rlhahn/power_distro/Gerbers/IonTrapPowerDistroBOM_RevB-6-25-2018.xlsx

Power Distro Rev B 6-25-2018
QTY | REF | PACKAGE | VALUE | COLOR | COST | DIELECTRIC | MFG | MPN | PRICE | TOLERANCE | VENDOR | VOLTAGE | VPN
14 | C1,C5,C7,C9,C13,C15,C17,C31,C37,C39,C43,C49,C55,C57, | CAP-SIZE_D/E_EIA7343 | 10U |  | 1.5 | TANT | AVX | TAJD-SERIES |  |  | DIGIKEY | 36V
6 | C2,C10,C18,C32,C44,C50, | CAP-SIZE_D/E_EIA7343 | 10U |  | 1.5 | TANT | AVX | TAJD-SERIES |  |  | DIGIKEY | 6.3V
20 | C3,C4,C6,C8,C11,C12,C14,C16,C19,C20,C33,C34,C38,C40,C45,C46,C51,C52,C56,C58, | R-0805 | 100N |  | 0.074 | X7R |  |  |  |  |  | 6.3V
10 | HS1,HS2,HS3,HS4,HS5,HS6,HS7,HS8,HS9,HS10, | AAVID_7106 | HEATSINK_AAVID_7106 |  |  |  | AAVID | 7106DG | 1.44 |  | DIGIKEY |  | HS412-ND
8 | J1,J6,J11,J16,J33,J34,J35,J36, | CUI_RCJ-02X | CONN_RCA | BLK |  |  | CUI INC | RCJ-021 | 0.88 |  | DIGIKEY |  | CP-1406-ND
8 | J2,J7,J12,J17,J37,J38,J39,J40, | CUI_RCJ-02X | CONN_RCA | BLU |  |  | CUI INC | RCJ-025 | 0.88 |  | DIGIKEY |  | CP-1410-ND
8 | J3,J8,J13,J18,J29,J30,J31,J32, | CUI_RCJ-02X | CONN_RCA | GRN |  |  | CUI INC | RCJ-026 | 0.88 |  | DIGIKEY |  | CP-1411-ND
8 | J4,J9,J14,J19,J25,J26,J27,J28, | CUI_RCJ-02X | CONN_RCA | RED |  |  | CUI INC | RCJ-022 | 0.88 |  | DIGIKEY |  | CP-1407-ND
8 | J5,J10,J15,J20,J21,J22,J23,J24, | CUI_RCJ-02X | CONN_RCA | WHT |  |  | CUI INC | RCJ-023 | 0.88 |  | DIGIKEY |  | CP-1408-ND
1 | J41, | 2X14X0.100_HDR | HDR_2X14X100 |  |  |  | SULLINS | PRPC014DAAN-RC | 1 |  | DIGIKEY |  | S2011EC-14-ND
12 | J42,J43,J44,J45,J46,J47,J48,J49,J50,J51,J52,J53, | OST_SCREWTERM_3.5MM_2POS | CONN_SCREWTERM_3.5MM_2POS |  |  |  | ON SHORE TECH | OSTTE020161 | 0.92 |  | DIGIKEY |  | ED2635-ND
2 | R1,R2, | R-0805 | 100K |  |  |  |  |  | 0.059 | 1%
4 | R3,R4,R7,R8, | R-0805 | 300K |  |  |  |  |  | 0.059
2 | R5,R6, | R-0805 | 480K |  |  |  |  |  | 0.059
2 | R9,R10, | R-0805 | 100K |  |  |  |  |  | 0.059
10 | R11,R12,R13,R14,R15,R16,R17,R18,R19,R20, | R-0805 | 2K |  |  |  |  |  | 0.059 | 1%
4 | R21,R22,R23,R24, | R-0805 | 1.1K |  |  |  |  |  | 0.059 | 1%
4 | R25,R26,R27,R28, | R-0805 | 13K |  |  |  |  |  | 0.059 | 1%
2 | R29,R30, | R-0805 | 24K |  |  |  |  |  | 0.059 | 1%
6 | U1,U3,U5,U6,U8,U9, | DD-7_LINEARTECH | REG_LT3081 |  |  |  | LINEAR TECH | LT3081ER | 6.25 |  | DIGIKEY |  | LT3081ER#PBF-ND
4 | U2,U4,U7,U10, | DD-7_LINEARTECH | REG_LT3091 |  |  |  | LINEAR TECH | LT3091IR | 8.12 |  | DIGIKEY |  | LT3091IR#PBF-ND
