rlhahn/power_distro/Datasheets/00_LDO Compare.xlsx

Sheet: Sheet1
Vendor | Part | Vin Max | Vout | Iout | PSRR | Noise uv | Pakage
Analog Devices | ADP3339 | 6 | 1.5,1.8,2.5,2.85,3,3.3,5 | 1.5 | 12.00 | 95.00 | 3 ld SOT-223
Analog Devices | ADP3330 | 12 | 2.5,2.75,2.85,3.0,3.3,3.6,5.0 | 0.2 | 13.00 | 47.00 | 6 ld SOT-23
Analog Devices | ADP3331 | 12 | Not Applicable | 0.2 | 15.00 | 47.00 | 6 ld SOT-23
Analog Devices | ADP163 | 5.5 | Adjustable | 0.15 | 20.00 | 100.00 | 5 ld TSOT
Analog Devices | ADP162 | 5.5 | 1.2,1.5,1.8,2.1,2.5,2.75,2.8,2.85,3.0,3.3,4.2 | 0.15 | 20.00 | 100.00 | 4 ball WLCSP (0.965x0.965mm),5 ld TSOT
Analog Devices | ADP161 | 5.5 | Adjustable | 0.15 | 20.00 | 100.00 | 5 ld TSOT
Analog Devices | ADP160 | 5.5 | 1.2,1.5,1.8,2.1,2.5,2.75,2.8,2.85,3.0,3.3,4.2 | 0.15 | 20.00 | 100.00 | 4 ball WLCSP (0.965x0.965mm),5 ld TSOT
Analog Devices | ADP166 | 5.5 | 1.2,1.8,2.2,2.3,2.85,3,3.3 | 0.15 | 20.00 | 105.00 | 4 ball WLCSP (0.965x0.965mm),5 ld TSOT,6 ld LFCSP (2x2 w/1x1.6 EP)
Analog Devices | ADP165 | 5.5 | 1.2,1.8,2.2,2.3,2.85,3,3.3 | 0.15 | 20.00 | 105.00 | 4 ball WLCSP (0.965x0.965mm),5 ld TSOT,6 ld LFCSP (2x2 w/1x1.6 EP)
Analog Devices | ADP151 | 5.5 | 1.1,1.2,1.5,1.8,2.1,2.5,2.6,2.75,2.8,2.85,3.0,3.3 | 0.2 | 25.00 | 9.00 | 4 ball WLCSP (0.8x0.8mm),5 ld TSOT,6 ld LFCSP (2x2 w/1x1.6 EP)
Monolithic Power | MP2002 | 6.5 | 5 | 500 | 26.00 | - | QFN2x3-8
Analog Devices | ADP3336 | 12 | Not Applicable | 0.5 | 28.00 | 27.00 | 8 ld MSOP
Analog Devices | ADP150 | 5.5 | 1.8,2.5,2.6,2.75,2.8,2.85,3.0,3.3 | 0.15 | 30.00 | 9.00 | 4 ball WLCSP (0.8x0.8mm),5 ld TSOT
Linear Tech | LT3071 | 3 | Adj | 5 | 30.00 | 25.00 | 4x5 QFN-28
Linear Tech | LT3080 | 36 | Adj | 1.1 | 30.00 | 40.00 | 3x3 DFN-8,DDPAK-5,MS-8E,SOT-223,TO-220
Analog Devices | ADM7172 | 6.5 | 1.3,1.8,2.5,3.0,3.3,4.2,5.0 | 2 | 31.00 | 5.00 | 8 ld LFCSP (3x3mm 2.44x1.6EP),CHIPS OR DIE
Analog Devices | ADM7171 | 6.5 | 1.3,1.8,2.5,3.0,3.3,4.2,5.0 | 1 | 31.00 | 5.00 | 8 ld LFCSP (3x3mm 2.44x1.6EP)
Analog Devices | ADM7170 | 6.5 | 1.3,1.8,2.5,3.0,3.3,4.2,5.0 | 0.5 | 31.00 | 5.00 | 8 ld LFCSP (3x3mm 2.44x1.6EP)
Analog Devices | ADP3300 | 12 | 2.7,2.85,3.0,3.2,3.3,5.0 | 0.05 | 32.00 | 30.00 | 6 ld SOT-23
Analog Devices | ADP3303 | 12 | 3.0,3.2,3.3,5.0 | 0.2 | 32.00 | 30.00 | 8 ld SOIC
Analog Devices | ADP3301 | 12 | 2.7,3,3.2,3.3,5 | 0.1 | 32.00 | 30.00 | 8 ld SOIC
Analog Devices | ADP3309 | 12 | 2.5,2.7,2.85,2.9,3.0,3.3,3.6 | 0.1 | 32.00 | 100.00 | 5 ld SOT-23
Analog Devices | ADP1765 | 1.98 | 0.85,0.9,0.95,1.0,1.1,1.2,1.25,1.3,1.5 | 5 | 33.00 | 2.00 | 16 ld LFCSP (3x3x0.75mm (w/1.7mm EP)
Analog Devices | ADP1764 | 1.98 | 0.85,0.9,0.95,1.0,1.1,1.2,1.25,1.3,1.6 | 4 | 35.00 | 2.00 | 16 ld LFCSP (3x3x0.75mm (w/1.7mm EP)
Analog Devices | HMC976 | 5.5 | 4.8,5.0 | 0.4 | 35.00 | 9.00 | 16 ld QFN (3x3mm w/1.7mm ep)
Monolithic Power | MP20048 | 5.5 | 5 | 250 | 35.00 | 37.00 | TSOT23-5
Analog Devices | ADP1763 | 1.98 | 0.9,0.95,1,1.1,1.2,1.25,1.3,1.5 | 3 | 37.00 | 2.00 | 16 ld LFCSP (3x3mm, 1.6mm exposed pad)
Analog Devices | ADP3334 | 11 | Not Applicable | 0.5 | 38.00 | 27.00 | 8 ld LFCSP (3x3mm),8 ld MSOP,8 ld SOIC
Analog Devices | ADP3333 | 12 | 1.5,1.8,2.5,2.77,3,3.15,3.3,5 | 0.3 | 38.00 | 45.00 | 8 ld MSOP
Analog Devices | ADP3335 | 12 | 1.8,2.5,2.85,3.3,5 | 0.5 | 38.00 | 47.00 | 8 ld LFCSP (3x3mm),8 ld MSOP
Analog Devices | ADP3338 | 8 | 1.5,1.8,2.5,2.85,3,3.3,5 | 1 | 38.00 | 95.00 | 3 ld SOT-223
Analog Devices | ADP1708 | 5.5 | Not Applicable | 1 | 38.00 | 125.00 | 8 ld LFCSP (3x3mm 1.74x1.45mm EP),8 ld SOIC-EP (2.41mm Exposed pad)
Analog Devices | ADP1707 | 5.5 | 1,1.1,1.2,1.3,1.5,1.8,2.5,3,3.3 | 1 | 38.00 | 125.00 | 8 ld LFCSP (3x3mm),8 ld SOIC-EP (2.41mm Exposed pad)
Analog Devices | ADP1706 | 5.5 | 0.75,0.8,0.9,1,1.05,1.1,1.15,1.2,1.3,1.5,1.8,2.5,3,3.3 | 1 | 38.00 | 125.00 | 8 ld LFCSP (3x3mm 1.74x1.45mm EP),8 ld LFCSP (3x3mm),8 ld SOIC-EP (2.41mm Exposed pad)
Analog Devices | ADP1762 | 1.98 | 0.9,0.95,1,1.1,1.2,1.25,1.3,1.5 | 2 | 39.00 | 2.00 | 16 ld LFCSP (3x3mm, 1.6mm exposed pad)
Analog Devices | ADP7183 | -5.5 | -0.5,-1,-1.2,-1.5,-1.8,-2.5,-3,-3.3,Adjustable | -0.3 | 40.00 | 4.00 | 8 ld LFCSP (2x2 w/1.5x1mm EP)
Analog Devices | ADP7185 | -5.5 | -0.5,-1,-1.2,-1.5,-1.8,-2.5,-3,-3.3,Adjustable | -0.5 | 40.00 | 5.00 | 8 ld LFCSP (2x2 w/1.5x1mm EP)
Analog Devices | ADP323 | 5.5 | Not Applicable | 0.2 | 40.00 | 14.00 | 16 ld LFCSP (3x3mm, 1.5mm exposed pad)
Analog Devices | ADP322 | 5.5 | 1.2,1.5,1.8,2.5,2.8,3.3 | 0.2 | 40.00 | 14.00 | 16 ld LFCSP (3x3mm, 1.6mm exposed pad)
Analog Devices | ADP1755 | 3.6 | Adjustable | 1.2 | 40.00 | 23.00 | 16 ld LFCSP (4x4mm, 2.1mm exposed pad)
Analog Devices | ADP1754 | 3.6 | 0.75,1.0,1.1,1.2,1.3,1.5,1.8,2.5 | 1.2 | 40.00 | 23.00 | 16 ld LFCSP (4x4mm, 2.1mm exposed pad)
Analog Devices | ADP1753 | 3.6 | Adjustable | 0.8 | 40.00 | 23.00 | 16 ld LFCSP (4x4x.85mm, 2.10mm exposed pad)
Analog Devices | ADP1752 | 3.6 | 0.75,1.0,1.1,1.2,1.25,1.5,1.8,2.5 | 0.8 | 40.00 | 23.00 | 16 ld LFCSP (4x4x.85mm, 2.10mm exposed pad)
Analog Devices | ADP1741 | 3.6 | Not Applicable | 2 | 40.00 | 23.00 | 16 ld LFCSP (4x4mm, 2.1mm exposed pad)
Analog Devices | ADP1740 | 3.6 | 0.75,1.0,1.1,1.2,1.3,1.5,1.8,2.5 | 2 | 40.00 | 23.00 | 16 ld LFCSP (4x4mm, 2.1mm exposed pad)
Analog Devices | ADP320 | 5.5 | 1.5,1.8,3.3 | 0.2 | 40.00 | 24.00 | 16 ld LFCSP (3x3mm, 1.6mm exposed pad)
Analog Devices | ADP225 | 5.5 | Adjustable | 0.3 | 40.00 | 27.00 | 8 ld LFCSP (2x2, w/1.6 x1.0 ep)
Analog Devices | ADP224 | 5.5 | 1.8,2.8 | 0.3 | 40.00 | 27.00 | 8 ld LFCSP (2x2, w/1.6 x1.0 ep)
Analog Devices | ADP222 | 5.5 | 1.2,1.5,1.8,2.5,2.7,2.8,3.0,3.3 | 0.3 | 40.00 | 27.00 | 8 ld LFCSP (2x2, w/1.6 x1.0 ep)
Analog Devices | ADP223 | 5.5 | Not Applicable | 0.3 | 40.00 | 27.00 | 8 ld LFCSP (2x2, w/1.6 x1.0 ep)
Analog Devices | ADP221 | 5.5 | 1.8,2.8 |  | 40.00 | 27.00 | BUMPED BARE DIE SALES
Analog Devices | ADP220 | 5.5 | 1.1,1.2,1.8,2.3,2.35,2.6,2.7,2.75,2.8,3,3.3 |  | 40.00 | 27.00 | 6 Ball WLCSP (1.0x1.5mm)
Analog Devices | ADP5030 | 5.5 | 1.2,2.8 | 0.2 | 40.00 | 50.00 | 16 Ball WLCSP(1.56X1.56)
Analog Devices | ADP1761 | 1.98 | 0.9,0.95,1,1.1,1.2,1.25,1.3,1.5 | 1 | 41.00 | 2.00 | 16 ld LFCSP (3x3mm, 1.6mm exposed pad)
Monolithic Power | MPQ2013A | 40 | 15 | 150 | 41.00 | - | QFN2x2-6QFN3x3-8
Monolithic Power | MP2013A | 40 | 15 | 150 | 41.00 | - | QFN2x2-6 QFN3x3-8
Monolithic Power | MP2011A | 24 | 15 | 150 | 41.00 | - | QFN2x2-6
Monolithic Power | MP2015A | 24 | 15 | 150 | 41.00 | - | QFN2x2-6 QFN3x3-8 TSOT23-4
Linear Tech | LTC3026-1 | 5 | Adj | 1.5 | 42.00 | 110.00 | 3x3 DFN-10,MS-10E
Linear Tech | LTC3026 | 5.5 | Adj | 1.5 | 42.00 | 110.00 | 3x3 DFN-10,MS-10E
Analog Devices | ADM7160 | 5.5 | 1.8,2.5,3.3 | 0.2 | 43.00 | 3.00 | 5 ld TSOT,6 ld LFCSP (2x2 w/1x1.6 EP)
Analog Devices | ADP7159 | 5.5 | Adjustable | 2 | 45.00 | 1.60 | 10 ld LFCSP (3x3mm),8 ld SOIC-EP
Analog Devices | ADP7182 | -28 | -1.2,-1.5,-1.8,-2.5,-3,-5,5 | -0.2 | 45.00 | 18.00 | 5 ld TSOT,6 ld LFCSP (2x2 w/1x1.6 EP),8 ld LFCSP (3x3mm 1.74x1.45mm EP),LFCSP:LEADFRM CHIP SCALE
Monolithic Power | MP2019 | 40 | 15 | 300 | 45.00 | - | SOIC-8
Monolithic Power | MP2014 | 40 | 15 | 500 | 45.00 | - | TO252-5
Monolithic Power | MPQ2019 | 40 | 15 | 300 | 45.00 | - | SOIC-8
Analog Devices | ADP7158 | 5.5 | 1.2,1.8,2.5,2.8,3.0,3.3 | 2 | 50.00 | 1.60 | 10 ld LFCSP (3x3mm),8 ld SOIC-EP
Analog Devices | ADP7142 | 40 | 1.8,2.5,3.3,5 | 0.2 | 50.00 | 11.00 | 5 ld TSOT,6 ld LFCSP (2x2 w/1x1.6 EP),8 ld SOIC-EP
Analog Devices | ADP7118 | 20 | 1.8,2.5,3.3,5 | 0.2 | 50.00 | 11.00 | 5 ld TSOT,6 ld LFCSP (2x2 w/1x1.6 EP),8 ld SOIC-EP
Analog Devices | ADP7112 | 20 | 1.8,2.5,3.3,5 | 0.2 | 50.00 | 11.00 | 6-Ball Wafer Level Chip Scale Package [WLCSP]
Linear Tech | LTC1844 | 6.5 | Adj,1.5, 1.8, 2.5,2.8, 3.3 | 0.15 | 50.00 | 60.00 | SOT-23
Monolithic Power | MP8903 | 6.5 | 5 | 150 | 50.00 | - | QFN2x2-8TSOT23-5
Monolithic Power | MPQ8903 | 6.5 | 5 | 150 | 50.00 | - | TSOT23-5
Monolithic Power | MP2016 | 42 | 40 | 30 | 50.00 | - | TSOT23-5QFN2x3-8
Monolithic Power | MP2000 | 6 | 5 | 150 | 50.00 | - | TSOT23-5
Analog Devices | ADP7157 | 5.5 | Adjustable | 1.2 | 55.00 | 1.60 | 10 ld LFCSP (3x3mm),8 ld SOIC-EP
Analog Devices | ADM7151 | 16 | Not Applicable | 0.8 | 55.00 | 1.60 | 8 ld LFCSP (3x3mm, 1.6x2.34mm exposed pad,8 ld SOIC-EP (2.41mm Exposed pad)
Analog Devices | ADM7150 | 16 | 1.8,2.8,3.0,3.3,4.5,4.8,5.0 | 0.8 | 55.00 | 1.60 | 8 ld LFCSP (3x3mm, 1.6x2.34mm exposed pad,8 ld SOIC-EP (2.41mm Exposed pad)
Monolithic Power | MP20045 | 5.5 | 5 | 1000 | 56.00 | 13.00 | QFN3x3-8SOIC8E
Analog Devices | ADM7155 | 5.5 | Not Applicable | 0.6 | 57.00 | 1.60 | 8 ld LFCSP (3x3mm 2.44x1.6EP),8 ld SOIC-EP
Analog Devices | ADM7154 | 5.5 | 1.2,1.8,2.5,2.8,3.0,3.3 | 0.6 | 58.00 | 1.60 | 8 ld LFCSP (3x3mm 2.44x1.6EP),8 ld SOIC-EP
Analog Devices | ADP7156 | 5.5 | 1.2,1.8,2.5,2.8,3.0,3.3 | 1.2 | 60.00 | 1.60 | 10 ld LFCSP (3x3mm),8 ld SOIC-EP
Analog Devices | HMC860 | 5.6 | 3.05,4.5,5.0 | 0.24 | 60.00 | 5.50 | 16 ld QFN (3x3mm w/1.7mm ep)
Analog Devices | HMC1060 | 5.6 | 3.3,5.0 | 0.5 | 60.00 | 9.00 | 16 ld QFN (3x3mm w/1.7mm ep)
Linear Tech | LT3030 | 20 | Adj | 0.75 | 60.00 | 20.00 | 4x5 QFN-28,TSSOP-20
Linear Tech | LT1529 | 15 | Adj, 3.3, 5 | 3 | 62.00 |  | DDPAK-5,TO-220
Monolithic Power | MPQ20051-AEC1 | 5.5 | 5 | 1000 | 63.00 | 13.00 | QFN3x3-8
Monolithic Power | MPQ20051 | 5.5 | 5 | 1000 | 63.00 | 13.00 | QFN3x3-8
Monolithic Power | MPQ20056 | 5.5 | 5 | 250 | 63.00 | 13.00 | QFN2x2-8TSOT23-5
Monolithic Power | MPQ20056-AEC1 | 5.5 | 5 | 250 | 63.00 | 13.00 | QFN2x2-8TSOT23-5
Monolithic Power | MP20051 | 5.5 | 5 | 1000 | 63.00 | 13.00 | SOIC8EQFN3x3-8
Linear Tech | LT1963A | 20 | Adj, 1.5, 1.8, 2.5, 3.3 | 1.5 | 63.00 | 40.00 | DDPAK-5,SO-8,SOT-223,TO-220,TSSOP-16
Linear Tech | LT1764A | 20 | Adj, 1.8, 2.5, 3.3 | 3 | 63.00 | 40.00 | DDPAK-5,TO-220,TSSOP-16
Linear Tech | LT3020 | 10 | Adj, 1.2, 1.5, 1.8 | 0.1 | 64.00 | 245.00 | 3x3 DFN-8,MS-8
Linear Tech | LT1129 | 30 | Adj, 3.3, 5 | 0.7 | 64.00 |  | DDPAK-5,SO-8,SOT-223,TO-220
Monolithic Power | MP20056 | 5.5 | 5 | 250 | 65.00 | 13.00 | QFN2x2-8TSOT23-5
Linear Tech | LT3027 | 20 | Adj | 0.1 | 65.00 | 20.00 | 3x3 DFN-10,MS-10E
Linear Tech | LT3023 | 20 | Adj | 0.1 | 65.00 | 20.00 | 3x3 DFN-10,MS-10E
Linear Tech | LT1761 | 20 | Adj, 1.2, 1.5, 1.8, 2, 2.5, 2.8, 3, 3.3, 5 | 0.1 | 65.00 | 20.00 | SOT-23
Linear Tech | LT1762 | 20 | Adj, 2.5, 3, 3.3, 5 | 0.15 | 65.00 | 20.00 | MS-8
Linear Tech | LT1962 | 20 | Adj,1.5, 1.8, 2.5, 3, 3.3, 5 | 0.3 | 65.00 | 20.00 | MS-8
Linear Tech | LT1763 | 20 | Adj,1.5, 1.8, 2.5, 3, 3.3, 5 | 0.5 | 65.00 | 20.00 | 4x3 DFN-12,SO-8
Linear Tech | LT3028 | 20 | Adj | 0.5 | 65.00 | 20.00 | 5x3 DFN-16,TSSOP-16
Linear Tech | LT3024 | 20 | Adj | 0.5 | 65.00 | 20.00 | 4x3 DFN-12,TSSOP-16
Monolithic Power | MP2030 | 5.5 | 3.8 | 3000 | 65.00 | 80.00 | QFN3x3-10QFN5x5-32
Monolithic Power | MP2005 | 5.5 | 4 | 800 | 65.00 | - | QFN2x3-8
Monolithic Power | MP8904 | 6.5 | 5 | 500 | 65.00 | - | QFN2x3-8
Linear Tech | LT3029 | 20 | Adj | 0.5 | 67.00 | 30.00 | 4x3 DFN-16,MS-16E
Linear Tech | LT1528 | 15 | Adj, 3.3 | 3 | 67.00 |  | DDPAK-5,TO-220
Monolithic Power | MP20046 | 5.5 | 3.3 | 2000 | 70.00 | 17.00 | QFN3x3-10SOIC8E
Monolithic Power | MP2040 | 5 | 3.3 | 3000 | 70.00 | 80.00 | QFN3x3-10QFN5x5-32
Linear Tech | LT3008 | 45 | Adj, 1.2, 1.5, 1.8, 2.5, 3.3, 5 | 0.02 | 70.00 | 92.00 | 2x2 DFN-6,SOT-23
Linear Tech | LT3007 | 45 | Adj, 1.2, 1.5, 1.8, 2.5, 3.3, 5 | 0.02 | 70.00 | 92.00 | SOT-23
Linear Tech | LT3014 | 80 | Adj | 0.02 | 70.00 | 115.00 | 3x3 DFN-8,SOT-23
Linear Tech | LT3014B | 80 | Adj | 0.02 | 70.00 | 150.00 | 3x3 DFN-8,SOT-23
Linear Tech | LT3022 | 10 | Adj, 1.2, 1.5, 1.8 | 1 | 70.00 | 165.00 | 5x3 DFN-16,MS-16E
Linear Tech | LT3021 | 10 | Adj, 1.2, 1.5, 1.8 | 0.5 | 70.00 | 300.00 | 5x5 DFN-16,SO-8
Monolithic Power | MP8902 | 6.5 | 5 | 250 | 70.00 | - | QFN2x2-8
Monolithic Power | MP8801 | 6.5 | 5 | 150 | 70.00 | - | TSOT23-5
Monolithic Power | MP8802 | 6.5 | 5 | 250 | 70.00 | - | TSOT23-5
Linear Tech | LT3070 | 3 | Adj | 5 | 72.00 | 25.00 | 4x5 QFN-28
Linear Tech | LT3009 | 20 | Adj, 1.2, 1.5, 1.8, 2.5, 3.3, 5 | 0.02 | 72.00 | 150.00 | 2x2 DFN-6,SC-70
Linear Tech | LT1085-Fixed | 25 | 3.3, 3.6, 5, 12 | 3 | 72.00 |  | DDPAK-3,TO-220
Linear Tech | LT1587 | 7 | Adj, 1.5, 3.3, 3.45, 3.6 | 3 | 72.00 |  | DDPAK-3,TO-220
Linear Tech | LT1084-Fixed | 25 | 3.3, 3.6, 5, 12 | 5 | 72.00 |  | TO-220
Linear Tech | LT3080-1 | 36 | Adj | 1.1 | 75.00 | 40.00 | 3x3 DFN-8,MS-8E
Linear Tech | LT1965 | 20 | Adj, 1.5, 1.8, 2.5, 3.3 | 1.1 | 75.00 | 40.00 | 3x3 DFN-8,DDPAK-5,MS-8E,TO-220
Linear Tech | LT3010 | 80 | Adj | 0.05 | 75.00 | 100.00 | MS-8E
Linear Tech | LT3010-5 | 80 | 5 | 0.05 | 75.00 | 100.00 | MS-8E
Linear Tech | LT3012 | 80 | Adj | 0.25 | 75.00 | 100.00 | 4x3 DFN-12,TSSOP-16
Linear Tech | LT3012B | 80 | Adj | 0.25 | 75.00 | 100.00 | 4x3 DFN-12,TSSOP-16
Linear Tech | LT3013 | 80 | Adj | 0.25 | 75.00 | 100.00 | 4x3 DFN-12,TSSOP-16
Linear Tech | LT3013B | 80 | Adj | 0.25 | 75.00 | 100.00 | 4x3 DFN-12,TSSOP-16
Linear Tech | LT1117 | 15 | Adj, 2.85, 3.3, 5 | 0.8 | 75.00 |  | DDPAK-3,SOT-223
Linear Tech | LT1086 | 25 | Adj, 2.85, 3.3, 3.6, 5, 12 | 1.5 | 75.00 |  | DDPAK-3,TO-220
Linear Tech | LT1085 | 30 | Adj | 3 | 75.00 |  | DDPAK-3,TO-220
Linear Tech | LT1084 | 30 | Adj | 5 | 75.00 |  | TO-220
Linear Tech | LT3045-1 | 20 |  | 0.5 | 76.00 | 0.80 | 3x3 DFN-12,MS-12E
Linear Tech | LT3045 | 20 | Adj | 0.5 | 76.00 | 0.80 | 3x3 DFN-10,MS-12E
Monolithic Power | MP20049 | 6 | - | 150 | 78.00 | 16.00 | WLCSP0.8x0.8-4
Monolithic Power | MP2009 | 6 | - | 120 | 78.00 | 16.00 | SC70-5
Monolithic Power | MPQ8904-AEC1 | 6.5 | 5 | 500 | 78.00 | - | QFN2x3-8
Linear Tech | LT3086 | 40 | Adj | 2.1 | 80.00 | 40.00 | 5x4 DFN-16,DDPAK-7,TO-220,TSSOP-16
Linear Tech | LT1118 | 15 | 2.5, 2.85, 5 | 0.8 | 80.00 |  | SO-8,SOT-223
Linear Tech | LT3055 | 45 | Adj | 0.5 | 85.00 | 25.00 | 4x3 DFN-16,MS-16E
Linear Tech | LT3066 | 45 | Adj | 0.5 | 85.00 | 25.00 | 4x3 DFN-12,MS-12E
Linear Tech | LT3065 | 45 | Adj, 1.2, 1.5, 1.8, 2.5, 3.3, 5 | 0.5 | 85.00 | 25.00 | 3x3 DFN-10,MS-12E
Linear Tech | LT3061 | 45 | Adj | 0.1 | 85.00 | 30.00 | 2x3 DFN-8,MS-8E
Linear Tech | LT3060 | 45 | Adj, 1.2,1.5, 1.8, 2.5, 3.3, 5, 15 | 0.1 | 85.00 | 30.00 | 2x2 DFN-8,SOT-23
Linear Tech | LT3050 | 45 | Adj, 3.3, 5 | 0.1 | 85.00 | 30.00 | 3x2 DFN-12,MS-12E
Linear Tech | LT3062 | 45 | Adj | 0.2 | 85.00 | 30.00 | 2x3 DFN-8,MS-8E
Linear Tech | LT3063 | 45 | Adj | 0.2 | 85.00 | 30.00 | 2x3 DFN-8,MS-8E
Linear Tech | LT3083 | 23 | Adj | 3 | 85.00 | 40.00 | 4x4 DFN-12,DDPAK-5,TO-220,TSSOP-16
Linear Tech | LT3011 | 80 | Adj | 0.05 | 85.00 | 100.00 | 3x3 DFN-10,MS-12E
Linear Tech | LT3088 | 36 | Adj | 0.8 | 90.00 | 27.00 | 3x3 DFN-8,DDPAK-3,SOT-223
Linear Tech | LT3089 | 36 | Adj | 0.8 | 90.00 | 27.00 | 4x4 DFN-12,DDPAK-7,TSSOP-16
Linear Tech | LT3081 | 36 | Adj | 1.5 | 90.00 | 27.00 | 4x4 DFN-12,DDPAK-7,TO-220,TSSOP-16
Linear Tech | LT3082 | 40 | Adj | 0.2 | 90.00 | 33.00 | 3x3 DFN-8,SOT-223,SOT-23
Linear Tech | LT3085 | 36 | Adj | 0.5 | 90.00 | 40.00 | 2x3 DFN-6,MS-8E
Linear Tech | LT3042 | 20 | Adj | 0.2 | 117.00 | 0.80 | 3x3 DFN-10,MS-10E
Onsemi | 0 | 30 | 3.3 |  |  | 13.2 | SOT-23-3
Analog Devices | ADP7105 | 20 | 1.8,3.3,5.0 | 0.5 |  | 15.00 | 8 ld LFCSP (3x3mm 1.74x2.38 EP) ,8 ld SOIC-EP (2.41mm Exposed pad)
Analog Devices | ADP7104 | 20 | 1.5,1.8,2.5,3.0,3.3,5.0,9.0,Adjustable | 0.5 |  | 15.00 | 8 ld LFCSP (3x3mm 1.74x2.38 EP) ,8 ld SOIC-EP (2.41mm Exposed pad)
Analog Devices | ADP7102 | 20 | 1.5,1.8,2.5,3.0,3.3,5.0,9.0 | 0.3 |  | 15.00 | 8 ld LFCSP (3x3mm 1.74x2.38 EP) ,8 ld SOIC-EP (2.41mm Exposed pad)
Analog Devices | ADP125 | 5.5 | Not Applicable | 0.5 |  | 25.00 | 8 ld LFCSP (2x2mm w/1.6x1.0 EP),8 ld MSOP_ED
Analog Devices | ADP124 | 5.5 | 1.8,2.5,2.7,2.8,2.85,2.9,3.0,3.3 | 0.5 |  | 25.00 | 8 ld LFCSP (2x2mm w/1.6x1.0 EP),8 ld MSOP_ED,EXPOSSED PAD SOIC
Analog Devices | ADP123 | 5.5 | Not Applicable | 0.3 |  | 25.00 | 5 ld TSOT,6 ld LFCSP (2x2 w/1x1.6 EP)
Analog Devices | ADP122 | 5.5 | 1.8,2,2.5,2.7,2.8,2.85,2.9,3,3.3 | 0.3 |  | 25.00 | 5 ld TSOT,6 ld LFCSP (2x2 w/1x1.6 EP)
Analog Devices | ADP130 | 3.6 | 0.8,1.2,1.5,1.8,2.5 | 0.35 |  | 29.00 | 5 ld TSOT
Onsemi | 0 | 6.5 | 1.5 1.8 2.5 2.8 2.9 3 3.3 | 0.15 |  | 30 | SC-82AB-4 SOT-563
Onsemi | 0 | 6 | 0.9 1.2 1.5 1.8 2.5 2.6 2.8 3 3.1 3.3 | 0.2 |  | 30 | SOT-23-5
Onsemi | 0 | 6 | 0.9 1 1.2 1.25 1.5 1.8 2.5 3 3.3 | 0.3 |  | 30 | SOT-23-5
Analog Devices | ADP172 | 3.6 | 0.9,1,1.2,1.26,1.5,1.65,1.7,1.8,2.1,2.9,3 | 0.3 |  | 30.00 | 4 ball WLCSP (1.02x0.95mm)
Analog Devices | ADP171 | 3.6 | Not Applicable | 0.3 |  | 30.00 | 5 ld TSOT
Analog Devices | ADP170 | 3.6 | 1.2,1.25,1.5,1.8,2.5,2.8 | 0.3 |  | 30.00 | 5 ld TSOT
Onsemi | 0 | 9 | 1.2 1.8 2.5 | 1.5 |  | 37 | SOT-223-4 / TO-261-4
Analog Devices | ADP121 | 5.5 | 1.2,1.5,1.65,1.8,1.875,2.0,2.5,2.8,3.0,3.3 | 0.15 |  | 40.00 | 4 ball WLCSP (.82x.82mm) ,5 ld TSOT
Analog Devices | ADP120 | 5.5 | 1.2,1.5,1.8,2.5,2.8,3,3.3 | 0.1 |  | 40.00
Analog Devices | ADP1713 | 5.5 | 0.75,0.8,0.85,0.9,0.95,1.0,1.05,1.1,1.15,1.2,1.3,1.5,1.8,2.5,3.0,3.3 | 0.3 |  | 40.00 | 5 ld TSOT
Analog Devices | ADP1711 | 5.5 | 0.75,0.8,0.85,0.9,0.95,1.0,1.05,1.1,1.15,1.2,1.3,1.5,1.8,2.5,3.0,3.3 | 0.15 |  | 40.00 | 5 ld TSOT
Onsemi | 0 | 13 | 1.8 2.5 3.3 | 0.3 |  | 46 | SOIC-8 SOT-223-4 / TO-261-4
Onsemi | 0 | 35 | 5 | 1 |  | 50 | D<sup>2</sup>PAK-3 DPAK-3 TO-220-3
Onsemi | 0 | 30 | Adjustable | 0.1 |  | 56 | SOIC-8
Onsemi | 0 | 30 | 8 | 0.1 |  | 60 | SOIC-8
Onsemi | 0 | 35 | 8 | 1 |  | 80 | D<sup>2</sup>PAK-3 DPAK-3 TO-220-3
Onsemi | 0 | 12 | 1.5 1.8 2.5 2.7 2.8 3 3.3 4 5 | 0.08 |  | 89 | SOT-89-3 TSOP-5 / SOT-23-5
Onsemi | 0 | 12 | 1.5 3 5 | 0.08 |  | 90 | SC-82AB-4
Onsemi | 0 | 35 | 9 | 1 |  | 90 | D<sup>2</sup>PAK-3 TO-220-3
Onsemi | 0 | 6 | 1.5 1.8 2.5 2.7 2.8 3 3.1 3.3 3.7 5 | 0.1 |  | 100 | SC-88A
Onsemi | 0 | 6 | 1.3 1.5 1.8 2.5 2.8 3 3.3 3.5 5 | 0.15 |  | 100 | SC-82AB-4
Onsemi | 0 | 6 | 1.5 1.8 2.5 2.7 2.8 3 3.1 3.3 3.7 5 | 0.1 |  | 100 | SC-88A
Onsemi | 0 | 6 | 1.5 1.8 2.5 2.7 2.8 3 3.3 5 | 0.1 |  | 100 | SC-82AB-4
Onsemi | 0 | 6 | 1.5 1.8 2.5 2.7 2.8 3 3.3 5 | 0.1 |  | 100 | SC-82AB-4
Onsemi | 0 | 6 | 1.5 1.8 2.5 2.7 2.8 3 3.3 5 | 0.15 |  | 110 | TSOP-5 / SOT-23-5
Onsemi | 0 | 35 | 12 | 1 |  | 120 | D<sup>2</sup>PAK-3 TO-220-3
Analog Devices | ADP1720 | 28 | 3.3,5.0 | 0.05 |  | 124.00 | 8 ld MSOP
Analog Devices | ADP1716 | 5.5 | 0.75,0.8,0.85,0.9,0.95,1.0,1.05,1.1,1.15,1.2,1.3,1.5,1.8,2.5,3.0,3.3 | 0.5 |  | 125.00 | 8 ld MSOP
Analog Devices | ADP1715 | 5.5 | 0.75,0.8,0.85,0.9,0.95,1.0,1.05,1.1,1.15,1.2,1.3,1.5,1.8,2.5,3.0,3.3 | 0.5 |  | 125.00 | 8 ld MSOP
Onsemi | 0 | 35 | 15 | 1 |  | 150 | D<sup>2</sup>PAK-3 DPAK-3 TO-220-3
Onsemi | 0 | 12 | 3.47 Adjustable | 3 |  | 210 | D<sup>2</sup>PAK-5
Analog Devices | ADP1710 | 5.5 | 0.75,0.8,0.85,0.9,0.95,1,1.05,1.1,1.15,1.2,1.3,1.5,1.8,2.5,3,3.3 | 0.15 |  | 330.00 | 5 ld TSOT
Analog Devices | ADP1714 | 5.5 | 0.75,0.8,0.85,0.9,0.95,1.0,1.05,1.1,1.15,1.2,1.3,1.5,1.8,2.5,3.0,3.3 | 0.3 |  | 380.00 | 5 ld TSOT
Analog Devices | ADP1712 | 5.5 | 0.75,0.8,0.85,0.9,0.95,1,1.05,1.1,1.15,1.2,1.3,1.5,1.8,2.5,3,3.3 | 0.3 |  | 380.00 | 5 ld TSOT
Onsemi | 0 | 18 | Adjustable | 3 |  | 400 | D<sup>2</sup>PAK-5
Onsemi | 0 |  |  |  |  |  | UDFN-8
Onsemi | 0 | 6.5 |  |  |  |  | SOT-23-5
Onsemi | 0 | 6.5 | 2.5 |  |  |  | SOT-23-5
Onsemi | 0 | 6.5 | 3.3 |  |  |  | SOT-23-5
Onsemi | 0 | 6.5 |  |  |  |  | SOT-23-5
Onsemi | 0 | 6.5 | 3.3 |  |  |  | SOT-23-5
Onsemi | 0 | 5.5 |  |  |  |  | DFN-6 SOT-23-5 TSOT-23-6
Onsemi | 0 |  |  |  |  |  | WLCSP-4
Onsemi | 0 | 35 | 5 |  |  |  | TO-220-4 FullPak
Onsemi | 0 | 35 | 12 |  |  |  | TO-220-4 FullPak
Onsemi | 0 | 35 | 3.3 |  |  |  | TO-220-4 FullPak
Onsemi | 0 | 35 |  |  |  |  | TO-220-4 FullPak
Onsemi | 0 | -40 | -1.25 | 1.5 |  |  | TO-220-3
Onsemi | 0 | 35 | 5 |  |  |  | TO-220-4 FullPak
Onsemi | 0 | 35 | 12 |  |  |  | TO-220-4 FullPak
Onsemi | 0 | 35 | 3.3 |  |  |  | TO-220-4 FullPak
Onsemi | 0 |  |  |  |  |  | TO-92-3 LF
Onsemi | 0 | 35 | 5 | 1 |  |  | TO-220-3
Onsemi | 0 | 35 | 5 | 1 |  |  | DPAK-3 TO-220-3
Onsemi | 0 | 35 | 6 | 1 |  |  | TO-220-3
Onsemi | 0 | 35 | 8 | 1 |  |  | DPAK-3 TO-220-3
Onsemi | 0 | 35 | 9 | 1 |  |  | TO-220-3
Onsemi | 0 | 35 | 9 | 1 |  |  | DPAK-3 TO-220-3
Onsemi | 0 | 35 | 10 | 1 |  |  | TO-220-3
Onsemi | 0 | 35 | 10 | 1 |  |  | TO-220-3
Onsemi | 0 | 35 | 12 | 1 |  |  | TO-220-3
Onsemi | 0 | 35 | 12 | 1 |  |  | DPAK-3 TO-220-3
Onsemi | 0 | 35 | 15 | 1 |  |  | TO-220-3
Onsemi | 0 | 35 | 15 | 1 |  |  | TO-220-3
Onsemi | 0 | 35 | 18 | 1 |  |  | TO-220-3
Onsemi | 0 | 40 | 24 | 1 |  |  | TO-220-3
Onsemi | 0 | 40 | 24 | 1 |  |  | TO-220-3
Onsemi | 0 | 30 | 5 | 0.1 |  |  | SOIC-8 SOT-89-3
Onsemi | 0 | 35 | 5 | 0.5 |  |  | DPAK-3 TO-220-3
Onsemi | 0 | 35 | 5 |  |  |  | TO-220-4 FullPak
Onsemi | 0 | 35 | 8 |  |  |  | TO-220-4 FullPak
Onsemi | 0 | 35 | 9 |  |  |  | TO-220-4 FullPak
Onsemi | 0 | 35 | 12 |  |  |  | TO-220-4 FullPak
Onsemi | 0 | 35 | 15 |  |  |  | TO-220-4 FullPak
Onsemi | 0 | 35 | 3.3 |  |  |  | TO-220-4 FullPak
Onsemi | 0 | 15 | 3.3 |  |  |  | DPAK-3
Onsemi | 0 | 20 | 3.3 |  |  |  | DPAK-3
Onsemi | 0 | -35 | -5 | 1 |  |  | TO-220-3
Onsemi | 0 | -35 | -6 | 1 |  |  | TO-220-3
Onsemi | 0 | -35 | -8 | 1 |  |  | TO-220-3
Onsemi | 0 | -35 | -9 | 1 |  |  | TO-220-3
Onsemi | 0 | -35 | -12 | 1 |  |  | TO-220-3
Onsemi | 0 | -35 | -12 | 1 |  |  | TO-220-3
Onsemi | 0 | -35 | -15 | 1 |  |  | TO-220-3
Onsemi | 0 | -35 | -15 | 1 |  |  | TO-220-3
Onsemi | 0 | -35 | -18 | 1 |  |  | TO-220-3
Onsemi | 0 | -35 | -24 | 1 |  |  | TO-220-3
Onsemi | 0 | -30 | -5 | 0.1 |  |  | SOT-89-3 TO-92-3 LF
Onsemi | 0 | -35 | -5 | 0.5 |  |  | DPAK-3 TO-220-3
Onsemi | 0 | -35 | -12 | 0.5 |  |  | DPAK-3
Onsemi | 0 | 60 | 1.25 | 1.5 |  |  | TO-220-3
Onsemi | 0 | 35 | Adjustable | 3 |  |  | TO-220-3
Onsemi | 0 | 30 | 5 | 0.1 |  |  | TO-92-3 TO-92-3 LF
Onsemi | 0 | 35 | 12 | 0.1 |  |  | TO-92-3 TO-92-3 LF
Onsemi | 0 | 35 | 5 | 0.5 |  |  | TO-220-3
Onsemi | 0 | -35 | -5 | 1 |  |  | TO-220-3
Onsemi | 0 | -35 | -9 | 1 |  |  | TO-220-3
Onsemi | 0 | -35 | -10 | 1 |  |  | TO-220-3
Onsemi | 0 | -35 | -12 | 1 |  |  | TO-220-3
Onsemi | 0 | -35 | -15 | 1 |  |  | TO-220-3
Onsemi | 0 | -35 | -18 | 1 |  |  | TO-220-3
Onsemi | 0 | -30 | -5 | 0.1 |  |  | TO-92-3
Onsemi | 0 | -35 | -5 | 0.5 |  |  | TO-220-3
Onsemi | 0 |  |  |  |  |  | SOIC-8
Onsemi | 0 | 15 | 2.85 | 0.8 |  |  | SOIC-8
Onsemi | 0 | 35 | 5 | 1 |  |  | DPAK-3
Onsemi | 0 | 35 | 6 | 1 |  |  | D<sup>2</sup>PAK-3 TO-220-3
Onsemi | 0 | 35 | 6 | 1 |  |  | TO-220-3
Onsemi | 0 | 35 | 8 | 1 |  |  | D<sup>2</sup>PAK-3 DPAK-3 TO-220-3
Onsemi | 0 | 35 | 8 | 1 |  |  | D<sup>2</sup>PAK-3 TO-220-3
Onsemi | 0 | 35 | 9 | 1 |  |  | D<sup>2</sup>PAK-3 TO-220-3
Onsemi | 0 | 35 | 9 | 1 |  |  | TO-220-3
Onsemi | 0 | 35 | 12 | 1 |  |  | D<sup>2</sup>PAK-3 DPAK-3 TO-220-3
Onsemi | 0 | 35 | 12 | 1 |  |  | D<sup>2</sup>PAK-3 TO-220-3
Onsemi | 0 | 35 | 12 | 1 |  |  | DPAK-3
Onsemi | 0 | 35 | 15 | 1 |  |  | D<sup>2</sup>PAK-3 TO-220-3
Onsemi | 0 | 35 | 18 | 1 |  |  | D<sup>2</sup>PAK-3 TO-220-3
Onsemi | 0 | 35 | 18 | 1 |  |  | TO-220-3
Onsemi | 0 | 40 | 24 | 1 |  |  | D<sup>2</sup>PAK-3 TO-220-3
Onsemi | 0 | 40 | 24 | 1 |  |  | TO-220-3
Onsemi | 0 | 10 | 3 | 0.12 |  |  | SOT-89-3
Onsemi | 0 | 10 | 3.3 | 0.12 |  |  | SOT-89-3
Onsemi | 0 | 10 | 4 | 0.12 |  |  | SOT-89-3
Onsemi | 0 | 10 | 5 | 0.12 |  |  | SOT-89-3
Onsemi | 0 | 30 | 5 | 0.1 |  |  | TO-92-3 LF
Onsemi | 0 | 30 | 6 | 0.1 |  |  | TO-92-3
Onsemi | 0 | 35 | 5 | 0.5 |  |  | DPAK-3 TO-220-3
Onsemi | 0 | 35 | 12 | 0.5 |  |  | DPAK-3 TO-220-3
Onsemi | 0 | 35 | 15 | 0.5 |  |  | DPAK-3 TO-220-3
Onsemi | 0 | 35 | 18 | 0.5 |  |  | DPAK-3 TO-220-3
Onsemi | 0 | -35 | -5.2 | 1 |  |  | TO-220-3
Onsemi | 0 | -35 | -5 | 1 |  |  | D<sup>2</sup>PAK-3 TO-220-3
Onsemi | 0 | -35 | -8 | 1 |  |  | TO-220-3
Onsemi | 0 | 12 | 1.5 1.8 2.5 2.7 2.8 2.9 3 3.1 3.2 3.3 5 | 0.15 |  |  | TSOP-5 / SOT-23-5
Onsemi | 0 | 12 | 1.5 1.8 2.5 2.7 2.8 3 3.3 5 | 0.08 |  |  | SC-82AB-4
Onsemi | 0 | 6 | 1.5 1.8 2.1 2.5 2.7 2.8 3 3.3 3.5 5 | 0.08 |  |  | SC-82AB-4
Onsemi | 0 | 6 | 1.5 1.8 2.5 2.7 2.8 3 3.3 5 | 0.08 |  |  | SC-82AB-4
Onsemi | 0 | 12 | 0.8 0.9 1 1.2 | 0.15 |  |  | DFN-6 TSOP-5 / SOT-23-5
Onsemi | 0 | 6.5 | 1.5 1.8 2.5 2.7 2.8 3 3.1 3.3 | 0.15 |  |  | SC-82AB-4 SOT-563
Onsemi | 0 | 6 | 1.5 1.8 2.5 2.7 2.8 3 3.3 5 | 0.1 |  |  | SC-82AB-4
Onsemi | 0 | 6 | 1.5 1.8 2.5 2.7 2.8 3 3.3 5 | 0.1 |  |  | SC-82AB-4
Onsemi | 0 | 6 | 1.3 1.4 1.5 1.8 2.5 2.8 2.9 3 3.1 3.3 3.4 4.5 5 | 0.15 |  |  | TSOP-5 / SOT-23-5
Onsemi | 0 | 40 | Adjustable | 1.5 |  |  | D<sup>2</sup>PAK-3 TO-220-3
Onsemi | 0 | 20 | 3.3 5 12 Adjustable | 0.8 |  |  | DPAK-3 SOIC-8
Onsemi | 0 | 45 | 3.3 5 | 0.15 |  |  | SOIC-20W SOIC-8
Onsemi | 0 | 45 | 5 | 0.15 |  |  | SOIC-14 SOIC-8 SOIC-8 EP TSSOP-14 EP
Onsemi | 0 | 45 | 5 | 0.15 |  |  | SOIC-14 SOIC-8
Onsemi | 0 | 28 | 5 | 0.1 |  |  | SOIC-20W SOIC-8 SOIC-8 EP
Onsemi | 0 | 40 | 5 | 0.1 |  |  | SOIC-8 SOIC-8 EP
Onsemi | 0 |  |  |  |  |  | SOT-23-3
Onsemi | 0 | 12 | 1.4 1.5 1.8 2.5 2.7 2.8 3 3.1 3.2 3.3 3.6 5 | 0.15 |  |  | TSOP-5 / SOT-23-5
Onsemi | 0 | 45 | 5 Adjustable | 0.15 |  |  | SOIC-16W EP SOIC-8
Onsemi | 0 | 45 | 5 | 0.4 |  |  | SOIC-16W EP
Onsemi | 0 | 45 | 3.3 5 | 0.4 |  |  | D<sup>2</sup>PAK-7
Onsemi | 0 | 50 | 2.5, 5.0 | 0.1 |  |  | SOIC-16W EP
Analog Devices | ADP3367 | 16.5 | 5 | 0.3 |  | #VALUE! | 8 ld SOIC
Analog Devices | ADP667 | 16.5 | 5 | 0.25 |  | #VALUE! | 8 ld PDIP,8 ld SOIC
Monolithic Power | MP20075 | 3.6 | - | 3000 | - | - | MSOP8E
Monolithic Power | MP20073 | 6 | - | 2000 | - | - | MSOP8E
Monolithic Power | MP2007 | 6 | 5.5 | 3000 | - | - | MSOP8E
TI | TPS759 (http://www.ti.com/product/TPS759) | 5.5 | 1.5, 1.8, 2.5, 3.3 | 7.5 | 10 | 35 | 155 mm2: 15.24 x 10.16(DDPAK/TO-263), See datasheet (TO-220)
TI | LM138 (http://www.ti.com/product/LM138) | 40 | 32 | 5 | 10 | 37 | 969 mm2: 24.89 x 38.94(TO-3)
TI | LM338 (http://www.ti.com/product/LM338) | 40 | 32 | 5 | 10 | 37 | See datasheet (TO-220)
TI | TPS74 (http://www.ti.com/product/TPS74) | 7 | 1.5, 1.8, 2.5, 3, 3.3 | 0.2 | 10 | 190 | 29 mm2: 6 x 4.9(SOIC)
TI | LP8340 (http://www.ti.com/product/LP8340) | 10 | 9.3 | 1 | 10 | 250 | See datasheet (WSON)
TI | TPS758 (http://www.ti.com/product/TPS758) | 5.5 | 1.5, 1.8, 2.5, 3.3 | 3 | 12 | 35 | 155 mm2: 15.24 x 10.16(DDPAK/TO-263), See datasheet (TO-220)
TI | TPS756 (http://www.ti.com/product/TPS756) | 5.5 | 1.5, 1.8, 2.5, 3.3 | 5 | 12 | 35 | 155 mm2: 15.24 x 10.16(DDPAK/TO-263), See datasheet (TO-220)
TI | TPS757 (http://www.ti.com/product/TPS757) | 5.5 | 1.5, 1.8, 2.5, 3.3 | 3 | 12 | 35 | 155 mm2: 15.24 x 10.16(DDPAK/TO-263), See datasheet (TO-220)
TI | TPS755 (http://www.ti.com/product/TPS755) | 5.5 | 1.5, 1.8, 2.5, 3.3 | 5 | 12 | 35 | 155 mm2: 15.24 x 10.16(DDPAK/TO-263), See datasheet (TO-220)
TI | TPS783 (http://www.ti.com/product/TPS783) | 5.5 | 1.8, 1.9, 2.6, 3, 4.2 | 0.15 | 13 | 86 | 8 mm2: 2.8 x 2.9(SOT-23-THIN)
TI | TPS780 (http://www.ti.com/product/TPS780) | 5.5 | 1.8, 2, 2.3, 2.5, 2.7, 3, 3.3 | 0.15 | 13 | 86 | 8 mm2: 2.8 x 2.9(SOT-23-THIN), See datasheet (WSON)
TI | TPS782 (http://www.ti.com/product/TPS782) | 5.5 | 1.8, 2.2, 2.3, 2.5, 2.7, 2.8, 3, 3.3, 3.6 | 0.15 | 13 | 86 | 8 mm2: 2.8 x 2.9(SOT-23-THIN), See datasheet (WSON)
TI | TPS781 (http://www.ti.com/product/TPS781) | 5.5 | 2, 2.2, 2.5, 3.3 | 0.15 | 13 | 86 | 8 mm2: 2.8 x 2.9(SOT-23-THIN), See datasheet (WSON)
TI | TPS782-Q1 (http://www.ti.com/product/TPS782-Q1) | 5.5 | 2.5, 2.7, 2.8, 3 | 0.15 | 13 | 86 | See datasheet (WSON)
TI | LP4951C (http://www.ti.com/product/LP4951C) | 30 | 29 | 0.1 | 13 | 100 | 29 mm2: 6 x 4.9(SOIC)
TI | LP2954 (http://www.ti.com/product/LP2954) | 30 | 29 | 0.25 | 14 | 80 | 155 mm2: 15.24 x 10.16(DDPAK/TO-263), 29 mm2: 6 x 4.9(SOIC), See datasheet (TO-220)
TI | LP2954A (http://www.ti.com/product/LP2954A) | 30 | 29 | 0.25 | 14 | 80 | 155 mm2: 15.24 x 10.16(DDPAK/TO-263), 29 mm2: 6 x 4.9(SOIC), See datasheet (TO-220)
TI | LP2957 (http://www.ti.com/product/LP2957) | 30 | 5 | 0.25 | 14 | 320 | 155 mm2: 15.24 x 10.16(DDPAK/TO-263)
TI | LP2957A (http://www.ti.com/product/LP2957A) | 30 | 5 | 0.25 | 14 | 320 | 155 mm2: 15.24 x 10.16(DDPAK/TO-263), See datasheet (TO-220)
TI | TPS73101-EP (http://www.ti.com/product/TPS73101-EP) | 5.5 | 1.2, 5 | 0.15 | 15 | 30 | 8 mm2: 2.8 x 2.9(SOT-23)
TI | TPS731125-EP (http://www.ti.com/product/TPS731125-EP) | 5.5 | 1.25 | 0.15 | 15 | 30 | 8 mm2: 2.8 x 2.9(SOT-23)
TI | TPS73115-EP (http://www.ti.com/product/TPS73115-EP) | 5.5 | 1.5 | 0.15 | 15 | 30 | 8 mm2: 2.8 x 2.9(SOT-23)
TI | TPS73118-EP (http://www.ti.com/product/TPS73118-EP) | 5.5 | 1.8 | 0.15 | 15 | 30 | 8 mm2: 2.8 x 2.9(SOT-23)
TI | TPS73125-EP (http://www.ti.com/product/TPS73125-EP) | 5.5 | 2.5 | 0.15 | 15 | 30 | 8 mm2: 2.8 x 2.9(SOT-23)
TI | TPS73130-EP (http://www.ti.com/product/TPS73130-EP) | 5.5 | 3 | 0.15 | 15 | 30 | 8 mm2: 2.8 x 2.9(SOT-23)
TI | TPS73132-EP (http://www.ti.com/product/TPS73132-EP) | 5.5 | 3.2 | 0.15 | 15 | 30 | 8 mm2: 2.8 x 2.9(SOT-23)
TI | TPS73133-EP (http://www.ti.com/product/TPS73133-EP) | 5.5 | 3.3 | 0.15 | 15 | 30 | 8 mm2: 2.8 x 2.9(SOT-23)
TI | TPS73150-EP (http://www.ti.com/product/TPS73150-EP) | 5.5 | 5 | 0.15 | 15 | 30 | 8 mm2: 2.8 x 2.9(SOT-23)
TI | TPS752-Q1 (http://www.ti.com/product/TPS752-Q1) | 5.5 | 1.5, 1.8, 2.5, 3.3 | 2 | 15 | 60 | 42 mm2: 6.4 x 6.5(HTSSOP)
TI | TPS754 (http://www.ti.com/product/TPS754) | 5.5 | 1.5, 1.8, 2.5, 3.3 | 2 | 15 | 60 | 42 mm2: 6.4 x 6.5(HTSSOP)
TI | TPS752 (http://www.ti.com/product/TPS752) | 5.5 | 1.5, 1.8, 2.5, 3.3 | 2 | 15 | 60 | 42 mm2: 6.4 x 6.5(HTSSOP)
TI | TPS73601-EP (http://www.ti.com/product/TPS73601-EP) | 5.5 | 1.2, 3.3 | 0.4 | 16 | 30 | See datasheet (SON), 46 mm2: 7.06 x 6.5(SOT-223), 8 mm2: 2.8 x 2.9(SOT-23)
TI | TPS73201-EP (http://www.ti.com/product/TPS73201-EP) | 5.5 | 1.2, 5 | 0.25 | 16 | 30 | 8 mm2: 2.8 x 2.9(SOT-23)
TI | TPS73215-EP (http://www.ti.com/product/TPS73215-EP) | 5.5 | 1.5 | 0.25 | 16 | 30 | 8 mm2: 2.8 x 2.9(SOT-23)
TI | TPS73615-EP (http://www.ti.com/product/TPS73615-EP) | 5.5 | 1.5 | 0.4 | 16 | 30 | 8 mm2: 2.8 x 2.9(SOT-23)
TI | TPS73216-EP (http://www.ti.com/product/TPS73216-EP) | 5.5 | 1.6 | 0.25 | 16 | 30 | 8 mm2: 2.8 x 2.9(SOT-23)
TI | TPS736-Q1 (http://www.ti.com/product/TPS736-Q1) | 5.5 | 1.8 | 0.4 | 16 | 30 | 46 mm2: 7.06 x 6.5(SOT-223), 8 mm2: 2.8 x 2.9(SOT-23)
TI | TPS73218-EP (http://www.ti.com/product/TPS73218-EP) | 5.5 | 1.8 | 0.25 | 16 | 30 | 8 mm2: 2.8 x 2.9(SOT-23)
TI | TPS73618-EP (http://www.ti.com/product/TPS73618-EP) | 5.5 | 1.8 | 0.4 | 16 | 30 | 8 mm2: 2.8 x 2.9(SOT-23)
TI | TPS732-Q1 (http://www.ti.com/product/TPS732-Q1) | 5.5 | 1.8, 5 | 0.25 | 16 | 30 | See datasheet (SON), 46 mm2: 7.06 x 6.5(SOT-223), 8 mm2: 2.8 x 2.9(SOT-23)
TI | TPS73225-EP (http://www.ti.com/product/TPS73225-EP) | 5.5 | 2.5 | 0.25 | 16 | 30 | 8 mm2: 2.8 x 2.9(SOT-23)
TI | TPS73625-EP (http://www.ti.com/product/TPS73625-EP) | 5.5 | 2.5 | 0.4 | 16 | 30 | 8 mm2: 2.8 x 2.9(SOT-23)
TI | TPS73230-EP (http://www.ti.com/product/TPS73230-EP) | 5.5 | 3 | 0.25 | 16 | 30 | 8 mm2: 2.8 x 2.9(SOT-23)
TI | TPS73630-EP (http://www.ti.com/product/TPS73630-EP) | 5.5 | 3 | 0.4 | 16 | 30 | 8 mm2: 2.8 x 2.9(SOT-23)
TI | TPS73632-EP (http://www.ti.com/product/TPS73632-EP) | 5.5 | 3.2 | 0.4 | 16 | 30 | 8 mm2: 2.8 x 2.9(SOT-23)
TI | TPS73233-EP (http://www.ti.com/product/TPS73233-EP) | 5.5 | 3.3 | 0.25 | 16 | 30 | 8 mm2: 2.8 x 2.9(SOT-23)
TI | TPS73633-EP (http://www.ti.com/product/TPS73633-EP) | 5.5 | 3.3 | 0.4 | 16 | 30 | 8 mm2: 2.8 x 2.9(SOT-23)
TI | TPS73250-EP (http://www.ti.com/product/TPS73250-EP) | 5.5 | 5 | 0.25 | 16 | 30 | 8 mm2: 2.8 x 2.9(SOT-23)
TI | TPS75215-EP (http://www.ti.com/product/TPS75215-EP) | 5.5 | 1.5 | 2 | 16 | 60 | 42 mm2: 6.4 x 6.5(HTSSOP)
TI | TPS75201-EP (http://www.ti.com/product/TPS75201-EP) | 5.5 | 1.5, 1.8, 2.5, 3.3 | 2 | 16 | 60 | 42 mm2: 6.4 x 6.5(HTSSOP)
TI | TPS75218-EP (http://www.ti.com/product/TPS75218-EP) | 5.5 | 1.8 | 2 | 16 | 60 | 42 mm2: 6.4 x 6.5(HTSSOP)
TI | TPS75225-EP (http://www.ti.com/product/TPS75225-EP) | 5.5 | 2.5 | 2 | 16 | 60 | 42 mm2: 6.4 x 6.5(HTSSOP)
TI | TPS75233-EP (http://www.ti.com/product/TPS75233-EP) | 5.5 | 3.3 | 2 | 16 | 60 | 42 mm2: 6.4 x 6.5(HTSSOP)
TI | TPS75201M-EP (http://www.ti.com/product/TPS75201M-EP) | 5.5 | 5.5 | 2 | 16 | 60 | 42 mm2: 6.4 x 6.5(HTSSOP)
TI | LP2960 (http://www.ti.com/product/LP2960) | 30 | 3.3, 5 | 0.5 | 16 | 130 | 59 mm2: 6 x 9.9(SOIC)
TI | TLV713P-Q1 (http://www.ti.com/product/TLV713P-Q1) | 5.5 | 1, 1.2, 1.8, 2.5, 3.3 | 0.15 | 17 | 55 | 8 mm2: 2.8 x 2.9(SOT-23)
TI | TPS75301-EP (http://www.ti.com/product/TPS75301-EP) | 5.5 | 1.5, 1.8, 2.5, 3.3 | 1.5 | 17 | 60 | 42 mm2: 6.4 x 6.5(HTSSOP)
TI | TPS751 (http://www.ti.com/product/TPS751) | 5.5 | 1.5, 1.8, 2.5, 3.3 | 1.5 | 17 | 60 | 42 mm2: 6.4 x 6.5(HTSSOP)
TI | TPS75318-EP (http://www.ti.com/product/TPS75318-EP) | 5.5 | 1.8 | 1.5 | 17 | 60 | 42 mm2: 6.4 x 6.5(HTSSOP)
TI | TPS753 (http://www.ti.com/product/TPS753) | 5.5 | 1.8, 2.5, 3.3 | 1.5 | 17 | 60 | 42 mm2: 6.4 x 6.5(HTSSOP)
TI | TPS75125-EP (http://www.ti.com/product/TPS75125-EP) | 5.5 | 2.5 | 1.5 | 17 | 60 | 42 mm2: 6.4 x 6.5(HTSSOP)
TI | TPS75325-EP (http://www.ti.com/product/TPS75325-EP) | 5.5 | 2.5 | 1.5 | 17 | 60 | 42 mm2: 6.4 x 6.5(HTSSOP)
TI | TPS75333-EP (http://www.ti.com/product/TPS75333-EP) | 5.5 | 3.3 | 1.5 | 17 | 60 | 42 mm2: 6.4 x 6.5(HTSSOP)
TI | TLV713P (http://www.ti.com/product/TLV713P) | 5.5 | 1, 1.1, 1.2, 1.5, 1.8, 1.85, 2.5, 2.8, 2.85, 3, 3.3 | 0.15 | 17 | 73 | 8 mm2: 2.8 x 2.9(SOT-23), 1 mm2: 1 x 1(X2SON)
TI | TLV741P (http://www.ti.com/product/TLV741P) | 5.5 | 1, 1.1, 1.2, 1.5, 1.8, 2.5, 2.8, 2.85, 3, 3.3 | 0.15 | 17 | 73 | 8 mm2: 2.8 x 2.9(SOT-23)
TI | TLV713 (http://www.ti.com/product/TLV713) | 5.5 | 2 | 0.15 | 17 | 73 | 1 mm2: 1 x 1(X2SON)
TI | UCC383 (http://www.ti.com/product/UCC383) | 9 | 3.3, 5 | 3 | 18 |  | 155 mm2: 15.24 x 10.16(DDPAK/TO-263), 155 mm2: 15.24 x 10.16(DDPAK/TO-263), See datasheet (TO-220)
TI | UCC283 (http://www.ti.com/product/UCC283) | 9 | 3.3, 5 | 3 | 18 |  | 155 mm2: 15.24 x 10.16(DDPAK/TO-263), 155 mm2: 15.24 x 10.16(DDPAK/TO-263), See datasheet (TO-220)
TI | LP3988 (http://www.ti.com/product/LP3988) | 6 | 1.85, 2.5, 2.6, 2.85, 3, 3.3 | 0.15 | 19 | 220 | See datasheet (DSBGA), 8 mm2: 2.8 x 2.9(SOT-23)
TI | LP3988-Q1 (http://www.ti.com/product/LP3988-Q1) | 6 | 2.85 | 0.15 | 19 | 220 | 8 mm2: 2.8 x 2.9(SOT-23)
TI | LM337 (http://www.ti.com/product/LM337) | -3 | -1.2 | 1.5 | 19 | 1110 | 155 mm2: 15.24 x 10.16(DDPAK/TO-263), See datasheet (TO-220), 40 mm2: 6.6 x 6.1(TO-252)
TI | LM237 (http://www.ti.com/product/LM237) | -3 | -1.2 | 1.5 | 19 | 1110 | See datasheet (TO-220)
TI | REG103 (http://www.ti.com/product/REG103) | 15 | 2.5, 3, 3.3, 5 | 0.5 | 20 | 33 | 155 mm2: 15.24 x 10.16(DDPAK/TO-263), 29 mm2: 6 x 4.9(SOIC), 46 mm2: 7.06 x 6.5(SOT-223)
TI | LP3982 (http://www.ti.com/product/LP3982) | 6 | 1.8, 2.5, 2.82, 3, 3.3 | 0.3 | 20 | 37 | 15 mm2: 4.9 x 3(VSSOP), See datasheet (WSON)
TI | TPS726 (http://www.ti.com/product/TPS726) | 6 | 1.26, 1.5, 1.6, 1.8, 2.5 | 1 | 20 | 150 | 155 mm2: 15.24 x 10.16(DDPAK/TO-263), 46 mm2: 7.06 x 6.5(SOT-223)
TI | TPS725 (http://www.ti.com/product/TPS725) | 6 | 1.5, 1.6, 1.8, 2.5 | 1 | 20 | 150 | 155 mm2: 15.24 x 10.16(DDPAK/TO-263), 46 mm2: 7.06 x 6.5(SOT-223)
TI | TL720M05-Q1 (http://www.ti.com/product/TL720M05-Q1) | 42 | 5 | 0.7 | 20 |  | 155 mm2: 15.24 x 10.16(DDPAK/TO-263), 42 mm2: 6.4 x 6.5(HTSSOP), 40 mm2: 6.6 x 6.1(TO-252)
TI | LM317MQ (http://www.ti.com/product/LM317MQ) | 40 | 37 | 0.5 | 22 | 38 | 46 mm2: 7 x 6.5(SOT-223)
TI | LM317M (http://www.ti.com/product/LM317M) | 40 | 37 | 0.5 | 22 | 38 | 46 mm2: 7 x 6.5(SOT-223), 40 mm2: 6.6 x 6.1(TO-252)
TI | LM2991 (http://www.ti.com/product/LM2991) | 0.3 | -3 | 1 | 22 | 200 | 155 mm2: 15.24 x 10.16(DDPAK/TO-263), See datasheet (TO-220)
TI | UCC381 (http://www.ti.com/product/UCC381) | 9 | 3.3, 5 | 1 | 22 |  | 29 mm2: 6 x 4.9(SOIC)
TI | UCC281 (http://www.ti.com/product/UCC281) | 9 | 5 | 1 | 22 |  | 29 mm2: 6 x 4.9(SOIC)
TI | LM120 (http://www.ti.com/product/LM120) | -7 | -5, -12, -15 | 1.5 | 23 | 150 | 92 mm2: 9.14 x 10.03(TO)
TI | LM2990 (http://www.ti.com/product/LM2990) | -6 | -5, -5.2, -12, -15 | 1 | 23 | 250 | 155 mm2: 15.24 x 10.16(DDPAK/TO-263), See datasheet (TO-220)
TI | LP3992 (http://www.ti.com/product/LP3992) | 5.2 | 1.5 | 0.03 | 23 | 300 | 8 mm2: 2.8 x 2.9(SOT-23)
TI | TPS73433-Q1 (http://www.ti.com/product/TPS73433-Q1) | 6.5 | 3.3 | 0.25 | 24 | 28 | 8 mm2: 2.8 x 2.9(SOT-23-THIN)
TI | TPS779 (http://www.ti.com/product/TPS779) | 10 | 1.8, 2.5 | 0.25 | 24 | 55 | 15 mm2: 4.9 x 3(VSSOP)
TI | TPS7A85A (http://www.ti.com/product/TPS7A85A) | 6.5 | 5.1 | 4 | 25 | 4.4 | 12 mm2: 3.5 x 3.5(VQFN)
TI | TPS7A84A (http://www.ti.com/product/TPS7A84A) | 6.5 | 5.15 | 3 | 25 | 4.4 | 12 mm2: 3.5 x 3.5(VQFN)
TI | TPS7A85 (http://www.ti.com/product/TPS7A85) | 6.5 | 5 | 4 | 25 | 4.4 | 12 mm2: 3.5 x 3.5(VQFN)
TI | TPS7A84 (http://www.ti.com/product/TPS7A84) | 6.5 | 5 | 3 | 25 | 4.4 | 12 mm2: 3.5 x 3.5(VQFN)
TI | LP3999 (http://www.ti.com/product/LP3999) | 6 | 1.5, 1.8, 2.4, 2.5, 2.8, 3.3 | 0.15 | 25 | 10 | See datasheet (DSBGA)
TI | TPS7H1101A-SP (http://www.ti.com/product/TPS7H1101A-SP) | 7 | 6.65 | 3 | 25 | 20 | See datasheet (CFP)
TI | TPS7H1101-SP (http://www.ti.com/product/TPS7H1101-SP) | 7 | 6.8 | 3 | 25 | 20.33 | See datasheet (CFP)
TI | LP3981 (http://www.ti.com/product/LP3981) | 6 | 2.5, 2.7, 2.8, 3, 3.3 | 0.3 | 25 | 35 | 15 mm2: 4.9 x 3(VSSOP), See datasheet (WSON)
TI | TPS7A7200-EP (http://www.ti.com/product/TPS7A7200-EP) | 6.5 | 0.05, 0.1, 0.2, 0.4, 0.8, 1.6 | 2 | 25 | 40 | 25 mm2: 5 x 5(VQFN)
TI | TPS7A7100 (http://www.ti.com/product/TPS7A7100) | 6.5 | 5 | 1 | 25 | 40 | 9 mm2: 3 x 3(VQFN), 25 mm2: 5 x 5(VQFN)
TI | TPS7A7200 (http://www.ti.com/product/TPS7A7200) | 6.5 | 5 | 2 | 25 | 40 | 9 mm2: 3 x 3(VQFN), 25 mm2: 5 x 5(VQFN)
TI | TPS7A7300 (http://www.ti.com/product/TPS7A7300) | 6.5 | 5 | 3 | 25 | 40 | 25 mm2: 5 x 5(VQFN)
TI | TPS773 (http://www.ti.com/product/TPS773) | 10 | 1.5, 1.6, 1.8, 2.8, 3.3, 5 | 0.25 | 25 | 55 | 15 mm2: 4.9 x 3(VSSOP)
TI | TPS77401-EP (http://www.ti.com/product/TPS77401-EP) | 10 | 1.5, 1.8, 2.7, 2.8, 3.3, 5 | 0.25 | 25 | 55 | 15 mm2: 4.9 x 3(VSSOP)
TI | TPS774 (http://www.ti.com/product/TPS774) | 10 | 1.5, 1.8, 2.8, 3.3, 5 | 0.25 | 25 | 55 | 15 mm2: 4.9 x 3(VSSOP)
TI | TPS788 (http://www.ti.com/product/TPS788) | 10 | 2.5, 3.3 | 0.15 | 25 | 56 | 8 mm2: 2.8 x 2.9(SOT-23)
Onsemi | 0 | 6 | 1.5 2.5 2.8 2.9 3.3 3.5 | 0.15 | 25 | 100 | SC-88A XDFN-4
TI | LP38502-ADJ (http://www.ti.com/product/LP38502-ADJ) | 5.5 | 5 | 1.5 | 25 | 100 | 155 mm2: 15.24 x 10.16(DDPAK/TO-263), 142 mm2: 14.01 x 10.16(TO-263), See datasheet (WSON)
TI | LP38500-ADJ (http://www.ti.com/product/LP38500-ADJ) | 5.5 | 5.1 | 1.5 | 25 | 100 | 155 mm2: 15.24 x 10.16(DDPAK/TO-263), 142 mm2: 14.01 x 10.16(TO-263), See datasheet (WSON)
TI | LP38501-ADJ (http://www.ti.com/product/LP38501-ADJ) | 5.5 | 5 | 3 | 25 | 100 | 155 mm2: 15.24 x 10.16(DDPAK/TO-263), 142 mm2: 14.01 x 10.16(TO-263)
TI | LP38503-ADJ (http://www.ti.com/product/LP38503-ADJ) | 5.5 | 5 | 3 | 25 | 100 | 155 mm2: 15.24 x 10.16(DDPAK/TO-263), 142 mm2: 14.01 x 10.16(TO-263)
TI | LM320-N (http://www.ti.com/product/LM320-N) | -18 | -5, -12, -15 | 1.5 | 25 | 150 | See datasheet (TO-220)
TI | LP3991 (http://www.ti.com/product/LP3991) | 3.6 | 1.2, 1.3, 1.5, 2.8, 3 | 0.3 | 25 | 280 | See datasheet (DSBGA)
TI | TPS735-Q1 (http://www.ti.com/product/TPS735-Q1) | 6.5 | 1.2, 1.5, 1.8, 2.5, 2.7, 3, 3.3 | 0.5 | 26 | 13 | See datasheet (SON)
TI | TPS771 (http://www.ti.com/product/TPS771) | 10 | 1.5, 1.8, 2.7, 2.8, 3.3, 5 | 0.15 | 26 | 55 | 15 mm2: 4.9 x 3(VSSOP)
TI | TPS772 (http://www.ti.com/product/TPS772) | 10 | 1.5, 1.8, 2.7, 3.3, 5 | 0.15 | 26 | 55 | 15 mm2: 4.9 x 3(VSSOP)
TI | TPS77101-Q1 (http://www.ti.com/product/TPS77101-Q1) | 10 | 5.5 | 0.15 | 26 | 55 | 15 mm2: 4.9 x 3(VSSOP)
TI | TPS709 (http://www.ti.com/product/TPS709) | 30 | 1.2, 1.35, 1.5, 1.6, 1.8, 1.9, 2.5, 2.7, 2.8, 3, 3.3, 3.6, 3.8, 3.9, 5, 6 | 0.15 | 26 | 190 | 8 mm2: 2.8 x 2.9(SOT-23), See datasheet (WSON)
TI | TPS7A16-Q1 (http://www.ti.com/product/TPS7A16-Q1) | 60 | 3.3, 5 | 0.1 | 26 | 215 | 15 mm2: 4.9 x 3(MSOP-PowerPAD)
TI | TPS7A16 (http://www.ti.com/product/TPS7A16) | 60 | 3.3, 5 | 0.1 | 26 | 215 | 15 mm2: 4.9 x 3(MSOP-PowerPAD), See datasheet (SON)
TI | TPS74701-Q1 (http://www.ti.com/product/TPS74701-Q1) | 5.5 | 3.6 | 0.5 | 27 | 20 | 9 mm2: 3 x 3(VSON)
TI | TPS74701 (http://www.ti.com/product/TPS74701) | 5.5 | 3.6 | 0.5 | 27 | 20 | 9 mm2: 3 x 3(VSON)
Onsemi | 0 | 35 | 3 3.3 5 8 | 0.15 | 27 | 112 | SOT-89-5
Onsemi | 0 | 12 | 3 3.3 5 | 0.15 | 27 | 150 | SC-88A SOT-23-5 UDFN-4
TI | TPS770 (http://www.ti.com/product/TPS770) | 10 | 1.2, 1.5, 1.8, 2.5, 2.7, 2.8, 3, 3.3, 5 | 0.05 | 27 | 190 | 8 mm2: 2.8 x 2.9(SOT-23)
TI | TPS769 (http://www.ti.com/product/TPS769) | 10 | 1.2, 1.5, 1.8, 2.5, 2.7, 2.8, 3, 3.3, 5 | 0.1 | 27 | 190 | 8 mm2: 2.8 x 2.9(SOT-23)
TI | TPS76901-EP (http://www.ti.com/product/TPS76901-EP) | 10 | 5.5 | 0.1 | 27 | 190 | 8 mm2: 2.8 x 2.9(SOT-23)
TI | TLE4275-Q1 (http://www.ti.com/product/TLE4275-Q1) | 42 | 5 | 0.7 | 27 |  | 155 mm2: 15.24 x 10.16(DDPAK/TO-263), 42 mm2: 6.4 x 6.5(HTSSOP), 67 mm2: 10.11 x 6.6(TO-252)
TI | TPS76901-HT (http://www.ti.com/product/TPS76901-HT) | 10 | 4.5 | 0.1 | 27 |  | See datasheet (CFP), 8 mm2: 2.8 x 2.9(SOT-23)
TI | TPS735 (http://www.ti.com/product/TPS735) | 6.5 | 1.2, 1.5, 2.5, 2.7, 2.85, 3.3, 3.4 | 0.5 | 28 | 16.5 | See datasheet (SON), See datasheet (WSON)
TI | LP2988 (http://www.ti.com/product/LP2988) | 16 | 2.7, 2.8, 3, 3.3, 3.8, 5 | 0.2 | 28 | 20 | 29 mm2: 6 x 4.9(SOIC), 15 mm2: 4.9 x 3(VSSOP), See datasheet (WSON)
TI | TPS74801-Q1 (http://www.ti.com/product/TPS74801-Q1) | 5.5 | 3.6 | 1.5 | 28 | 20 | 25 mm2: 5 x 5(VQFN), 9 mm2: 3 x 3(VSON)
TI | TPS74901 (http://www.ti.com/product/TPS74901) | 5.5 | 3.6 | 3 | 28 | 20 | 154 mm2: 15.24 x 10.1(DDPAK/TO-263), 25 mm2: 5 x 5(VQFN), 9 mm2: 3 x 3(VSON)
TI | TPS74801 (http://www.ti.com/product/TPS74801) | 5.5 | 3.6 | 1.5 | 28 | 20 | 25 mm2: 5 x 5(VQFN), 9 mm2: 3 x 3(VSON)
TI | LP38512-ADJ (http://www.ti.com/product/LP38512-ADJ) | 5.5 | 5 | 1.5 | 28 | 25 | 29 mm2: 6 x 4.9(SO PowerPAD), 142 mm2: 14.01 x 10.16(TO-263)
TI | LP38513-ADJ (http://www.ti.com/product/LP38513-ADJ) | 5.5 | 5 | 3 | 28 | 25 | 142 mm2: 14.01 x 10.16(TO-263)
TI | TPS734 (http://www.ti.com/product/TPS734) | 6.5 | 1.8, 3, 3.3 | 0.25 | 28 | 28 | 8 mm2: 2.8 x 2.9(SOT-23-THIN), See datasheet (WSON)
TI | REG113 (http://www.ti.com/product/REG113) | 10 | 2.5, 2.85, 3, 3.3, 5 | 0.4 | 28 | 28 | 8 mm2: 2.8 x 2.9(SOT-23), 15 mm2: 4.9 x 3(VSSOP)
TI | LP3987 (http://www.ti.com/product/LP3987) | 6 | 2.6, 2.8, 2.85 | 0.15 | 28 | 70 | See datasheet (DSBGA)
TI | LP38841 (http://www.ti.com/product/LP38841) | 5.5 | 0.8, 1.2, 1.5 | 0.8 | 28 | 90 | 155 mm2: 15.24 x 10.16(DDPAK/TO-263), See datasheet (TO-220)
TI | TLV1117-33 (http://www.ti.com/product/TLV1117-33) | 15 | 3.3 | 0.8 | 28 | 102 | 46 mm2: 7 x 6.5(SOT-223)
TI | TLV743P (http://www.ti.com/product/TLV743P) | 5.5 | 1, 1.1, 1.2, 1.5, 1.8, 2.5, 2.8, 2.85, 3, 3.3 | 0.3 | 28 | 120 | 8 mm2: 2.8 x 2.9(SOT-23)
TI | TLV733P (http://www.ti.com/product/TLV733P) | 5.5 | 1, 1.1, 1.2, 1.5, 1.8, 2.5, 2.8, 2.85, 3, 3.3 | 0.3 | 28 | 120 | 8 mm2: 2.8 x 2.9(SOT-23), 1 mm2: 1 x 1(X2SON)
TI | TLV733P-Q1 (http://www.ti.com/product/TLV733P-Q1) | 5.5 | 1, 1.1, 1.2, 1.5, 1.8, 2.5, 2.8, 3.3 | 0.3 | 28 | 120 | See datasheet (WSON)
TI | TPS769-Q1 (http://www.ti.com/product/TPS769-Q1) | 10 | 1.2, 1.5, 1.8, 2.5, 2.7, 3, 3.3, 5 | 0.1 | 28 | 190 | 8 mm2: 2.8 x 2.9(SOT-23)
TI | TLV1117 (http://www.ti.com/product/TLV1117) | 15 | 1.5, 1.8, 2.5, 3.3, 5 | 0.8 | 28 | 411 | 155 mm2: 15.24 x 10.16(DDPAK/TO-263), See datasheet (SON), 46 mm2: 7 x 6.5(SOT-223), See datasheet (TO-220), 40 mm2: 6.6 x 6.1(TO-252)
TI | TPS7A7002 (http://www.ti.com/product/TPS7A7002) | 6.5 | 5 | 3 | 28 |  | 29 mm2: 6 x 4.9(SO PowerPAD)
TI | TPS7A7001 (http://www.ti.com/product/TPS7A7001) | 6.5 | 5 | 2 | 28 |  | 29 mm2: 6 x 4.9(SO PowerPAD)
TI | REG1117A (http://www.ti.com/product/REG1117A) | 15 | 1.8, 2.5, 5 | 1 | 29 | 38 | 155 mm2: 15.24 x 10.16(DDPAK/TO-263), 46 mm2: 7 x 6.5(SOT-223)
TI | REG1117 (http://www.ti.com/product/REG1117) | 15 | 2.5, 2.8, 2.85, 3, 3.3, 5 | 0.8 | 29 | 38 | 155 mm2: 15.24 x 10.16(DDPAK/TO-263), 46 mm2: 7 x 6.5(SOT-223)
TI | LP38513 (http://www.ti.com/product/LP38513) | 5.5 | 1.8 | 3 | 29 | 45 | 155 mm2: 15.24 x 10.16(DDPAK/TO-263), See datasheet (TO-220)
TI | TPS77615-EP (http://www.ti.com/product/TPS77615-EP) | 10 | 1.5 | 0.5 | 29 | 53 | 42 mm2: 6.4 x 6.5(HTSSOP)
TI | TPS77515-EP (http://www.ti.com/product/TPS77515-EP) | 10 | 1.5 | 0.5 | 29 | 53 | 42 mm2: 6.4 x 6.5(HTSSOP)
TI | TPS77601-EP (http://www.ti.com/product/TPS77601-EP) | 10 | 1.5, 1.6, 1.8, 2.5, 3.3 | 0.5 | 29 | 53 | 42 mm2: 6.4 x 6.5(HTSSOP)
TI | TPS77501-EP (http://www.ti.com/product/TPS77501-EP) | 10 | 1.5, 1.6, 1.8, 2.5, 3.3 | 0.5 | 29 | 53 | 42 mm2: 6.4 x 6.5(HTSSOP)
TI | TPS775 (http://www.ti.com/product/TPS775) | 10 | 1.5, 1.6, 1.8, 2.5, 3.3 | 0.5 | 29 | 53 | 42 mm2: 6.4 x 6.5(HTSSOP), 29 mm2: 6 x 4.9(SOIC)
TI | TPS776 (http://www.ti.com/product/TPS776) | 10 | 1.5, 1.8, 2.5, 2.8, 3.3 | 0.5 | 29 | 53 | 42 mm2: 6.4 x 6.5(HTSSOP), 29 mm2: 6 x 4.9(SOIC)
TI | TPS776-Q1 (http://www.ti.com/product/TPS776-Q1) | 10 | 1.5, 1.8, 2.5, 3.3 | 0.5 | 29 | 53 | 42 mm2: 6.4 x 6.5(HTSSOP)
TI | TPS775-Q1 (http://www.ti.com/product/TPS775-Q1) | 10 | 1.5, 1.8, 2.5, 3.3 | 0.5 | 29 | 53 | 42 mm2: 6.4 x 6.5(HTSSOP)
TI | TPS77618-EP (http://www.ti.com/product/TPS77618-EP) | 10 | 1.8 | 0.5 | 29 | 53 | 42 mm2: 6.4 x 6.5(HTSSOP)
TI | TPS77518-EP (http://www.ti.com/product/TPS77518-EP) | 10 | 1.8 | 0.5 | 29 | 53 | 42 mm2: 6.4 x 6.5(HTSSOP)
TI | TPS77625-EP (http://www.ti.com/product/TPS77625-EP) | 10 | 2.5 | 0.5 | 29 | 53 | 42 mm2: 6.4 x 6.5(HTSSOP)
TI | TPS77525-EP (http://www.ti.com/product/TPS77525-EP) | 10 | 2.5 | 0.5 | 29 | 53 | 42 mm2: 6.4 x 6.5(HTSSOP)
TI | TPS77633-EP (http://www.ti.com/product/TPS77633-EP) | 10 | 3.3 | 0.5 | 29 | 53 | 42 mm2: 6.4 x 6.5(HTSSOP)
TI | TPS77533-EP (http://www.ti.com/product/TPS77533-EP) | 10 | 3.3 | 0.5 | 29 | 53 | 42 mm2: 6.4 x 6.5(HTSSOP)
TI | TPS778 (http://www.ti.com/product/TPS778) | 10 | 1.5, 1.8, 2.5, 3.3 | 0.75 | 29 | 54 | 42 mm2: 6.4 x 6.5(HTSSOP), 29 mm2: 6 x 4.9(SOIC)
TI | TPS777 (http://www.ti.com/product/TPS777) | 10 | 1.5, 1.8, 2.5, 3.3 | 0.75 | 29 | 54 | 42 mm2: 6.4 x 6.5(HTSSOP), 29 mm2: 6 x 4.9(SOIC)
TI | TPS76715-EP (http://www.ti.com/product/TPS76715-EP) | 10 | 1.5 | 1 | 29 | 55 | 42 mm2: 6.4 x 6.5(HTSSOP)
TI | TPS76815-EP (http://www.ti.com/product/TPS76815-EP) | 10 | 1.5 | 1 | 29 | 55 | 42 mm2: 6.4 x 6.5(HTSSOP)
TI | TPS767 (http://www.ti.com/product/TPS767) | 10 | 1.5, 1.8, 2.5, 2.7, 2.8, 3, 3.3, 5 | 1 | 29 | 55 | 42 mm2: 6.4 x 6.5(HTSSOP), 29 mm2: 6 x 4.9(SOIC)
TI | TPS768 (http://www.ti.com/product/TPS768) | 10 | 1.5, 1.8, 2.5, 2.7, 2.8, 3, 3.3, 5 | 1 | 29 | 55 | 42 mm2: 6.4 x 6.5(HTSSOP), 29 mm2: 6 x 4.9(SOIC)
TI | TPS76701-EP (http://www.ti.com/product/TPS76701-EP) | 10 | 1.5, 1.8, 2.5, 2.7, 2.8, 3.0, 3.3, 5.0 | 1 | 29 | 55 | 42 mm2: 6.4 x 6.5(HTSSOP)
TI | TPS76801-EP (http://www.ti.com/product/TPS76801-EP) | 10 | 1.5, 1.8, 2.5, 2.7, 2.8, 3.0, 3.3, 5.0 | 1 | 29 | 55 | 42 mm2: 6.4 x 6.5(HTSSOP)
TI | TPS76818-EP (http://www.ti.com/product/TPS76818-EP) | 10 | 1.8 | 1 | 29 | 55 | 42 mm2: 6.4 x 6.5(HTSSOP)
TI | TPS76718-EP (http://www.ti.com/product/TPS76718-EP) | 10 | 1.8 | 1 | 29 | 55 | 42 mm2: 6.4 x 6.5(HTSSOP)
TI | TPS76825-EP (http://www.ti.com/product/TPS76825-EP) | 10 | 2.5 | 1 | 29 | 55 | 42 mm2: 6.4 x 6.5(HTSSOP)
TI | TPS76725-EP (http://www.ti.com/product/TPS76725-EP) | 10 | 2.5 | 1 | 29 | 55 | 42 mm2: 6.4 x 6.5(HTSSOP)
TI | TPS76833-EP (http://www.ti.com/product/TPS76833-EP) | 10 | 3.3 | 1 | 29 | 55 | 42 mm2: 6.4 x 6.5(HTSSOP)
TI | TPS76733-EP (http://www.ti.com/product/TPS76733-EP) | 10 | 3.3 | 1 | 29 | 55 | 42 mm2: 6.4 x 6.5(HTSSOP)
TI | TPS767-Q1 (http://www.ti.com/product/TPS767-Q1) | 10 | 3.3, 5 | 1 | 29 | 55 | 42 mm2: 6.4 x 6.5(HTSSOP)
TI | TPS76850-EP (http://www.ti.com/product/TPS76850-EP) | 10 | 5 | 1 | 29 | 55 | 42 mm2: 6.4 x 6.5(HTSSOP)
TI | LP38842 (http://www.ti.com/product/LP38842) | 5.5 | 0.8, 1.2, 1.5 | 1.5 | 29 | 90 | 155 mm2: 15.24 x 10.16(DDPAK/TO-263), See datasheet (TO-220)
TI | LP38843 (http://www.ti.com/product/LP38843) | 5.5 | 0.8, 1.2, 1.5 | 3 | 29 | 90 | 155 mm2: 15.24 x 10.16(DDPAK/TO-263), See datasheet (TO-220)
TI | LP38841-ADJ (http://www.ti.com/product/LP38841-ADJ) | 5.5 | 1.5 | 0.8 | 29 | 90 | 29 mm2: 6 x 4.9(SO PowerPAD)
TI | LP38842-ADJ (http://www.ti.com/product/LP38842-ADJ) | 5.5 | 1.5 | 1.5 | 29 | 90 | 29 mm2: 6 x 4.9(SO PowerPAD)
TI | TPS71 (http://www.ti.com/product/TPS71) | 10 | 3.3, 4.8, 5 | 0.5 | 3 | 89 | See datasheet (PDIP), 29 mm2: 6 x 4.9(SOIC), 42 mm2: 6.4 x 6.5(TSSOP)
TI | LP38511-ADJ (http://www.ti.com/product/LP38511-ADJ) | 5.5 | 5 | 0.8 | 30 | 25 | 29 mm2: 6 x 4.9(SO PowerPAD), 142 mm2: 14.01 x 10.16(TO-263)
TI | LP2985LV-N (http://www.ti.com/product/LP2985LV-N) | 16 | 1.5, 1.8, 2 | 0.15 | 30 | 30 | 8 mm2: 2.8 x 2.9(SOT-23)
TI | LP2985-N (http://www.ti.com/product/LP2985-N) | 16 | 1.8, 2.5, 2.6, 2.7, 2.8, 2.9, 3, 3.1, 3.2, 3.3, 3.5, 3.6, 3.8, 4, 4.5, 5, 6.1 | 0.15 | 30 | 30 | 8 mm2: 2.8 x 2.9(SOT-23)
TI | LM1086 (http://www.ti.com/product/LM1086) | 29 | 1.8, 2.5, 3.3, 5 | 1.5 | 30 | 38 | 155 mm2: 15.24 x 10.16(DDPAK/TO-263), See datasheet (TO-220), See datasheet (WSON)
TI | LM1084 (http://www.ti.com/product/LM1084) | 29 | 3.3, 5 | 5.5 | 30 | 38 | 155 mm2: 15.24 x 10.16(DDPAK/TO-263), See datasheet (TO-220)
TI | LM1085 (http://www.ti.com/product/LM1085) | 29 | 3.3, 5, 12 | 3 | 30 | 38 | 155 mm2: 15.24 x 10.16(DDPAK/TO-263), See datasheet (TO-220)
TI | TPS768-Q1 (http://www.ti.com/product/TPS768-Q1) | 10 | 1.8, 2.5, 3.3, 5 | 1 | 30 | 55 | 42 mm2: 6.4 x 6.5(HTSSOP)
Onsemi | 0 | 6 | 1.2 1.5 1.8 2.5 2.8 3 3.3 | 0.15 | 30 | 70 | SOT-23-5 UDFN-4
Onsemi | 0 | 50 | 2 3 3.3 8 12 | 0.05 | 30 | 80 | SOT-89-5
TI | LP3883 (http://www.ti.com/product/LP3883) | 5.5 | 1.2, 1.5 | 3 | 30 | 90 | 155 mm2: 15.24 x 10.16(DDPAK/TO-263)
TI | LP3891 (http://www.ti.com/product/LP3891) | 5.5 | 1.2, 1.5, 1.8 | 0.8 | 30 | 150 | 155 mm2: 15.24 x 10.16(DDPAK/TO-263), 29 mm2: 6 x 4.9(SO PowerPAD)
TI | LP3892 (http://www.ti.com/product/LP3892) | 5.5 | 1.2, 1.5, 1.8 | 1.5 | 30 | 150 | 155 mm2: 15.24 x 10.16(DDPAK/TO-263), 29 mm2: 6 x 4.9(SO PowerPAD)
TI | TPS706 (http://www.ti.com/product/TPS706) | 6.5 | 1.2, 1.5, 1.8, 2.5, 2.8, 3, 3.3 | 0.15 | 30 | 190 | 8 mm2: 2.8 x 2.9(SOT-23), See datasheet (WSON)
TI | TL5209 (http://www.ti.com/product/TL5209) | 16 | 6.5 | 0.5 | 30 | 300 | 29 mm2: 6 x 4.9(SOIC)
TI | LM137 (http://www.ti.com/product/LM137) | -4.2 | -1.2 | 1.5 | 30 | 1110 | 92 mm2: 9.14 x 10.03(TO)
Onsemi | 0 | 5.5 | 1.2 1.5 1.8 2.5 2.8 3 3.1 3.3 3.6 | 0.15 | 30 40 41 47 57 | 85 90 95 120 125 130 | SOT563-6 XDFN-4
TI | TPS789 (http://www.ti.com/product/TPS789) | 10 | 1.5, 1.8, 2.5, 2.8, 3 | 0.1 | 31 | 56 | 8 mm2: 2.8 x 2.9(SOT-23)
TI | LP38512 (http://www.ti.com/product/LP38512) | 5.5 | 1.8 | 1.5 | 31 | 75 | 155 mm2: 15.24 x 10.16(DDPAK/TO-263), 142 mm2: 14.01 x 10.16(TO-263)
TI | TPS7A3401 (http://www.ti.com/product/TPS7A3401) | -3 | -1.2 | 0.2 | 31 | 80 | 15 mm2: 4.9 x 3(MSOP-PowerPAD)
TI | TPS709-Q1 (http://www.ti.com/product/TPS709-Q1) | 30 | 1.2, 1.5, 1.8, 2.5, 2.8, 3, 3.3, 3.6, 5 | 0.15 | 31 | 190 | 8 mm2: 2.8 x 2.9(SOT-23), See datasheet (WSON)
TI | LP2989 (http://www.ti.com/product/LP2989) | 16 | 2.5, 2.8, 3, 3.3, 3.8, 5 | 0.5 | 32 | 18 | 29 mm2: 6 x 4.9(SOIC), 15 mm2: 4.9 x 3(VSSOP), See datasheet (WSON)
TI | LP3995 (http://www.ti.com/product/LP3995) | 6 | 1.9, 2.8, 3 | 0.15 | 32 | 25 | See datasheet (DSBGA), See datasheet (WSON)
TI | TPS736 (http://www.ti.com/product/TPS736) | 5.5 | 1.25, 1.5, 1.6, 1.8, 1.9, 2.5, 3, 3.2, 3.3, 4.3 | 0.4 | 32 | 30 | See datasheet (SON), 46 mm2: 7.06 x 6.5(SOT-223), 8 mm2: 2.8 x 2.9(SOT-23)
TI | TPS731 (http://www.ti.com/product/TPS731) | 5.5 | 1.25, 1.5, 1.8, 2.5, 3, 3.1, 3.2, 3.3, 5 | 0.15 | 32 | 30 | 8 mm2: 2.8 x 2.9(SOT-23)
TI | TPS732 (http://www.ti.com/product/TPS732) | 5.5 | 1.3, 1.5, 1.6, 1.8, 1.9, 2.5, 3, 3.3, 5 | 0.25 | 32 | 30 | See datasheet (SON), 46 mm2: 7.06 x 6.5(SOT-223), 8 mm2: 2.8 x 2.9(SOT-23)
TI | TPS7A37 (http://www.ti.com/product/TPS7A37) | 5.5 | 2.1, 2.5 | 1 | 32 | 32 | See datasheet (WSON)
TI | TPS786 (http://www.ti.com/product/TPS786) | 5.5 | 1.8, 2.5, 2.8, 3, 3.3 | 1.5 | 32 | 48 | 155 mm2: 15.24 x 10.16(DDPAK/TO-263), See datasheet (SON), 46 mm2: 7.06 x 6.5(SOT-223)
TI | TPS764 (http://www.ti.com/product/TPS764) | 10 | 2.5, 2.7, 2.8, 3, 3.3 | 0.15 | 32 | 50 | 8 mm2: 2.8 x 2.9(SOT-23)
TI | TPS737-Q1 (http://www.ti.com/product/TPS737-Q1) | 5.5 | 1.9, 3.3 | 1 | 32 | 51 | See datasheet (SON)
TI | LP2952-N (http://www.ti.com/product/LP2952-N) | 30 | 3.3, 5 | 0.25 | 32 | 80 | 59 mm2: 6 x 9.9(SOIC)
TI | LP2953 (http://www.ti.com/product/LP2953) | 30 | 3.3, 5 | 0.25 | 32 | 80 | 59 mm2: 6 x 9.9(SOIC)
TI | LP5951 (http://www.ti.com/product/LP5951) | 5.5 | 1.3, 1.5, 1.8, 2, 2.5, 2.8, 3, 3.3, 3.7 | 0.15 | 32 | 125 | 4 mm2: 2.1 x 2(SC70), 8 mm2: 2.8 x 2.9(SOT-23)
TI | LP3966 (http://www.ti.com/product/LP3966) | 7 | 1.8, 2.5, 3.3 | 3 | 32 | 150 | 155 mm2: 15.24 x 10.16(DDPAK/TO-263), See datasheet (TO-220)
TI | LP3965 (http://www.ti.com/product/LP3965) | 7 | 1.8, 2.5, 3.3 | 1.5 | 32 | 150 | 155 mm2: 15.24 x 10.16(DDPAK/TO-263), 45 mm2: 6.96 x 6.5(SOT-223), See datasheet (TO-220)
TI | LP3964 (http://www.ti.com/product/LP3964) | 7 | 1.8, 2.5, 3.3 | 0.8 | 32 | 150 | 155 mm2: 15.24 x 10.16(DDPAK/TO-263), 45 mm2: 6.96 x 6.5(SOT-223), See datasheet (TO-220)
TI | LP3963 (http://www.ti.com/product/LP3963) | 7 | 2.5, 3.3 | 3 | 32 | 150 | 155 mm2: 15.24 x 10.16(DDPAK/TO-263)
TI | LM3940 (http://www.ti.com/product/LM3940) | 5.5 | 3.3 | 1 | 32 | 150 | 155 mm2: 15.24 x 10.16(DDPAK/TO-263), 46 mm2: 7 x 6.5(SOT-223), See datasheet (TO-220)
TI | LP2980-ADJ (http://www.ti.com/product/LP2980-ADJ) | 16 | 15 | 0.05 | 32 | 160 | 8 mm2: 2.8 x 2.9(SOT-23)
TI | TPS7A54-Q1 (http://www.ti.com/product/TPS7A54-Q1) | 6.5 | 5.1 | 4 | 33 | 4.4 | 12 mm2: 3.5 x 3.5(VQFN)
TI | TPS737 (http://www.ti.com/product/TPS737) | 5.5 | 1.8, 2.5, 3, 3.3, 3.4 | 1 | 33 | 48 | See datasheet (SON), 46 mm2: 7.06 x 6.5(SOT-223), See datasheet (WSON)
TI | LP5990 (http://www.ti.com/product/LP5990) | 5.5 | 1.2, 1.3, 1.8, 2.8, 3, 3.3, 3.6 | 0.2 | 33 | 60 | See datasheet (DSBGA)
TI | LP3879 (http://www.ti.com/product/LP3879) | 6 | 1, 1.2 | 0.8 | 35 | 18 | 29 mm2: 6 x 4.9(SO PowerPAD), See datasheet (WSON)
TI | LP3878-ADJ (http://www.ti.com/product/LP3878-ADJ) | 16 | 5.5 | 0.8 | 35 | 18 | 29 mm2: 6 x 4.9(SO PowerPAD), See datasheet (WSON)
TI | LM337-N (http://www.ti.com/product/LM337-N) | -4.2 | -1.2 | 1.5 | 35 | 38 | 46 mm2: 7 x 6.5(SOT-223), See datasheet (TO-220)
TI | TL783 (http://www.ti.com/product/TL783) | 125 | 125 | 0.7 | 35 | 38 | 155 mm2: 15.24 x 10.16(DDPAK/TO-263), See datasheet (TO-220)
TI | TPS790 (http://www.ti.com/product/TPS790) | 10 | 1.5, 1.8, 2.5, 2.8, 3 | 0.05 | 35 | 56 | 8 mm2: 2.8 x 2.9(SOT-23)
TI | LP38852 (http://www.ti.com/product/LP38852) | 5.5 | 1.8 | 1.5 | 35 | 90 | 154 mm2: 15.24 x 10.1(DDPAK/TO-263), 29 mm2: 6 x 4.9(SO PowerPAD), See datasheet (TO-220)
TI | LP3997 (http://www.ti.com/product/LP3997) | 6 | 3.3 | 0.25 | 35 | 100 | 15 mm2: 4.9 x 3(VSSOP)
TI | LP3990-Q1 (http://www.ti.com/product/LP3990-Q1) | 6 | 0.8, 1.2, 1.35, 1.5, 1.8, 2.5, 2.8, 3.3 | 0.15 | 35 | 150 | See datasheet (DSBGA)
TI | LP3990 (http://www.ti.com/product/LP3990) | 6 | 0.8, 1.2, 1.35, 1.5, 1.8, 2.5, 2.8, 3.3 | 0.15 | 35 | 150 | See datasheet (DSBGA), 8 mm2: 2.8 x 2.9(SOT-23), See datasheet (WSON)
TI | LP38853 (http://www.ti.com/product/LP38853) | 5.5 | 1.8 | 3 | 35 | 150 | 154 mm2: 15.24 x 10.1(DDPAK/TO-263), 29 mm2: 6 x 4.9(SO PowerPAD), See datasheet (TO-220)
TI | LM2930 (http://www.ti.com/product/LM2930) | 26 | 5, 8 | 0.15 | 35 | 170 | See datasheet (TO-220)
TI | LM79L (http://www.ti.com/product/LM79L) | -7 | -5, -12, -15 | 0.1 | 35 | 400 | See datasheet (DSBGA), 29 mm2: 6 x 4.9(SOIC), 18 mm2: 4.3 x 4.3(TO-92)
TI | LM2936Q-Q1 (http://www.ti.com/product/LM2936Q-Q1) | 60 | 3, 3.3, 5 | 0.05 | 35 | 500 | 29 mm2: 6 x 4.9(SOIC), 46 mm2: 7 x 6.5(SOT-223), 65 mm2: 9.91 x 6.58(TO-252), 15 mm2: 4.9 x 3(VSSOP)
TI | LM2936 (http://www.ti.com/product/LM2936) | 60 | 3, 3.3, 5 | 0.05 | 35 | 500 | 29 mm2: 6 x 4.9(SOIC), 46 mm2: 7 x 6.5(SOT-223), 65 mm2: 9.91 x 6.58(TO-252), 18 mm2: 4.3 x 4.3(TO-92), 15 mm2: 4.9 x 3(VSSOP)
TI | TPS714 (http://www.ti.com/product/TPS714) | 10 | 3.3 | 0.08 | 35 | 575 | 4 mm2: 2.1 x 2(SC70), See datasheet (WSON)
TI | TPS798-Q1 (http://www.ti.com/product/TPS798-Q1) | 50 | 5 | 0.05 | 36 | 100 | 15 mm2: 4.9 x 3(MSOP-PowerPAD)
TI | TPS79133-EP (http://www.ti.com/product/TPS79133-EP) | 5.5 | 3.3 | 0.1 | 37 | 15 | 8 mm2: 2.8 x 2.9(SOT-23)
TI | LP38855 (http://www.ti.com/product/LP38855) | 5.5 | 0.8, 1.2 | 1.5 | 37 | 150 | 155 mm2: 15.24 x 10.16(DDPAK/TO-263), See datasheet (TO-220)
TI | LP38856 (http://www.ti.com/product/LP38856) | 5.5 | 0.8, 1.2 | 3 | 37 | 150 | 155 mm2: 15.24 x 10.16(DDPAK/TO-263), See datasheet (TO-220)
TI | LP38859 (http://www.ti.com/product/LP38859) | 5.5 | 0.8, 1.2 | 3 | 37 | 150 | 155 mm2: 15.24 x 10.16(DDPAK/TO-263), See datasheet (TO-220)
TI | LP38858 (http://www.ti.com/product/LP38858) | 5.5 | 1.2 | 1.5 | 37 | 150 | 155 mm2: 15.24 x 10.16(DDPAK/TO-263), See datasheet (TO-220)
TI | LMS8117A (http://www.ti.com/product/LMS8117A) | 15 | 1.8, 3.3 | 1 | 37 | 412.5 | 46 mm2: 7 x 6.5(SOT-223), 65 mm2: 9.91 x 6.58(TO-252)
TI | LM9076Q-Q1 (http://www.ti.com/product/LM9076Q-Q1) | 40 | 3.3, 5 | 0.15 | 37 |  | 29 mm2: 6 x 4.9(SOIC)
TI | LM9076 (http://www.ti.com/product/LM9076) | 40 | 3.3, 5 | 0.15 | 37 |  | 155 mm2: 15.24 x 10.16(DDPAK/TO-263), 29 mm2: 6 x 4.9(SOIC)
TI | TPS799 (http://www.ti.com/product/TPS799) | 6.5 | 1.2, 1.25, 1.3, 1.5, 1.8, 1.85, 1.9, 1.95, 2, 2.1, 2.5, 2.6, 2.7, 2.75, 2.8, 2.85, 3, 3.15, 3.2, 3.3, 4.2, 4.5 | 0.2 | 38 | 29 | See datasheet (DSBGA), 8 mm2: 2.8 x 2.9(SOT-23-THIN), See datasheet (WSON)
TI | TPS79901-EP (http://www.ti.com/product/TPS79901-EP) | 6.5 | 6.5 | 0.2 | 38 | 29 | See datasheet (WSON)
TI | TPS799-Q1 (http://www.ti.com/product/TPS799-Q1) | 6.5 | 1.2, 1.5, 1.8, 2.5, 2.7, 3.3 | 0.2 | 38 | 30 | 8 mm2: 2.8 x 2.9(SOT-23-THIN), See datasheet (WSON)
TI | LP2982 (http://www.ti.com/product/LP2982) | 16 | 3, 3.3, 5 | 0.05 | 38 | 30 | 8 mm2: 2.8 x 2.9(SOT-23)
TI | LM317L (http://www.ti.com/product/LM317L) | 35 | 32 | 0.1 | 38 | 30 | 29 mm2: 6 x 4.9(SOIC), 18 mm2: 4.095 x 4.5(SOT-89), 18 mm2: 4.3 x 4.3(TO-92), 19 mm2: 6.4 x 3(TSSOP)
TI | TPS794 (http://www.ti.com/product/TPS794) | 5.5 | 1.8, 2.5, 2.8, 3, 3.3 | 0.25 | 38 | 32 | 15 mm2: 4.9 x 3(MSOP-PowerPAD), 46 mm2: 7.06 x 6.5(SOT-223)
TI | TPS7A45 (http://www.ti.com/product/TPS7A45) | 20 | 1.5, 1.8, 2.5, 3.3 | 1.5 | 38 | 35 | 155 mm2: 15.24 x 10.16(DDPAK/TO-263), 46 mm2: 7.06 x 6.5(SOT-223)
TI | TPS7A4501M (http://www.ti.com/product/TPS7A4501M) | 20 | 20 | 0.75 | 38 | 35 | See datasheet (CFP)
TI | TPS7A4501-SP (http://www.ti.com/product/TPS7A4501-SP) | 20 | 20 | 1.5 | 38 | 35 | See datasheet (CFP)
TI | LM317 (http://www.ti.com/product/LM317) | 40 | 37 | 1.5 | 38 | 38 | 155 mm2: 15.24 x 10.16(DDPAK/TO-263), 46 mm2: 7 x 6.5(SOT-223), See datasheet (TO-220)
TI | LM330-N (http://www.ti.com/product/LM330-N) | 26 | 5 | 0.15 | 38 | 50 | See datasheet (TO-220)
TI | TPS799L (http://www.ti.com/product/TPS799L) | 6.5 | 5.4, 5.7 | 0.2 | 38 | 54 | See datasheet (DSBGA)
TI | TPS7A4001 (http://www.ti.com/product/TPS7A4001) | 100 | 90 | 0.05 | 38 | 58 | 15 mm2: 4.9 x 3(MSOP-PowerPAD)
TI | TPS7A4001-EP (http://www.ti.com/product/TPS7A4001-EP) | 100 | 90 | 0.05 | 38 | 58 | 15 mm2: 4.9 x 3(MSOP-PowerPAD)
TI | TPS7A4101 (http://www.ti.com/product/TPS7A4101) | 50 | 48 | 0.05 | 38 | 58 | 15 mm2: 4.9 x 3(MSOP-PowerPAD)
TI | TPS7A4201 (http://www.ti.com/product/TPS7A4201) | 28 | 26 | 0.05 | 38 | 58 | 15 mm2: 4.9 x 3(MSOP-PowerPAD)
TI | LP2983 (http://www.ti.com/product/LP2983) | 16 | 1, 1.2 | 0.15 | 38 | 60 | 8 mm2: 2.8 x 2.9(SOT-23)
TI | TPS766 (http://www.ti.com/product/TPS766) | 10 | 1.5, 1.8, 2.5, 2.8, 3, 3.3, 5 | 0.25 | 38 | 200 | 29 mm2: 6 x 4.9(SOIC)
TI | UC385 (http://www.ti.com/product/UC385) | 7.5 | 1.5, 2.1, 2.5 | 5 | 38 |  | 155 mm2: 15.24 x 10.16(DDPAK/TO-263), See datasheet (TO-220)
TI | UC285 (http://www.ti.com/product/UC285) | 7.5 | 1.5, 2.1, 2.5 | 5 | 38 |  | 155 mm2: 15.24 x 10.16(DDPAK/TO-263), See datasheet (TO-220)
TI | UC382 (http://www.ti.com/product/UC382) | 7.5 | 1.5, 2.1, 2.5 | 3 | 38 |  | 155 mm2: 15.24 x 10.16(DDPAK/TO-263), See datasheet (TO-220)
TI | UC282 (http://www.ti.com/product/UC282) | 7.5 | 1.5, 2.1, 2.5 | 3 | 38 |  | 155 mm2: 15.24 x 10.16(DDPAK/TO-263), See datasheet (TO-220)
Onsemi | 0 | 5.5 | 1.2 1.35 1.5 1.7 1.8 1.9 2.1 2.5 2.8 2.85 3 3.1 3.2 3.3 3.6 | 0.15 | 38 40 41 47 57 | 85 90 95 105 120 125 130 | SOT563-6 XDFN-4
TI | TPS7A53-Q1 (http://www.ti.com/product/TPS7A53-Q1) | 6.5 | 5.15 | 3 | 39 | 4.4 | 12 mm2: 3.5 x 3.5(VQFN)
Onsemi | 0 | 35 | 15 | 0.1 | 39 | 90 | SOIC-8 TO-92 TO-92-3 TO-92-3 LF
TI | TPS7A3501 (http://www.ti.com/product/TPS7A3501) | 5 | 4.5 | 1 | 40 | 3.8 | See datasheet (WSON)
TI | TPS7A83A (http://www.ti.com/product/TPS7A83A) | 6.5 | 5.2 | 2 | 40 | 4.4 | 12 mm2: 3.5 x 3.5(VQFN)
TI | TPS7A8300 (http://www.ti.com/product/TPS7A8300) | 6.5 | 5 | 2 | 40 | 6 | 12 mm2: 3.5 x 3.5(VQFN), 25 mm2: 5 x 5(VQFN)
TI | LP5900 (http://www.ti.com/product/LP5900) | 5.5 | 1.5, 1.575, 1.8, 1.9, 2, 2.1, 2.2, 2.3, 2.5, 2.6, 2.65, 2.7, 2.75, 2.8, 2.85, 3.0, 3.3, 4.5 | 0.15 | 40 | 6.5 | See datasheet (DSBGA), See datasheet (WSON)
TI | LP5910 (http://www.ti.com/product/LP5910) | 3.3 | 0.9, 1, 1.1, 1.2, 1.8 | 0.3 | 40 | 12 | See datasheet (DSBGA), See datasheet (WSON)
TI | LP5912 (http://www.ti.com/product/LP5912) | 6.5 | 0.9, 1.1, 1.2, 1.5, 1.8, 2.8, 3, 3.3 | 0.5 | 40 | 12 | See datasheet (WSON)
TI | LP5912-Q1 (http://www.ti.com/product/LP5912-Q1) | 6.5 | 0.9, 1.1, 1.2, 1.5, 1.8, 2.8, 3, 3.3 | 0.5 | 40 | 12 | See datasheet (WSON)
TI | LM350A (http://www.ti.com/product/LM350A) | 35 | 32 | 3 | 40 | 13 | See datasheet (TO-220)
TI | LM350-N (http://www.ti.com/product/LM350-N) | 35 | 32 | 3 | 40 | 13 | See datasheet (TO-220)
TI | LP2992 (http://www.ti.com/product/LP2992) | 16 | 1.5, 1.8, 2.5, 3.3, 5 | 0.25 | 40 | 30 | 8 mm2: 2.8 x 2.9(SOT-23), See datasheet (WSON)
TI | LP2985 (http://www.ti.com/product/LP2985) | 16 | 1.8, 2.5, 2.8, 2.9, 3, 3.3, 5, 10 | 0.15 | 40 | 30 | 8 mm2: 2.8 x 2.9(SOT-23)
TI | LP2985A (http://www.ti.com/product/LP2985A) | 16 | 1.8, 2.5, 2.8, 2.9, 3, 3.3, 5, 10 | 0.15 | 40 | 30 | 8 mm2: 2.8 x 2.9(SOT-23)
TI | TPS795 (http://www.ti.com/product/TPS795) | 5.5 | 1.6, 1.8, 2.5, 3, 3.3 | 0.5 | 40 | 33 | See datasheet (SON), 46 mm2: 7.06 x 6.5(SOT-223)
TI | TPS79501-Q1 (http://www.ti.com/product/TPS79501-Q1) | 5.5 | 5.4 | 0.5 | 40 | 33 | See datasheet (SON)
TI | LM317-N (http://www.ti.com/product/LM317-N) | 40 | 37 | 1.5 | 40 | 35 | 155 mm2: 15.24 x 10.16(DDPAK/TO-263), 46 mm2: 7 x 6.5(SOT-223), See datasheet (TO-220), 65 mm2: 9.91 x 6.58(TO-252)
TI | LM317A (http://www.ti.com/product/LM317A) | 40 | 37 | 1.5 | 40 | 38 | 46 mm2: 7 x 6.5(SOT-223), 92 mm2: 9.14 x 10.03(TO), See datasheet (TO-220), 65 mm2: 9.91 x 6.58(TO-252)
TI | LM140L (http://www.ti.com/product/LM140L) | 35 | 5, 12, 15 | 0.1 | 40 | 40 | 92 mm2: 9.14 x 10.03(TO)
TI | LM78M (http://www.ti.com/product/LM78M) | 35 | 5, 15 | 0.5 | 40 | 40 | See datasheet (TO-220), 65 mm2: 9.91 x 6.58(TO-252)
TI | LM78L (http://www.ti.com/product/LM78L) | 30 | 5, 6.2, 9, 12, 15 | 0.1 | 40 | 40 | See datasheet (DSBGA), 29 mm2: 6 x 4.9(SOIC), 18 mm2: 4.3 x 4.3(TO-92)
TI | TLV707 (http://www.ti.com/product/TLV707) | 5.5 | 0.85, 1, 1.15, 1.35, 1.7, 1.8, 1.85, 2.5, 2.6, 2.85, 2.9, 3, 3.1, 3.2, 3.3, 3.35, 3.4, 3.6 | 0.2 | 40 | 45 | 1 mm2: 1 x 1(X2SON)
TI | TLV707P (http://www.ti.com/product/TLV707P) | 5 | 1, 1.1, 1.2, 1.5, 1.8, 1.85, 1.9, 2.5, 2.6, 2.8, 2.85, 2.9, 3, 3.3, 3.4, 3.6 | 0.2 | 40 | 45 | 1 mm2: 1 x 1(X2SON)
TI | TLV742P (http://www.ti.com/product/TLV742P) | 5.5 | 1.1, 1.2, 1.5, 1.8, 2.7, 2.8, 2.9, 3.3 | 0.2 | 40 | 45 | 1 mm2: 1 x 1(X2SON)
TI | TPS76201-Q1 (http://www.ti.com/product/TPS76201-Q1) | 10 | 5.5 | 0.1 | 40 | 60 | 8 mm2: 2.8 x 2.9(SOT-23)
TI | TPS76201 (http://www.ti.com/product/TPS76201) | 10 | 5.5 | 0.1 | 40 | 60 | 8 mm2: 2.8 x 2.9(SOT-23)
TI | LM117 (http://www.ti.com/product/LM117) | 40 | 37 | 1.5 | 40 | 75 | 92 mm2: 9.14 x 10.03(TO), 969 mm2: 24.89 x 38.94(TO-3)
Onsemi | 0 | 24 | 2.5 3.3 4.8 5 10 12 Adjustable | 0.15 | 40 | 80 | SOT-23-5 XDFN-6
TI | LP3893 (http://www.ti.com/product/LP3893) | 5.5 | 1.2 | 3 | 40 | 150 | 155 mm2: 15.24 x 10.16(DDPAK/TO-263)
TI | TPS728 (http://www.ti.com/product/TPS728) | 6.5 | 1.2, 1.5, 1.75, 1.8, 1.85, 2.85, 2.95, 3, 3.15, 3.3 | 0.2 | 40 | 210 | See datasheet (DSBGA), See datasheet (WSON)
TI | LM317HV (http://www.ti.com/product/LM317HV) | 60 | 57 | 1.5 | 40 | 1710 | See datasheet (TO-220)
TI | LM117HV (http://www.ti.com/product/LM117HV) | 60 | 57 | 1.5 | 40 | 1710 | 92 mm2: 9.14 x 10.03(TO)
Onsemi | 0 | 12 | 1.8 2.5 3.3 5 Adjustable | 0.5 | 40 | 33 35 46 58 | DFN-10
Onsemi | 0 | 12 | 1.8 2.5 3.3 5 Adjustable | 0.5 | 40 | 33 35 46 58 | DFN-10
TI | LP3983 (http://www.ti.com/product/LP3983) | 6 | 2.5 | 0.005 | 40 |  | See datasheet (DSBGA)
TI | TPS7A66-Q1 (http://www.ti.com/product/TPS7A66-Q1) | 40 | 3.3, 5 | 0.15 | 40 |  | 15 mm2: 4.9 x 3(MSOP-PowerPAD)
TI | TPS7A69-Q1 (http://www.ti.com/product/TPS7A69-Q1) | 40 | 3.3, 5 | 0.15 | 40 |  | 29 mm2: 6 x 4.9(SOIC)
TI | TPS7A61-Q1 (http://www.ti.com/product/TPS7A61-Q1) | 40 | 3.3, 5 | 0.3 | 40 |  | 67 mm2: 10.11 x 6.6(TO-252)
TI | TPS7A60-Q1 (http://www.ti.com/product/TPS7A60-Q1) | 40 | 3.3, 5 | 0.3 | 40 |  | 155 mm2: 15.24 x 10.16(DDPAK/TO-263), 67 mm2: 10.11 x 6.6(TO-252)
TI | TPS7A63-Q1 (http://www.ti.com/product/TPS7A63-Q1) | 40 | 3.3, 5 | 0.3 | 40 |  | 32 mm2: 6.4 x 5(HTSSOP), 12 mm2: 3 x 4(VSON)
TI | TPS7A65-Q1 (http://www.ti.com/product/TPS7A65-Q1) | 40 | 3.3, 5.5 | 0.3 | 40 |  | 40 mm2: 6.6 x 6.1(TO-252)
TI | TPS7A6401-Q1 (http://www.ti.com/product/TPS7A6401-Q1) | 40 | 7 | 0.3 | 40 |  | 32 mm2: 6.4 x 5(HTSSOP)
TI | TPS7A6201-Q1 (http://www.ti.com/product/TPS7A6201-Q1) | 40 | 7 | 0.3 | 40 |  | 155 mm2: 15.24 x 10.16(DDPAK/TO-263)
TI | LM117HVQML-SP (http://www.ti.com/product/LM117HVQML-SP) | 60 | 1.25 | 1.5 | 40 |  | See datasheet (CFP), 92 mm2: 9.14 x 10.03(TO)
TI | TPS763 (http://www.ti.com/product/TPS763) | 10 | 1.6, 1.8, 2.5, 2.7, 2.8, 3, 3.3, 3.8, 5 | 0.15 | 41 | 140 | 8 mm2: 2.8 x 2.9(SOT-23)
TI | LP2981-N (http://www.ti.com/product/LP2981-N) | 16 | 2.5, 3, 3.3, 3.6, 5 | 0.1 | 41 | 160 | 8 mm2: 2.8 x 2.9(SOT-23)
TI | LP3985 (http://www.ti.com/product/LP3985) | 6 | 2.5, 2.6, 2.7, 2.8, 2.85, 2.9, 3, 3.1, 3.2, 3.3, 4.7, 4.75, 4.8, 5 | 0.15 | 42 | 30 | See datasheet (DSBGA), 8 mm2: 2.8 x 2.9(SOT-23)
TI | TPS796 (http://www.ti.com/product/TPS796) | 5.5 | 1.3, 1.8, 2.5, 2.8, 3, 3.3, 5 | 1 | 42 | 42 | 155 mm2: 15.24 x 10.16(DDPAK/TO-263), See datasheet (SON), 46 mm2: 7.06 x 6.5(SOT-223)
TI | TPS79633-Q1 (http://www.ti.com/product/TPS79633-Q1) | 5.5 | 3.3 | 1 | 42 | 42 | 46 mm2: 7.06 x 6.5(SOT-223)
TI | LP38511 (http://www.ti.com/product/LP38511) | 5.5 | 1.8 | 0.8 | 42 | 75 | 155 mm2: 15.24 x 10.16(DDPAK/TO-263), 142 mm2: 14.01 x 10.16(TO-263)
Onsemi | 0 | 35 | 12 | 0.1 | 42 | 80 | SOIC-8 TO-92
TI | LP38691-ADJ-Q1 (http://www.ti.com/product/LP38691-ADJ-Q1) | 10 | 9 | 0.5 | 42 | 80 | See datasheet (WSON)
TI | LP2987 (http://www.ti.com/product/LP2987) | 16 | 3, 3.3, 5 | 0.2 | 42 | 100 | 29 mm2: 6 x 4.9(SOIC), 15 mm2: 4.9 x 3(VSSOP), See datasheet (WSON)
TI | TPS763-Q1 (http://www.ti.com/product/TPS763-Q1) | 10 | 1.6, 1.8, 2.5, 3, 3.3, 5 | 0.15 | 42 | 140 | 8 mm2: 2.8 x 2.9(SOT-23)
TI | LP2986 (http://www.ti.com/product/LP2986) | 16 | 3, 3.3, 5 | 0.2 | 42 | 160 | 29 mm2: 6 x 4.9(SOIC), 15 mm2: 4.9 x 3(VSSOP), See datasheet (WSON)
TI | LP2951-50 (http://www.ti.com/product/LP2951-50) | 30 | 5 | 0.1 | 42 | 160 | See datasheet (PDIP)
TI | TLV701 (http://www.ti.com/product/TLV701) | 24 | 3, 3.3 | 0.15 | 42 | 550 | 8 mm2: 2.8 x 2.9(SOT-23)
TI | TLV704 (http://www.ti.com/product/TLV704) | 24 | 3, 3.3, 3.6, 5 | 0.15 | 42 | 550 | 8 mm2: 2.8 x 2.9(SOT-23)
TI | TPS715 (http://www.ti.com/product/TPS715) | 24 | 1.8, 1.9, 2.3, 2.5, 3, 3.3, 3.4, 5 | 0.05 | 42 | 575 | 4 mm2: 2.1 x 2(SC70)
TI | TPS715-Q1 (http://www.ti.com/product/TPS715-Q1) | 24 | 2.5, 3, 3.3, 5 | 0.05 | 42 | 575 | 4 mm2: 2.1 x 2(SC70)
TI | TPS715A (http://www.ti.com/product/TPS715A) | 24 | 3, 3.3 | 0.08 | 42 | 575 | See datasheet (SON), See datasheet (WSON)
TI | TPS740 (http://www.ti.com/product/TPS740) | 6 | 1.2 | 1.5 | 42 |  | 15 mm2: 4.9 x 3(VSSOP)
TI | TPS793-Q1 (http://www.ti.com/product/TPS793-Q1) | 5.5 | 1.8, 2.5, 2.8, 3, 3.3 | 0.2 | 43 | 32 | 8 mm2: 2.8 x 2.9(SOT-23), 8 mm2: 2.8 x 2.9(SOT-23)
TI | TPS730 (http://www.ti.com/product/TPS730) | 5.5 | 1.8, 2.5, 2.8, 2.85, 3, 3.3, 4.7 | 0.2 | 43 | 33 | See datasheet (DSBGA), 8 mm2: 2.8 x 2.9(SOT-23), 8 mm2: 2.8 x 2.9(SOT-23)
TI | LM340L (http://www.ti.com/product/LM340L) | 35 | 5, 12, 15 | 0.1 | 43 | 40 | 18 mm2: 4.3 x 4.3(TO-92)
TI | TLV717P (http://www.ti.com/product/TLV717P) | 5.5 | 1.2, 1.3, 1.5, 1.8, 1.85, 2.1, 2.5, 2.7, 2.8, 2.85, 2.9, 3, 3.3, 3.6 | 0.15 | 43 | 55 | 1 mm2: 1 x 1(X2SON)
TI | TPS7B4254-Q1 (http://www.ti.com/product/TPS7B4254-Q1) | 40 | 40 | 0.15 | 43 |  | 29 mm2: 6 x 4.9(SO PowerPAD)
TI | TPS79318-EP (http://www.ti.com/product/TPS79318-EP) | 5.5 | 1.8 | 0.2 | 44 | 32 | 8 mm2: 2.8 x 2.9(SOT-23)
TI | TPS79301-EP (http://www.ti.com/product/TPS79301-EP) | 5.5 | 1.8, 2.5, 2.8, 2.85, 3, 3.3, 4.75 | 0.2 | 44 | 32 | 8 mm2: 2.8 x 2.9(SOT-23)
TI | TPS793 (http://www.ti.com/product/TPS793) | 5.5 | 1.8, 2.5, 2.8, 2.85, 3, 3.3, 4.75 | 0.2 | 44 | 32 | See datasheet (DSBGA), 8 mm2: 2.8 x 2.9(SOT-23), 8 mm2: 2.8 x 2.9(SOT-23)
TI | TPS79333-EP (http://www.ti.com/product/TPS79333-EP) | 5.5 | 3.3 | 0.2 | 44 | 32 | 8 mm2: 2.8 x 2.9(SOT-23)
TI | TPS793475-EP (http://www.ti.com/product/TPS793475-EP) | 5.5 | 4.75 | 0.2 | 44 | 32 | 8 mm2: 2.8 x 2.9(SOT-23)
TI | TPS7A52-Q1 (http://www.ti.com/product/TPS7A52-Q1) | 6.5 | 5.2 | 2 | 45 | 4.4 | 12 mm2: 3.5 x 3.5(VQFN)
TI | TPS79101-EP (http://www.ti.com/product/TPS79101-EP) | 5.5 | 1.8, 3.3, 4.7 | 0.1 | 45 | 15 | 8 mm2: 2.8 x 2.9(SOT-23)
TI | TPS791-Q1 (http://www.ti.com/product/TPS791-Q1) | 5.5 | 1.8, 3.3, 4.7 | 0.1 | 45 | 15 | 8 mm2: 2.8 x 2.9(SOT-23), 8 mm2: 2.8 x 2.9(SOT-23)
TI | TPS791 (http://www.ti.com/product/TPS791) | 5.5 | 1.8, 3.3, 4.7 | 0.1 | 45 | 15 | 8 mm2: 2.8 x 2.9(SOT-23), 8 mm2: 2.8 x 2.9(SOT-23)
TI | TPS79147-EP (http://www.ti.com/product/TPS79147-EP) | 5.5 | 4.7 | 0.1 | 45 | 15 | 8 mm2: 2.8 x 2.9(SOT-23)
TI | TPS74301 (http://www.ti.com/product/TPS74301) | 5.5 | 3.6 | 1.5 | 45 | 20 | 154 mm2: 15.24 x 10.1(DDPAK/TO-263), 25 mm2: 5 x 5(VQFN)
TI | TPS727 (http://www.ti.com/product/TPS727) | 5.5 | 1, 1.05, 1.1, 1.2, 1.5, 1.8, 1.85, 1.9, 2.5, 2.7, 2.8, 2.85, 3, 3.3, 4.8, 5 | 0.25 | 45 | 33.5 | See datasheet (DSBGA), See datasheet (WSON)
TI | TL1963A (http://www.ti.com/product/TL1963A) | 20 | 1.5, 1.8, 2.5, 3.3 | 1.5 | 45 | 40 | 155 mm2: 15.24 x 10.16(DDPAK/TO-263), 46 mm2: 7 x 6.5(SOT-223), 46 mm2: 7.06 x 6.5(SOT-223)
TI | LM341 (http://www.ti.com/product/LM341) | 35 | 5, 15 | 0.5 | 45 | 40 | See datasheet (TO-220)
TI | TL1963A-Q1 (http://www.ti.com/product/TL1963A-Q1) | 20 | 20 | 1.5 | 45 | 40 | 155 mm2: 15.24 x 10.16(DDPAK/TO-263)
TI | TPS73801 (http://www.ti.com/product/TPS73801) | 20 | 20 | 1 | 45 | 45 | 46 mm2: 7.06 x 6.5(SOT-223)
TI | TLV757P (http://www.ti.com/product/TLV757P) | 5.5 | 0.9, 1, 1.2, 1.5, 1.8, 1.9, 2.5, 2.8, 2.9, 3, 3.3, 4 | 1 | 45 | 60 | See datasheet (WSON)
TI | LP38693-ADJ (http://www.ti.com/product/LP38693-ADJ) | 10 | 9 | 0.5 | 45 | 80 | 45 mm2: 6.96 x 6.5(SOT-223), See datasheet (WSON)
TI | LP38690-ADJ (http://www.ti.com/product/LP38690-ADJ) | 10 | 9 | 1 | 45 | 80 | See datasheet (WSON)
TI | LP38691-ADJ (http://www.ti.com/product/LP38691-ADJ) | 10 | 9 | 0.5 | 45 | 80 | See datasheet (WSON)
TI | LP38693-ADJ-Q1 (http://www.ti.com/product/LP38693-ADJ-Q1) | 10 | 9 | 0.5 | 45 | 80 | See datasheet (WSON)
TI | LP38692-ADJ (http://www.ti.com/product/LP38692-ADJ) | 10 | 9 | 1 | 45 | 80 | 45 mm2: 6.96 x 6.5(SOT-223), See datasheet (WSON)
TI | LP3881 (http://www.ti.com/product/LP3881) | 5.5 | 1.2, 1.5, 1.8 | 0.8 | 45 | 90 | 155 mm2: 15.24 x 10.16(DDPAK/TO-263)
TI | LP3882 (http://www.ti.com/product/LP3882) | 5.5 | 1.2, 1.5, 1.8 | 1.5 | 45 | 90 | 155 mm2: 15.24 x 10.16(DDPAK/TO-263), 29 mm2: 6 x 4.9(SO PowerPAD)
TI | TLV760 (http://www.ti.com/product/TLV760) | 30 | 3.3, 5, 12, 15 | 0.1 | 45 | 100 | 4 mm2: 1.3 x 2.92(SOT-23)
TI | LM3480 (http://www.ti.com/product/LM3480) | 30 | 3.3, 5, 12, 15 | 0.1 | 45 | 100 | 4 mm2: 1.3 x 2.92(SOT-23)
TI | LP2980-N (http://www.ti.com/product/LP2980-N) | 16 | 2.5, 3, 3.3, 3.8, 4.7, 5 | 0.05 | 45 | 160 | 8 mm2: 2.8 x 2.9(SOT-23)
Onsemi | 0 | 40 | 24 | 0.1 | 45 | 200 | TO-92
TI | TPS765 (http://www.ti.com/product/TPS765) | 10 | 1.5, 1.8, 2.5, 2.8, 3, 3.3, 5 | 0.15 | 45 | 200 | 29 mm2: 6 x 4.9(SOIC)
TI | TPS7A19 (http://www.ti.com/product/TPS7A19) | 40 | 18 | 0.45 | 45 |  | See datasheet (SON)
TI | REG101 (http://www.ti.com/product/REG101) | 10 | 2.5, 2.8, 2.85, 3, 3.3, 5 | 0.1 | 46 | 23 | 29 mm2: 6 x 4.9(SOIC), 8 mm2: 2.8 x 2.9(SOT-23)
TI | REG102 (http://www.ti.com/product/REG102) | 10 | 2.5, 2.8, 2.85, 3, 3.3, 5 | 0.25 | 46 | 28 | 29 mm2: 6 x 4.9(SOIC), 46 mm2: 7.06 x 6.5(SOT-223), 8 mm2: 2.8 x 2.9(SOT-23)
TI | TPS792 (http://www.ti.com/product/TPS792) | 5.5 | 2.5, 2.8, 3 | 0.1 | 47 | 27 | 8 mm2: 2.8 x 2.9(SOT-23), 8 mm2: 2.8 x 2.9(SOT-23)
TI | LM1117 (http://www.ti.com/product/LM1117) | 15 | 1.8, 2.5, 3.3, 5 | 0.8 | 47 | 38 | 155 mm2: 15.24 x 10.16(DDPAK/TO-263), 46 mm2: 7 x 6.5(SOT-223), See datasheet (TO-220), 65 mm2: 9.91 x 6.58(TO-252), See datasheet (WSON)
TI | TPS7A92 (http://www.ti.com/product/TPS7A92) | 6.5 | 5.2 | 2 | 48 | 4.7 | See datasheet (SON)
TI | TPS7A90 (http://www.ti.com/product/TPS7A90) | 6.5 | 5.7 | 0.5 | 48 | 4.7 | See datasheet (SON)
TI | TPS7A91 (http://www.ti.com/product/TPS7A91) | 6.5 | 5.2 | 1 | 48 | 4.7 | See datasheet (SON)
TI | LM7800 (http://www.ti.com/product/LM7800) | 30 | 5, 12, 15 | 1.5 | 48 | 40 | 155 mm2: 15.24 x 10.16(DDPAK/TO-263), 46 mm2: 7 x 6.5(SOT-223), See datasheet (TO-220)
Onsemi | 0 | 30 | 3 3.3 5 | 0.1 | 48 | 56 | DPAK-3 TO-92
Onsemi | 0 | 30 | 3 3.3 Adjustable | 0.1 | 48 | 56 | Micro8™ PDIP-8 SOIC-8
TI | TPS723 (http://www.ti.com/product/TPS723) | -2.7 | -2.5 | 0.2 | 48 | 60 | 8 mm2: 2.8 x 2.9(SOT-23), 8 mm2: 2.8 x 2.9(SOT-23-THIN)
TI | TPS723-Q1 (http://www.ti.com/product/TPS723-Q1) | -2.7 | -2.5 | 0.2 | 48 | 60 | 8 mm2: 2.8 x 2.9(SOT-23)
Onsemi | 0 | 35 | 18 | 0.1 | 48 | 150 | TO-92
TI | LM2940-N (http://www.ti.com/product/LM2940-N) | 26 | 5, 8, 9, 10, 12, 15 | 1 | 48 | 150 | 155 mm2: 15.24 x 10.16(DDPAK/TO-263), 46 mm2: 7 x 6.5(SOT-223), See datasheet (TO-220), See datasheet (WSON)
Onsemi | 0 | 30 | 5 | 0.1 | 49 | 40 | SOIC-8 SOT-89-3 TO-92
Onsemi | 0 | -30 -5 | -5 | 0.1 | 49 | 40 | SOIC-8 TO-92
Onsemi | 0 | -30 | -5 | 0.1 | 49 | 40 | SOT-89-3 TO-92-3
Onsemi | 0 | -35 | -12 | 0.1 | 49 | 40 | SOIC-8 TO-92
Onsemi | 0 | -35 | -15 | 0.1 | 49 | 40 | SOIC-8 TO-92
Onsemi | 0 | -35 | -18 | 0.1 | 49 | 40 | TO-92
Onsemi | 0 | -40 | -24 | 0.1 | 49 | 40 | TO-92
Onsemi | 0 | 30 | 5 | 0.1 | 49 | 40 | SOIC-8 TO-92
Onsemi | 0 | 35 | 12 | 0.1 | 49 | 40 | SOIC-8 TO-92
TI | LP5904 (http://www.ti.com/product/LP5904) | 5.58 | 1.2, 2.8, 2.85, 3.1, 3.3, 3.4, 4.4 | 0.2 | 50 | 6.5 | See datasheet (DSBGA)
TI | TPS74401-EP (http://www.ti.com/product/TPS74401-EP) | 5.5 | 3.6 | 3 | 50 | 13 | 25 mm2: 5 x 5(VQFN)
TI | TPS74401 (http://www.ti.com/product/TPS74401) | 5.5 | 3.6 | 3 | 50 | 13 | 154 mm2: 15.24 x 10.1(DDPAK/TO-263), 12 mm2: 3.5 x 3.5(VQFN), 25 mm2: 5 x 5(VQFN)
TI | TLV712 (http://www.ti.com/product/TLV712) | 5.5 | 0.9, 1, 1.1 | 0.3 | 50 | 30 | 8 mm2: 2.8 x 2.9(SOT-23), See datasheet (WSON)
TI | LM140K (http://www.ti.com/product/LM140K) | 35 | 5, 12, 15 | 1 | 50 | 40 | 969 mm2: 24.89 x 38.94(TO-3)
TI | LM340 (http://www.ti.com/product/LM340) | 35 | 5, 12, 15 | 1.5 | 50 | 40 | 155 mm2: 15.24 x 10.16(DDPAK/TO-263), 46 mm2: 7 x 6.5(SOT-223), See datasheet (TO-220)
TI | LP38869 (http://www.ti.com/product/LP38869) | 5.5 | 2.5 | 1 | 50 | 50 | 22 mm2: 4.4 x 5(HTSSOP)
TI | TLV1171 (http://www.ti.com/product/TLV1171) | 5.5 | 1.2, 1.5, 1.8, 2.5 | 1 | 50 | 60 | 46 mm2: 7 x 6.5(SOT-223)
TI | TLV1117LV (http://www.ti.com/product/TLV1117LV) | 5.5 | 1.2, 1.5, 1.8, 2.5, 2.8, 3, 3.3 | 1 | 50 | 60 | 46 mm2: 7 x 6.5(SOT-223)
TI | LP38691 (http://www.ti.com/product/LP38691) | 10 | 1.8, 2.5, 3.3, 5 | 0.5 | 50 | 80 | 65 mm2: 9.91 x 6.58(TO-252), See datasheet (WSON)
TI | LP38693 (http://www.ti.com/product/LP38693) | 10 | 1.8, 2.5, 3.3, 5 | 0.5 | 50 | 80 | 45 mm2: 6.96 x 6.5(SOT-223), See datasheet (WSON)
TI | LP38693-Q1 (http://www.ti.com/product/LP38693-Q1) | 10 | 1.8, 2.5, 3.3, 5 | 0.5 | 50 | 80 | See datasheet (WSON)
TI | LP38691-Q1 (http://www.ti.com/product/LP38691-Q1) | 10 | 1.8, 2.5, 3.3, 5 | 0.5 | 50 | 80 | See datasheet (WSON)
TI | LP38692 (http://www.ti.com/product/LP38692) | 10 | 1.8, 2.5, 3.3, 5 | 1 | 50 | 80 | 45 mm2: 6.96 x 6.5(SOT-223), See datasheet (WSON)
TI | LP38690 (http://www.ti.com/product/LP38690) | 10 | 1.8, 2.5, 3.3, 5 | 1 | 50 | 80 | 65 mm2: 9.91 x 6.58(TO-252), See datasheet (WSON)
TI | LP38851 (http://www.ti.com/product/LP38851) | 5.5 | 1.8 | 0.8 | 50 | 90 | 154 mm2: 15.24 x 10.1(DDPAK/TO-263), 29 mm2: 6 x 4.9(SO PowerPAD), See datasheet (TO-220)
Onsemi | 0 | 6 | 1.3 1.5 1.8 2.2 2.5 2.7 2.8 3 3.1 3.3 5 | 0.08 | 50 | 180 | SC-88A
TI | LM2940QML-SP (http://www.ti.com/product/LM2940QML-SP) | 26 | 5 | 1 | 50 | 350 | See datasheet (CFP)
TI | TPS79718-EP (http://www.ti.com/product/TPS79718-EP) | 5.5 | 1.8 | 0.01 | 50 | 600 | 4 mm2: 2.1 x 2(SC70)
TI | TPS79730-EP (http://www.ti.com/product/TPS79730-EP) | 5.5 | 3 | 0.01 | 50 | 600 | 4 mm2: 2.1 x 2(SC70)
Onsemi | 0 | 16 | 3.3 8 8 to 12(Adj) 8 to 9(Adj) | 0.2 0.3 1.3 | 50 |  | HZIP-15J
Onsemi | 0 | 16 | 5 8 8 to 12(Adj) 8 to 9(Adj) | 0.2 0.3 1.3 | 50 |  | HZIP-15J
Onsemi | 0 | 16 |  |  | 50 |  | HZIP-15J
Onsemi | 0 | 16 | 5.7 7 8 to 12(Adj) 8 to 9(Adj) | 0.3 1.3 | 50 |  | HZIP-15J
Onsemi | 0 | 16 | 3.3/5 5/3.3 8.5 12 | 0.3 0.5 | 50 |  | HZIP-15
Onsemi | 0 | 16 | 3.3 5/3.3 5/8 8.5 | 0.3 0.4 0.5 1.1 | 50 |  | HZIP-15
Onsemi | 0 | 16 | 3.3 5 to 12(Adj) 6 | 0.3 0.35 1.5 | 50 |  | HZIP-15
Onsemi | 0 | 16 | 3.3 5 to 12(Adj) 5/8 | 0.25 0.45 1.3 | 50 |  | HZIP-15
Onsemi | 0 | 16 | 3.3 5 to 12(Adj) 5 to 9(Adj) 5/8 | 0.25 0.3 0.35 0.45 1.3 | 50 |  | HZIP-15J
Onsemi | 0 | 16 | 3.3 5 to 12(Adj) 5 to 9(Adj) 5/8 | 0.25 0.3 0.45 | 50 |  | HZIP-15
Onsemi | 0 | 16 | 3.3 3.3/5 5/6/7/8 5/8.5/9/12 8/9/10.5/12 | 0.3 0.4 1.5 | 50 |  | HZIP-15
Onsemi | 0 | 16 | 3.3 3.3/5 5/6/7/8 5/8.5/9/11.5 5/8/10.5/12 | 0.25 0.3 0.35 0.45 1.3 | 50 |  | HZIP-15
Onsemi | 0 | 16 | 5 9 9.85 | 0.3 0.5 | 50 |  | HZIP-15
Onsemi | 0 | 16 | 3.3 8 8.4 Adjustable | 0.3 0.5 1.3 Controller | 50 |  | HZIP-15J
Onsemi | 0 | 16 | 3.3 5.7 8 8.4 Adjustable | 0.3 0.5 1.3 controller | 50 |  | HZIP-15J
Onsemi | 0 | 16 | 3.3/5 5 7.6/8.1 8.45 9 | 0.3 0.5 0.8 | 50 |  | HZIP-15J
Onsemi | 0 | 16 | 3.3/5 5 8 8.45 8.5 | 0.3 0.5 0.8 2 | 50 |  | HZIP-15J
Onsemi | 0 | 16 | 3 to 8(Adj) 3.3 3.3/5 5 8 8.5 | 0.2 0.3 0.8 1 | 50 |  | HZIP-15J
Onsemi | 0 | 13 | 9.75 | 0.005 | 50 |  | TSOP-6
ST Micro | LD3985 (http://www.st.com/content/st_com/en/products/power-management/linear-voltage-regulators/low-dropout-ldo-linear-regulators/high-psrr-ldo-regulators/ld3985.html) | 6 | 1.22,1.8,2.5,2.7,2.8,2.9,3,3.3,4.7 | 0.15 | 50 |  | SOT23-5L
TI | TPS7B68-Q1 (http://www.ti.com/product/TPS7B68-Q1) | 40 | 3.3, 5 | 0.5 | 50 |  | 62 mm2: 6.4 x 9.7(HTSSOP)
TI | TPS7A6650H-Q1 (http://www.ti.com/product/TPS7A6650H-Q1) | 40 | 5 | 0.05 | 50 |  | 15 mm2: 4.9 x 3(MSOP-PowerPAD)
TI | LM2940QML (http://www.ti.com/product/LM2940QML) | 26 | 5 | 1 | 50 |  | See datasheet (CFP)
TI | TLV70012-Q1 (http://www.ti.com/product/TLV70012-Q1) | 5.5 | 1.2 | 0.3 | 51 | 48 | 8 mm2: 2.8 x 2.9(SOT-23-THIN)
TI | TLV700 (http://www.ti.com/product/TLV700) | 5.5 | 1.2, 1.3, 1.5, 1.8, 1.9, 2.2, 2.5, 2.8, 2.9, 3, 3.1, 3.2, 3.3, 3.6 | 0.2 | 51 | 48 | 4 mm2: 2.1 x 2(SC70), 8 mm2: 2.8 x 2.9(SOT-23-THIN), See datasheet (WSON)
TI | TLV702 (http://www.ti.com/product/TLV702) | 5.5 | 1.2, 1.5, 1.8, 2.5, 2.8, 2.9, 3, 3.1, 3.3, 3.5, 3.6, 3.7, 4.3, 4.5, 4.75 | 0.3 | 51 | 48 | 8 mm2: 2.8 x 2.9(SOT-23), See datasheet (WSON)
TI | TLV700-Q1 (http://www.ti.com/product/TLV700-Q1) | 5.5 | 1.2, 2.5, 2.8, 3.0, 3.2, 3.3 | 0.2 | 51 | 48 | 4 mm2: 2.1 x 2(SC70), 8 mm2: 2.8 x 2.9(SOT-23-THIN)
TI | TLV702P (http://www.ti.com/product/TLV702P) | 5.5 | 1.5, 2, 2.8, 3.3, 4.2 | 0.3 | 51 | 48 | 8 mm2: 2.8 x 2.9(SOT-23), See datasheet (WSON)
TI | TLV70018-Q1 (http://www.ti.com/product/TLV70018-Q1) | 5.5 | 1.8 | 0.3 | 51 | 48 | 8 mm2: 2.8 x 2.9(SOT-23-THIN)
TI | TLV705P (http://www.ti.com/product/TLV705P) | 5.5 | 1.8, 2.5, 3.3 | 0.2 | 51 | 48 | See datasheet (DSBGA)
TI | TLV702-Q1 (http://www.ti.com/product/TLV702-Q1) | 5.5 | 2.5, 2.8 | 0.3 | 51 | 48 | 8 mm2: 2.8 x 2.9(SOT-23-THIN), See datasheet (WSON)
TI | TLV700XX-Q1 (http://www.ti.com/product/TLV700XX-Q1) | 5.5 | 2.8, 3.2 | 0.2 | 51 | 48 | 8 mm2: 2.8 x 2.9(SOT-23-THIN)
TI | LP2950-N (http://www.ti.com/product/LP2950-N) | 30 | 3, 3.3, 5 | 0.1 | 51 | 100 | 65 mm2: 9.91 x 6.58(TO-252), 18 mm2: 4.3 x 4.3(TO-92)
TI | LP2951-N (http://www.ti.com/product/LP2951-N) | 30 | 3, 3.3, 5 | 0.1 | 51 | 160 | See datasheet (PDIP), 29 mm2: 6 x 4.9(SOIC), 15 mm2: 4.9 x 3(VSSOP), See datasheet (WSON)
TI | LP2951JAN (http://www.ti.com/product/LP2951JAN) | 30 | 3, 3.3, 5 | 0.1 | 51 | 250 | See datasheet (CDIP)
TI | TPS74201 (http://www.ti.com/product/TPS74201) | 5.5 | 3.5 | 1.5 | 52 | 13 | 154 mm2: 15.24 x 10.1(DDPAK/TO-263), 12 mm2: 3.5 x 3.5(VQFN), 25 mm2: 5 x 5(VQFN)
TI | TLV705 (http://www.ti.com/product/TLV705) | 5.5 | 1.2, 1.5, 1.8, 1.85, 2.5, 2.8, 2.85, 3, 3.3, 3.4, 3.6 | 0.2 | 52 | 26 | See datasheet (DSBGA), 1 mm2: .77 x .77(DSLGA)
TI | TLV703 (http://www.ti.com/product/TLV703) | 5.5 | 1, 1.1, 1.2, 1.5, 1.8, 2.5, 2.7, 2.8, 2.9, 3.3 | 0.3 | 52 | 48 | 8 mm2: 2.8 x 2.9(SOT-23)
Onsemi | 0 | 13 | Adjustable | 0.3 | 52 |  | TDFN-8
Onsemi | 0 | 13 | Adjustable | 0.5 | 52 |  | TDFN-8
TI | LM2931-N (http://www.ti.com/product/LM2931-N) | 26 | 5 | 0.1 | 53 | 120 | 155 mm2: 15.24 x 10.16(DDPAK/TO-263), 155 mm2: 15.24 x 10.16(DDPAK/TO-263), 29 mm2: 6 x 4.9(SOIC), See datasheet (TO-220), 18 mm2: 4.3 x 4.3(TO-92)
Onsemi | 0 | 24 | 3 3.3 5 | 0.15 | 53 55 | 80 115 | TSOP-5 / SOT-23-5
Onsemi | 0 | 150 | 3.3 5 15 1.25 - 15 | 0.1 | 53 65 75 | 130 260 300 530 | DFN-6
TI | TPS7A49 (http://www.ti.com/product/TPS7A49) | 36 | 33 | 0.15 | 54 | 15 | 15 mm2: 4.9 x 3(MSOP-PowerPAD), See datasheet (SON)
TI | LM2940C (http://www.ti.com/product/LM2940C) | 26 | 5, 9, 12, 15 | 1 | 54 | 150 | 155 mm2: 15.24 x 10.16(DDPAK/TO-263), See datasheet (TO-220)
TI | LP2951-Q1 (http://www.ti.com/product/LP2951-Q1) | 30 | 3.3, 5 | 0.1 | 54 | 430 | 29 mm2: 6 x 4.9(SOIC), See datasheet (SON)
Onsemi | 0 | 45 | 5 | 0.35 | 54 |  | D<sup>2</sup>PAK-5 DPAK-5
Onsemi | 0 | 45 | 3.3 5 | 0.35 | 54 |  | DPAK-3
Onsemi | 0 | 24 | 1.5 1.8 2.5 2.8 3 3.3 5 | 0.08 | 54 56 58 60 | 120 140 160 180 190 200 220 | WDFN-6
Onsemi | 0 | 20 | 1.5 1.8 2 2.5 2.85 3.3 5 12 Adjustable | 1 | 54 61 64 68 70 72 73 | 45 54 60 75 85.5 99 150 360 | DPAK-3 SOT-223-4 / TO-261-4
Onsemi | 0 | 20 | 1.5 1.8 2 2.5 3.3 5 12 Adjustable | 1 | 54 61 64 68 70 72 73 | 45 54 60 75 99 150 360 | DPAK-3 SOT-223-4 / TO-261-4
TI | TPS7A30 (http://www.ti.com/product/TPS7A30) | -3 | -1.2 | 0.2 | 55 | 15 | 15 mm2: 4.9 x 3(MSOP-PowerPAD), See datasheet (SON)
TI | TPS7A3001-EP (http://www.ti.com/product/TPS7A3001-EP) | -3 | -1.2 | 0.2 | 55 | 15 | 15 mm2: 4.9 x 3(MSOP-PowerPAD)
Onsemi | 0 | 5.5 | 1.8 2.8 3 3.3 | 0.15 | 55 | 17 | XDFN-4
Onsemi | 0 | 12 | 1.5 1.8 2.5 2.8 2.85 3 3.3 5 Adjustable | 0.5 | 55 | 31 | DFN-10 Micro8™
Onsemi | 0 | 12 | Adjustable | 0.5 | 55 | 38 | SOIC-8
TI | LM323-N (http://www.ti.com/product/LM323-N) | 20 | 5 | 3 | 55 | 40 | 969 mm2: 24.89 x 38.94(TO-3)
TI | TPS720 (http://www.ti.com/product/TPS720) | 4.5 | 0.9, 1, 1.05, 1.1, 1.15, 1.2, 1.3, 1.5, 1.7, 1.8 | 0.35 | 55 | 48 | See datasheet (DSBGA), See datasheet (WSON)
TI | TPS720-Q1 (http://www.ti.com/product/TPS720-Q1) | 4.5 | 0.9, 1, 1.1, 1.2, 1.5, 1.8, 2.5, 2.8, 2.85, 2.9, 3 | 0.35 | 55 | 48 | See datasheet (WSON)
Onsemi | 0 | 6 | 1.3 1.5 1.8 2.5 2.8 3 3.3 3.5 5 Adjustable | 0.15 | 55 | 50 | DFN-6 TSOP-5 / SOT-23-5
Onsemi | 0 | 6.5 | 1.3 1.5 1.8 2.5 2.8 3 3.3 3.5 5 Adjustable | 0.3 | 55 | 50 | TSOP-5 / SOT-23-5
Onsemi | 0 | 6 | 1.3 1.5 1.8 2.5 2.8 3 3.3 3.5 5 Adjustable | 0.15 | 55 | 50 | DFN-6 TSOP-5 / SOT-23-5
Onsemi | 0 | 6.5 | 3.3 | 0.3 | 55 | 50 | TSOP-5 / SOT-23-5
Onsemi | 0 | 6 | 0.8 1.5 2.8 3.3 Adjustable | 3 | 55 | 60 | DPAK-5
Onsemi | 0 | 12 | 1.5 1.8 2.5 2.7 2.8 2.9 3 3.1 3.3 3.4 3.5 3.6 3.7 5 | 0.08 | 55 | 180 | SC-88A TSOP-5 / SOT-23-5
Onsemi | 0 | 20 | 3.3 3.5 5 12 Adjustable | 0.8 | 55 |  | DPAK-3 SOIC-8 SOT-223-4 / TO-261-4 TO-220-3
Onsemi | 0 | 45 | 5 8 Adjustable | 0.15 | 55 |  | SOIC-16W EP SOIC-8
Onsemi | 0 | 45 | 5 | 0.25 | 55 |  | D<sup>2</sup>PAK-7 SOIC-8 EP
Onsemi | 0 | 12 | 1.5 1.8 1.9 2.5 2.8 2.85 3 3.3 3.5 5 Adjustable | 0.5 | 55 | 26 31 33 35 36 37 40 46 47 58 | DFN-10
TI | TPS7B63-Q1 (http://www.ti.com/product/TPS7B63-Q1) | 40 | 3.3, 5 | 0.3 | 55 |  | 22 mm2: 4.4 x 5(HTSSOP)
Onsemi | 0 | -40 | -24 | 1 | 56 | 170 | D<sup>2</sup>PAK-3 TO-220-3
Onsemi | 0 | 24 | 1.2 1.5 1.8 2.1 2.5 3 3.3 5 | 0.05 | 56 60 | 65 75 95 105 115 135 140 190 | SC-88A XDFN-6
Onsemi | 0 | 24 | 1.2 1.5 1.8 2.5 3 3.3 5 5.3 | 0.05 | 56 60 | 65 75 95 115 135 140 190 199 | SC-88A XDFN-6
TI | TPS7A8001 (http://www.ti.com/product/TPS7A8001) | 6.5 | 6 | 1 | 57 | 50 | See datasheet (SON)
Onsemi | 0 | 30 | 8 | 0.1 | 57 | 60 | SOIC-8 SOT-89-3 TO-92 TO-92-3
Onsemi | 0 | 30 | 9 | 0.1 | 57 | 60 | SOIC-8 TO-92
TI | LM2937-2.5 (http://www.ti.com/product/LM2937-2.5) | 26 | 2.5 | 0.5 | 57 | 75 | 155 mm2: 15.24 x 10.16(DDPAK/TO-263), 46 mm2: 7 x 6.5(SOT-223), See datasheet (TO-220)
TI | LM2937-3.3 (http://www.ti.com/product/LM2937-3.3) | 26 | 3.3 | 0.5 | 57 | 99 | 155 mm2: 15.24 x 10.16(DDPAK/TO-263), 46 mm2: 7 x 6.5(SOT-223), See datasheet (TO-220)
TI | LP2950 (http://www.ti.com/product/LP2950) | 30 | 3, 3.3, 5 | 0.1 | 57 | 100 | 18 mm2: 4.3 x 4.3(TO-92)
TI | LM2937 (http://www.ti.com/product/LM2937) | 26 | 5, 8, 10, 12, 15 | 0.5 | 57 | 150 | 155 mm2: 15.24 x 10.16(DDPAK/TO-263), 46 mm2: 7 x 6.5(SOT-223), See datasheet (TO-220)
TI | LP2951 (http://www.ti.com/product/LP2951) | 30 | 3, 3.3, 5 | 0.1 | 57 | 160 | 29 mm2: 6 x 4.9(SOIC), See datasheet (SON)
Onsemi | 0 | 5.5 | 2.95 3 | 1 | 58 | 300 | XDFN-8
Onsemi | 0 | 5.5 | 2.1 2.2 2.95 3 | 1 | 58 60 | 280 300 | XDFN-8
TI | TPS71H01 (http://www.ti.com/product/TPS71H01) | 10 | 9.75 | 0.5 | 59 | 74 | 42 mm2: 6.4 x 6.5(HTSSOP)
Onsemi | 0 | -35 | -18 | 1 | 59 | 110 | TO-220-3
TI | TPS7A47-Q1 (http://www.ti.com/product/TPS7A47-Q1) | 36 | 34 | 1 | 60 | 4 | 25 mm2: 5 x 5(VQFN)
TI | TPS7A47 (http://www.ti.com/product/TPS7A47) | 36 | 34 | 1 | 60 | 4 | 25 mm2: 5 x 5(VQFN)
TI | LP5907 (http://www.ti.com/product/LP5907) | 5.5 | 1.2, 1.5, 1.8, 1.9, 2.2, 2.5, 2.7, 2.75, 2.8, 2.85, 2.9, 3, 3.1, 3.2, 3.3, 3.7, 4, 4.5 | 0.25 | 60 | 6.5 | See datasheet (DSBGA), 8 mm2: 2.8 x 2.9(SOT-23), 1 mm2: 1 x 1(X2SON)
TI | LP5907-Q1 (http://www.ti.com/product/LP5907-Q1) | 5.5 | 1.2, 1.8, 2.5, 2.8, 3, 3.3, 3.8, 4.5 | 0.25 | 60 | 6.5 | 8 mm2: 2.8 x 2.9(SOT-23)
TI | TPS7A8101-Q1 (http://www.ti.com/product/TPS7A8101-Q1) | 6.5 | 6 | 1 | 60 | 23 | See datasheet (SON)
TI | TPS7A8101 (http://www.ti.com/product/TPS7A8101) | 6.5 | 6 | 1 | 60 | 23 | See datasheet (SON)
Onsemi | 0 | -35 | -15 | 1 | 60 | 90 | D<sup>2</sup>PAK-3 TO-220-3
Onsemi | 0 | 18 | 3.3, Adj. | 0.25 | 60 | 90 | DPAK-5
Onsemi | 0 | 18 | 3.3, 1.25 | 0.25 | 60 | 90 | DPAK-5
TI | TPS71501-EP (http://www.ti.com/product/TPS71501-EP) | 24 | 15 | 0.05 | 60 | 575 | 4 mm2: 2.1 x 2(SC70)
Onsemi | 0 | 26 | Tracking | 0.2 | 60 |  | D<sup>2</sup>PAK-5 DPAK-5 SOIC-8
Onsemi | 0 | 18 | 1.5 2.5 3.3 5 Adjustable | 1 | 60 |  | SOT-223-4 / TO-261-4
Onsemi | 0 | 45 | 3.3 | 0.4 | 60 |  | SOT-223-4 / TO-261-4
Onsemi | 0 | 45 | 3.3 5 | 0.4 | 60 |  | D<sup>2</sup>PAK-3 DPAK-3 SOT-223-4 / TO-261-4
Onsemi | 0 | 45 | 3.3 5 | 0.45 | 60 |  | D<sup>2</sup>PAK-5 DPAK-5
Onsemi | 0 | 45 | 5 | 0.45 | 60 |  | D<sup>2</sup>PAK-5 DPAK-5
Onsemi | 0 | 26 | Tracking | 0.07 | 60 |  | DPAK-5 SOIC-8 SOIC-8 EP
Onsemi | 0 | 40 | 5, 3.3, Adjustable | 0.1 | 60 |  | DFN-20
Onsemi | 0 | 40 | 3.3 5 | 0.15 | 60 |  | DPAK-5 SOIC-8
Onsemi | 0 | 40 | 5 | 0.15 | 60 |  | SOIC-14 SOIC-8
Onsemi | 0 | 40 | 3.3 5 | 0.15 | 60 |  | SOIC-8 SOIC-8 EP
Onsemi | 0 | 40 | 5 | 0.15 | 60 |  | SOIC-14
Onsemi | 0 | 40 | 5 | 0.15 | 60 |  | SOIC-14
Onsemi | 0 | 40 | 5 | 0.15 | 60 |  | SOIC-14
Onsemi | 0 | 45 | 3.3 5 | 0.35 | 60 |  | D<sup>2</sup>PAK-5 DPAK-5
Onsemi | 0 |  | 5, 8.5 | 1.5 | 60 |  | SOIC-16W EP
Onsemi | 0 | 24 | 1.2 1.5 1.8 2.5 3 3.3 5 | 0.08 | 60 | 100 120 140 160 170 180 | WDFN-6
Onsemi | 0 | 24 | 1.2 1.5 1.8 1.8<sup></sup> 2.5 3 3.3 1.2-5.0 ADJ | 0.3 | 60 | 36 45 48 75 90 99 | TSOT-23-5 WDFN-6
ST Micro | LD39200 (http://www.st.com/content/st_com/en/products/power-management/linear-voltage-regulators/low-dropout-ldo-linear-regulators/ld39200.html) | 6 | 3.3 | 2 | 60 |  | DFN6 3x3,DFN8 4x4
TI | TPS7B69-Q1 (http://www.ti.com/product/TPS7B69-Q1) | 40 | 2.5, 3.3, 5 | 0.15 | 60 |  | 46 mm2: 7 x 6.5(SOT-223), 8 mm2: 2.8 x 2.9(SOT-23)
TI | TPS7B69 (http://www.ti.com/product/TPS7B69) | 40 | 3.3, 5 | 0.15 | 60 |  | 8 mm2: 2.8 x 2.9(SOT-23)
TI | TPS7B67-Q1 (http://www.ti.com/product/TPS7B67-Q1) | 40 | 3.3, 5 | 0.45 | 60 |  | 42 mm2: 6.4 x 6.5(HTSSOP)
TI | TPS7B7701-Q1 (http://www.ti.com/product/TPS7B7701-Q1) | 40 | 20 | 0.3 | 60 |  | 22 mm2: 4.4 x 5(HTSSOP)
TI | TPS7B4253-Q1 (http://www.ti.com/product/TPS7B4253-Q1) | 40 | 40 | 0.3 | 60 |  | 42 mm2: 6.4 x 6.5(HTSSOP), 29 mm2: 6 x 4.9(SO PowerPAD)
TI | TPS7B4250-Q1 (http://www.ti.com/product/TPS7B4250-Q1) | 40 | 18 | 0.05 | 60 |  | 8 mm2: 2.8 x 2.9(SOT-23)
Onsemi | 0 | -35 | -12 1.3 | 1 | 61 | 75 | D<sup>2</sup>PAK-3 TO-220-3
Onsemi | 0 | 6 | 1.5 1.8 2.5 2.8 3 3.3 5 Adjustable | 0.5 | 62 | 50 | DFN-6
Onsemi | 0 | 6 | 1.25 1.5 1.8 2.5 5 | 1 | 62 | 50 | DFN-6
Onsemi | 0 | 6 | 1.25 1.5 1.8 2.5 3.3 5 | 1 | 62 | 50 | DFN-6
Onsemi | 0 | 6 | 1.25 1.5 1.8 2.5 3.3 5 | 1 | 62 | 50 | DFN-6
Onsemi | 0 | 6 | 1.5 1.8 2.5 2.8 3 3.3 5 Adjustable | 0.5 | 62 | 50 | DFN-6
Onsemi | 0 | -35 | -8 | 1 | 62 | 52 | D<sup>2</sup>PAK-3 TO-220-3
Onsemi | 0 | 6 | 1.8 1.85 2.5 2.6 2.7 2.8 3 3.3 5 | 0.15 | 62 |  | DFN-6 TSOP-5 / SOT-23-5
ST Micro | LD39015 (http://www.st.com/content/st_com/en/products/power-management/linear-voltage-regulators/low-dropout-ldo-linear-regulators/low-iq-ldo-regulators/ld39015.html) | 5.5 | 0.8,1,1.2,1.25,1.5,1.8,2.5,3.3 | 0.15 | 62 |  | SOT23-5L
ST Micro | LD39030SJ (http://www.st.com/content/st_com/en/products/power-management/linear-voltage-regulators/low-dropout-ldo-linear-regulators/low-iq-ldo-regulators/ld39030sj.html) | 5.5 | 1,1.2,1.5,1.8,2.5,2.8,3.3 | 0.3 | 62 |  | Flip-Chip 4
ST Micro | LD39050 (http://www.st.com/content/st_com/en/products/power-management/linear-voltage-regulators/low-dropout-ldo-linear-regulators/low-iq-ldo-regulators/ld39050.html) | 5.5 | 1,2.5,3.3 | 0.5 | 62 |  | DFN6 2x2,DFN6 3x3
ST Micro | LD39100 (http://www.st.com/content/st_com/en/products/power-management/linear-voltage-regulators/low-dropout-ldo-linear-regulators/low-iq-ldo-regulators/ld39100.html) | 5.5 | 1.2,1.8,2.5,3,3.3 | 1 | 62 |  | DFN6 3x3,VFDFPN 6L 3X3X0.95 P0.95 EP SIDE
Onsemi | 0 | 6 | Adjustable | 1 | 63 | 15 | DFN-8
TI | LM317L-N (http://www.ti.com/product/LM317L-N) | 40 | 38 | 0.1 | 63 | 38 | See datasheet (DSBGA), 29 mm2: 6 x 4.9(SOIC), 18 mm2: 4.3 x 4.3(TO-92)
Onsemi | 0 | 5.5 | Adjustable | 1 | 63 | 15*Vout | DFN-8
TI | TPS7A33 (http://www.ti.com/product/TPS7A33) | -3 | -1.2 | 1 | 64 | 16 | See datasheet (TO-220), 25 mm2: 5 x 5(VQFN)
TI | LM109 (http://www.ti.com/product/LM109) | 35 | 5 | 1 | 64 | 40 | 92 mm2: 9.14 x 10.03(TO), 969 mm2: 24.89 x 38.94(TO-3)
TI | LM309 (http://www.ti.com/product/LM309) | 35 | 5 | 3 | 64 | 40 | 92 mm2: 9.14 x 10.03(TO), 969 mm2: 24.89 x 38.94(TO-3)
Onsemi | 0 | 5.5 | 2.5 | 0.3 | 64 | 45 | TSOT-23-5
Onsemi | 0 | 5.5 | 3.3 Adjustable | 0.5 | 64 | 45 | TSOT-23-5
Onsemi | 0 | 18 | 1.8 2.5 2.8 3 3.3 5 Adjustable | 1.5 | 64 |  | D<sup>2</sup>PAK-5 DFN-8
TI | LP38798 (http://www.ti.com/product/LP38798) | 20 | 19.8 | 0.8 | 65 | 5 | See datasheet (WSON)
Onsemi | 0 | 9 | 1.2 1.5 1.8 2.5 2.8 3 3.3 Adjustable | 1 | 65 | 26 | DFN-6 DPAK-5
Onsemi | 0 | 9 | 1.2 1.5 1.8 2.5 2.8 3 3.3 Adjustable | 2 | 65 | 26 | D<sup>2</sup>PAK-5 DFN-8
Onsemi | 0 | 9 | 1.5 1.8 Adjustable | 3 | 65 | 28 | D<sup>2</sup>PAK-5
Onsemi | 0 | 17 | 5 | 0.5 | 65 | 40 | IPAK / TP3H
Onsemi | 0 | -35 | -6 | 1 | 65 | 45 | D<sup>2</sup>PAK-3 TO-220-3
Onsemi | 0 | 6 | 1.2 1.8 1.85 2.8 2.85 3.1 3.3 | 0.3 | 65 | 65 | SC-88A UDFN-4
Onsemi | 0 | 5.5 | 3 | 1 | 65 | 300 | XDFN-8
Onsemi | 0 | 5.5 | 3 | 1 | 65 | 300 | XDFN-8
Onsemi | 0 | 40 | 5 | 0.1 | 65 |  | SOIC-16W
Onsemi | 0 | 18 | Adjustable | 1.5 | 65 |  | D<sup>2</sup>PAK-5 DFN-8
Onsemi | 0 | -35 | -5 | 0.5 | 66 | 40 | DPAK-3 TO-220-3
Onsemi | 0 | -35 | -8 | 0.5 | 66 | 40 | DPAK-3 TO-220-3
Onsemi | 0 | -35 | -12 | 0.5 | 66 | 40 | DPAK-3 TO-220-3
Onsemi | 0 | -35 | -15 | 0.5 | 66 | 40 | DPAK-3 TO-220-3
Onsemi | 0 | 45 | 5 | 0.15 | 66 |  | TSSOP-14 EP
Onsemi | 0 | 45 | 3.3 5 | 0.15 | 66 |  | SOIC-14 SOIC-8
TI | TPS717-Q1 (http://www.ti.com/product/TPS717-Q1) | 6.5 | 0.9, 1.2, 1.5, 1.8, 2.5, 2.8, 3, 3.3, 4.5, 5 | 0.15 | 67 | 20.7 | 4 mm2: 2.1 x 2(SC70), See datasheet (WSON)
TI | TPS717 (http://www.ti.com/product/TPS717) | 6.5 | 0.9, 1, 1.1, 1.2, 1.3, 1.5, 1.8, 1.85, 1.9, 2.1, 2.5, 2.6, 2.7, 2.8, 2.85, 2.9, 3, 3.3, 4.5, 5 | 0.15 | 67 | 30 | 4 mm2: 2.1 x 2(SC70), See datasheet (WSON)
TI | LM2941C (http://www.ti.com/product/LM2941C) | 26 | 20 | 1 | 67 | 38 | 155 mm2: 15.24 x 10.16(DDPAK/TO-263), See datasheet (TO-220)
Onsemi | 0 | 5.5 | 0.8, 1.2, 2.5, 3.3, 5.5 | 1 | 67 | 45 | DPAK-5 WDFN-6
TI | LM2941 (http://www.ti.com/product/LM2941) | 26 | 20 | 1 | 67 | 600 | 155 mm2: 15.24 x 10.16(DDPAK/TO-263), See datasheet (TO-220), See datasheet (WSON)
Onsemi | 0 | 45 | 5 | 0.1 | 67 |  | SOIC-8
Onsemi | 0 | 45 | 3.3 | 0.1 | 67 |  | SOIC-8
Onsemi | 0 | 45 | 3.3 5 | 0.1 | 67 |  | SOT-223-4 / TO-261-4
Onsemi | 0 | 45 | 5 | 0.15 | 67 |  | SOIC-8
Onsemi | 0 | 45 | 3.3 5 | 0.15 | 67 |  | DPAK-3 SOT-223-4 / TO-261-4
Onsemi | 0 | 45 | 5 12 | 0.35 | 67 |  | D<sup>2</sup>PAK-3
ST Micro | LD39020 (http://www.st.com/content/st_com/en/products/power-management/linear-voltage-regulators/low-dropout-ldo-linear-regulators/high-psrr-ldo-regulators/ld39020.html) | 5.5 | 0.8,1,1.1,1.2,1.3,1.5,1.8,1.85,2,2.1,2.5,2.7,2.8,2.9,3,3.1,3.2,3.3,3.6,4,4.7,5 | 0.2 | 67 |  | DFN4 1x1,SOT23-5L
ST Micro | LD39115J (http://www.st.com/content/st_com/en/products/power-management/linear-voltage-regulators/low-dropout-ldo-linear-regulators/low-iq-ldo-regulators/ld39115j.html) | 5.5 | 1.2,1.4,1.5,1.8,2.5,2.8,3,3.3 | 0.15 | 67 |  | Flip-Chip 4
TI | LM2941QML-SP (http://www.ti.com/product/LM2941QML-SP) | 26 | 20 | 1 | 67 |  | See datasheet (CFP)
TI | LM2941QML (http://www.ti.com/product/LM2941QML) | 26 | 20 | 1 | 67 |  | See datasheet (CFP)
Onsemi | 0 | 35 | 5 | 1 | 68 | 10 | D<sup>2</sup>PAK-3 DPAK-3 TO-220-3
Onsemi | 0 | 5.5 | 1.8 2.5 2.8 3 3.3 | 0.2 | 68 | 11 | TSOP-5 / SOT-23-5 XDFN-6
Onsemi | 0 | 6 | 1.8 2.8 3 3.3 | 0.2 | 68 | 11.5 | TSOP-5 / SOT-23-5 XDFN-6
Onsemi | 0 | 5.5 | 1.8 2.8 3 3.3 | 0.2 | 68 | 11.5 | TSOP-5 / SOT-23-5 XDFN-6
Onsemi | 0 | 5.5 | 1.8 1.9 2.8 3 3.3 3.5 | 0.3 | 68 | 13 | TSOP-5 / SOT-23-5 XDFN-6
Onsemi | 0 | 5.5 | 1.8 2.8 3 3.3 | 0.3 | 68 | 13 | TSOP-5 / SOT-23-5 XDFN-6
Onsemi | 0 | 45 | 3.3 5 | 0.15 | 68 |  | SOT-223-4 / TO-261-4
Onsemi | 0 | 6 | Adjustable | 0.3 | 69 | 60 | Micro8™
Onsemi | 0 | 45 | 5 | 0.15 | 69 |  | SOIC-8
TI | LP3962 (http://www.ti.com/product/LP3962) | 7 | 1.8, 2.5, 3.3, 5 | 1.5 | 7 | 150 | 155 mm2: 15.24 x 10.16(DDPAK/TO-263), 45 mm2: 6.96 x 6.5(SOT-223), See datasheet (TO-220)
Onsemi | 0 | 5.5 | 1.8 2.8 3 3.1 3.3 | 0.2 | 70 | 11 | TSOP-5 / SOT-23-5 XDFN-6
Onsemi | 0 | 30 | 3.3 | 0.02 | 70 | 18 | SOT-23-3
Onsemi | 0 | 5.5 | 1.8 3 3.3 | 0.2 | 70 | 22 | XDFN-4
Onsemi | 0 | 5.5 | 2.85 3.3 | 0.3 | 70 | 22 | XDFN-4
Onsemi | 0 | 12 | 2.5 2.8 3 3.3 4 5 | 0.15 | 70 | 25 | DFN-6
Onsemi | 0 | 12 | 2.5 2.8 3 3.3 4 5 | 0.15 | 70 | 25 | DFN-6
Onsemi | 0 | 9 | 1.8 | 0.15 | 70 | 30 | SOT-23-5
Onsemi | 0 | 9 | 2.5 | 0.15 | 70 | 30 | SOT-23-5
Onsemi | 0 | 9 | 2.8 | 0.15 | 70 | 30 | SOT-23-5
Onsemi | 0 | 9 | 3 | 0.15 | 70 | 30 | SOT-23-5
Onsemi | 0 | 9 | 3.3 | 0.15 | 70 | 30 | SOT-23-5
Onsemi | 0 | 9 | 5 | 0.15 | 70 | 30 | SOT-23-5
Onsemi | 0 | 6 | 0.8 1 1.2 2.5 3.3 Adjustable | 1 | 70 | 30 | SON-6 / HSON-6 SOT-89-5
Onsemi | 0 | 12 | 2.5 2.8 2.9 3 5 | 0.08 | 70 | 35 | TSOP-5 / SOT-23-5
Onsemi | 0 | 7 12 | 2.5, 2.5 2.8, 2.8 3.0, 3.0 | 0.08 | 70 | 35 | Micro8™
Onsemi | 0 | 13 | 1.5 1.8 2.5 2.8 3 3.3 | 0.05 | 70 | 39 | SC-88A WDFN-6
Onsemi | 0 | -35 | -5 | 1 | 70 | 40 | D<sup>2</sup>PAK-3 TO-220-3
Onsemi | 0 | 5.5 | 1 1.05 1.1 1.15 1.2 1.25 1.3 1.35 1.4 1.45 1.5 1.6 1.7 1.8 | 0.35 | 70 | 40 | WDFN-6
Onsemi | 0 | 5.5 | 1 1.05 1.1 1.15 1.2 1.25 1.3 1.35 1.4 1.45 1.5 1.6 1.7 1.8 | 0.35 | 70 | 40 | WDFN-6
Onsemi | 0 | 7 | 1 3.3 | 1 | 70 | 45 | UDFN-6
Onsemi | 0 | 5.3 | 1 1.5 2.5 | 0.2 | 70 | 80 | SC-88A XDFN-6
Onsemi | 0 | 18 | 1.8, 3.5 | 0.08 | 70 | 80 | SOIC-8
Onsemi | 0 | 10 | 1.2 1.8 2.8 3 3.3 5 | 0.3 | 70 | 85 | SOT-23-5
Onsemi | 0 | 35 | 15 | 0.5 | 70 | 90 | DPAK-3 TO-220-3
Onsemi | 0 | 5.3 | 1.2 1.8 2.5 2.8 3 3.3 | 0.3 | 70 | 90 | SOT-23-5 XDFN-6
Onsemi | 0 | 12 | 1.2 1.5 1.8 2.5 3 3.3 5 | 0.15 | 70 | 90 | SC-88A SOT-23-5
Onsemi | 0 | 18 | 3 3.3 4.5 5 | 0.3 | 70 | 90 | SOT-23-5 XDFN-6
Onsemi | 0 | 5.5 | 3.3 | 1 | 70 | 100 | UDFN-6
Onsemi | 0 | 40 | Adjustable | 0.35 | 70 | 100 | SOIC-8 SOIC-8 EP
Onsemi | 0 | 40 | Adjustable | 0.35 | 70 | 100 | SOIC-8 SOIC-8 EP
Onsemi | 0 | 40 | Adjustable | 0.35 | 70 | 100 | SOIC-8 SOIC-8 EP
Onsemi | 0 | 40 | Adjustable | 0.35 | 70 | 100 | SOIC-8 SOIC-8 EP
Onsemi | 0 | 40 | 20 | 0.5 | 70 | 110 | TO-220-3
Onsemi | 0 | 6 | 1.2 1.8 2.8 3 3.3 | 0.15 | 70 | 115 | XDFN-6
Onsemi | 0 | 450 | 1.275 | 0.005 | 70 | 146 | SOT-223-4 / TO-261-4
Onsemi | 0 | 40 | 24 | 0.5 | 70 | 170 | TO-220-3
Onsemi | 0 | 60 | 5 | 0.25 | 70 |  | D<sup>2</sup>PAK-7
Onsemi | 0 | 18 | Adjustable | 3 | 70 |  | D<sup>2</sup>PAK-5
Onsemi | 0 | 18 | 1.8 2.5 2.8 3 3.3 5 | 3 | 70 |  | D<sup>2</sup>PAK-5
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
TI | TPS73 (http://www.ti.com/product/TPS73) | 10 | 2.5, 3, 3.3, 4.8, 5 | 0.5 | 8 | 74 | See datasheet (PDIP), 29 mm2: 6 x 4.9(SOIC), 42 mm2: 6.4 x 6.5(TSSOP)
TI | TPS722 (http://www.ti.com/product/TPS722) | 5.5 | 1.5, 1.6, 1.8 | 0.05 | 8 | 90 | 8 mm2: 2.8 x 2.9(SOT-23)
TI | TPS721 (http://www.ti.com/product/TPS721) | 5.5 | 1.5, 1.6, 1.8 | 0.15 | 8 | 90 | 8 mm2: 2.8 x 2.9(SOT-23)
TI | TPS72118-EP (http://www.ti.com/product/TPS72118-EP) | 5.5 | 1.8 | 0.15 | 8 | 90 | 8 mm2: 2.8 x 2.9(SOT-23)
TI | TPS72 (http://www.ti.com/product/TPS72) | 10 | 2.5, 3, 3.3, 4.8, 5 | 0.25 | 8 | 190 | See datasheet (PDIP), 29 mm2: 6 x 4.9(SOIC), 19 mm2: 6.4 x 3(TSSOP)
Onsemi | 0 | 6 | 4.5 | 0.2 | 80 | 10 | WDFN-6
Onsemi | 0 | 5.5 | Adjustable | 3 | 80 | 18 | DFN-10 QFN-20
Onsemi | 0 | 5.5 | Adjustable | 3 | 80 | 18 | QFN-20
Onsemi | 0 | 6.5 | 1.2 1.4 1.8 2.5 2.8 3 3.3 5 | 0.15 | 80 | 30 | SC-82AB-4 SOT-23-5 UDFN-4
Onsemi | 0 | 5.5 | 0.8 0.9 1 1.05 1.1 1.2 1.5 | 0.5 | 80 | 40 | XDFN-4
Onsemi | 0 | 5.5 | 1 1.2 | 0.5 | 80 | 40 | XDFN-4
Onsemi | 0 | 5.5 | 0.8 1 1.1 1.2 1.3 1.5 1.8 | 0.3 | 80 | 40 | XDFN-6
Onsemi | 0 | 5.5 | 0.8 1 1.1 1.2 1.3 1.5 1.8 | 0.5 | 80 | 40 | XDFN-6
Onsemi | 0 | 35 | 5 | 0.5 | 80 | 40 | DPAK-3 TO-220-3
Onsemi | 0 | 5.5 | 0.8 1.05 1.1 1.15 1.2 1.5 1.8 2.1 | 0.15 | 80 | 40 | XDFN-6
Onsemi | 0 | 5.5 | 1.4 1.45 1.6 1.65 1.7 1.73 1.75 1.85 | 0.15 | 80 | 40 | XDFN-6
Onsemi | 0 | 5.5 | 0.8 0.9 1 1.05 1.1 1.15 1.2 1.5 1.8 2.1 | 0.3 | 80 | 40 | XDFN-6
Onsemi | 0 | 35 | 6 | 0.5 | 80 | 45 | DPAK-3 TO-220-3
Onsemi | 0 | 35 | 8 | 0.5 | 80 | 52 | DPAK-3 TO-220-3
Onsemi | 0 | 35 | 9 | 0.5 | 80 | 52 | DPAK-3 TO-220-3
Onsemi | 0 | 6 | 0.6 0.9 1 1.2 1.3 1.5 | 0.4 | 80 | 70 | SOT-23-5
Onsemi | 0 | 35 | 12 | 0.5 | 80 | 75 | DPAK-3 TO-220-3
Onsemi | 0 | 40 | Adjustable | 0.2 | 80 | 168 | TSSOP-14 EP
Onsemi | 0 | 700 | 3.3 5 12 15 | 0.01 | 80 | 250 | SOT-89-3
Onsemi | 0 | 40 | Adjustable | 1.5 | 80 |  | D<sup>2</sup>PAK-3 TO-220-3
Onsemi | 0 | 40 | Adjustable | 0.1 | 80 |  | SOIC-8 TO-92
Onsemi | 0 | 40 | Adjustable | 0.5 | 80 |  | DPAK-3 SOT-223-4 / TO-261-4 TO-220-3
Onsemi | 0 | 40 | Adjustable | 1.5 | 80 |  | TO-220-3
Onsemi | 0 | 45 | 5 | 0.15 | 80 |  | SOIC-14 SOIC-8 EP
Onsemi | 0 |  | 5 |  | 80 |  | SSOP-36 EP
Onsemi | 0 | 5.5 | 0.9 1 1.05 1.1 1.15 1.2 1.25 1.3 1.5 1.8 Adjustable | 0.5 | 80 | 40 50 | XDFN-6
ST Micro | LDBL20 (http://www.st.com/content/st_com/en/products/power-management/linear-voltage-regulators/low-dropout-ldo-linear-regulators/ldbl20.html) | 5.5 | 1.2,1.8,2.5,3.3 | 0.2 | 80 |  | STSTAMP
Onsemi | 0 | 6 | 1.8 2.5 2.8 3 3.3 | 0.2 | 82 | 10 | TSOP-5 / SOT-23-5 WDFN-6
Onsemi | 0 | 6 | 1.8 2.5 2.8 3 3.3 | 0.2 | 82 | 10 | DFN-6 TSOP-5 / SOT-23-5
Onsemi | 0 | 5.5 | 1.8 2.8 2.85 2.95 3 3.3 3.5 | 0.7 | 85 | 8.5 | WLCSP-4 XDFN-4
Onsemi | 0 | 40 | Adjustable | 0.02 | 85 | 23 | SOIC-8
ST Micro | LDLN015 (http://www.st.com/content/st_com/en/products/power-management/linear-voltage-regulators/low-dropout-ldo-linear-regulators/high-psrr-ldo-regulators/ldln015.html) | 5.1 | 1,1.2,1.5,1.8,2.5,2.8,3,3.3 | 0.15 | 89 |  | DFN6 2x2
Onsemi | 0 | 40 | 5 Adjustable | 0.1 | 90 | 700 | D<sup>2</sup>PAK-3 D<sup>2</sup>PAK-5 DPAK-3 SOIC-8 TO-220-3 TO-220-5 TO-92
Onsemi | 0 | 40 | 5 Adjustable | 0.1 | 90 | 700 | D<sup>2</sup>PAK-3 DPAK-3 SOIC-8 SOT-223-4 / TO-261-4 TO-92
Onsemi | 0 | 5.5 | 1.2 1.3 1.8 1.825 1.9 2.5 2.6 2.7 2.75 2.8 2.85 2.9 2.925 3 3.3 5 | 0.25 | 92 | 6.5 | WLCSP-4 XDFN-4
Onsemi | 0 | 5.5 | 1.2 1.8 2.5 2.7 2.8 3 3.3 | 0.25 | 92 | 6.5 | XDFN-4
Onsemi | 0 | 5.5 | 1.8 2.5 2.6 2.7 2.8 | 0.45 | 98 | 10 | WLCSP-4
Onsemi | 0 | 5.5 | 1.8 1.825 2.1 2.5 2.75 2.8 2.85 2.9 2.925 3 3.1 3.2 3.3 3.5 3.7 4.5 5 5.14 | 0.25 | 98 | 10 | WLCSP-4 XDFN-4
Onsemi | 0 | 5.5 | 1.8 1.85 2.5 2.8 2.85 2.9 3 3.1 3.2 3.3 3.5 4.5 5 5.14 | 0.45 | 98 | 10 | WLCSP-4 XDFN-4
Onsemi | 0 | 5.5 | 1.8 2.5 2.8 2.9 3 3.3 | 0.25 | 98 | 10 | XDFN-4
Onsemi | 0 | 5.5 | 1.8 2.5 2.8 2.9 3 3.3 | 0.45 | 98 | 10 | TSOP-5 / SOT-23-5 XDFN-4
Maxim | MAX8840 (http://www.maximintegrated.com/datasheet/index.mvp/id/5275) | 6 | 1.5 ,1.6 ,1.8 ,1.9 ,2.5 ,2.6 ,2.7 ,2.8 ,2.85 ,2.9 ,3 ,3.1 ,3.3 ,4.5 | 0.15 |  | 11.00 | µDFN/6 ,UTLGA/6
Maxim | MAX8510 (http://www.maximintegrated.com/datasheet/index.mvp/id/3769) | 6 | 1.6 ,1.8 ,2.5 ,2.7 ,2.8 ,2.85 ,3 ,3.3 ,4.5 | 0.12 |  | 11.00 | SC-70/5 ,TDFN-EP/8
Maxim | MAX8940 (http://www.maximintegrated.com/datasheet/index.mvp/id/6332) | 6 | 2.8 ,3 | 0.12 |  | 13.00 | SC-70/5
Maxim | MAX15104 (http://www.maximintegrated.com/datasheet/index.mvp/id/7725) | 5.5 | 5.2 | 2 |  | 15.00 | WLP/15
Maxim | MAX15102 (http://www.maximintegrated.com/datasheet/index.mvp/id/7628) | 5.5 | 5.2 | 2 |  | 15.00 | WLP/15
Maxim | MAX15101 (http://www.maximintegrated.com/datasheet/index.mvp/id/7629) | 5.5 | 5.2 | 1 |  | 15.00 | WLP/15
Maxim | MAX15103 (http://www.maximintegrated.com/datasheet/index.mvp/id/7498) | 5.5 | 5.3 | 3 |  | 16.00 | WLP/15
Maxim | MAX8902 (http://www.maximintegrated.com/datasheet/index.mvp/id/5477) | 5.5 | 1.5 ,1.8 ,2 ,2.5 ,3 ,3.1 ,3.3 | 0.5 |  | 16.00 | TDFN-EP/8
TI | LP2989LV (http://www.ti.com/product/LP2989LV) | 16 | 1.8 | 0.5 |  | 18 | 29 mm2: 6 x 4.9(SOIC)
TI | UA723 (http://www.ti.com/product/UA723) | 40 | 37 | 0.15 |  | 20 | See datasheet (PDIP), 80 mm2: 7.8 x 10.2(SO), 52 mm2: 6 x 8.65(SOIC)
Maxim | MAX8878 (http://www.maximintegrated.com/datasheet/index.mvp/id/1806) | 6.5 | 1.5 ,1.8 ,2.5 ,2.8 ,2.84 ,3 ,3.15 ,3.3 ,3.6 ,5 | 0.15 |  | 20.00 | SOT/5 ,TSOT/5
Maxim | MAX8877 (http://www.maximintegrated.com/datasheet/index.mvp/id/1806) | 6.5 | 1.5 ,1.8 ,2.5 ,2.8 ,2.84 ,3 ,3.15 ,3.3 ,3.6 ,5 | 0.15 |  | 20.00 | SOT/5 ,TSOT/5
Maxim | MAX8867 (http://www.maximintegrated.com/datasheet/index.mvp/id/1804) | 5.5 | 2.5 ,2.8 ,2.84 ,3 ,3.15 ,3.3 ,3.6 ,5 | 0.15 |  | 20.00 | SOT/5 ,TSOT/5
Maxim | MAX8868 (http://www.maximintegrated.com/datasheet/index.mvp/id/1804) | 5.5 | 2.5 ,2.8 ,2.84 ,3 ,3.15 ,3.3 ,3.6 ,5 | 0.15 |  | 20.00 | SOT/5 ,TSOT/5
TI | TL317 (http://www.ti.com/product/TL317) | 35 | 32 | 0.1 |  | 30 | 48 mm2: 7.8 x 6.2(SO), 29 mm2: 6 x 4.9(SOIC), 18 mm2: 4.3 x 4.3(TO-92), 19 mm2: 6.4 x 3(TSSOP)
Maxim | MAX8559 (http://www.maximintegrated.com/datasheet/index.mvp/id/4169) | 6.5 | 1.5 ,1.8 ,1.85 ,2.5 ,2.6 ,2.8 ,2.85 ,2.9 ,3 ,3.3 | 0.3 |  | 32.00 | TDFN-EP/8 ,UCSP/8
TI | REG104 (http://www.ti.com/product/REG104) | 15 | 2.5, 3, 3.3, 5 | 1 |  | 33 | 155 mm2: 15.24 x 10.16(DDPAK/TO-263), 46 mm2: 7.06 x 6.5(SOT-223)
TI | LMS1585A (http://www.ti.com/product/LMS1585A) | 13 | 1.5, 3.3 | 5 |  | 38 | 155 mm2: 15.24 x 10.16(DDPAK/TO-263), See datasheet (TO-220)
TI | LMS1587 (http://www.ti.com/product/LMS1587) | 13 | 1.5, 3.3 | 3 |  | 38 | 155 mm2: 15.24 x 10.16(DDPAK/TO-263), See datasheet (TO-220)
TI | LM337L (http://www.ti.com/product/LM337L) | -4.2 | -1.2 | 0.1 |  | 38 | 29 mm2: 6 x 4.9(SOIC), 18 mm2: 4.3 x 4.3(TO-92)
TI | UA78M-Q1 (http://www.ti.com/product/UA78M-Q1) | 25 | 3.3, 5 | 0.5 |  | 40 | 46 mm2: 7 x 6.5(SOT-223)
TI | UA78M (http://www.ti.com/product/UA78M) | 30 | 3.3, 5, 6, 8, 9, 10, 12 | 0.5 |  | 40 | 46 mm2: 7 x 6.5(SOT-223), See datasheet (TO-220), 40 mm2: 6.6 x 6.1(TO-252)
TI | MC79L (http://www.ti.com/product/MC79L) | -7 | -5, -12, -15 | 0.1 |  | 40 | 29 mm2: 6 x 4.9(SOIC), 18 mm2: 4.3 x 4.3(TO-92)
TI | LM79 (http://www.ti.com/product/LM79) | -7 | -5, -12, -15 | 1.5 |  | 40 | See datasheet (TO-220)
Maxim | MAX8882 (http://www.maximintegrated.com/datasheet/index.mvp/id/2410) | 6.5 | 1.8 ,2.5 ,2.85 ,3.3 | 0.16 |  | 40.00 | SOT/6
Maxim | MAX8531 (http://www.maximintegrated.com/datasheet/index.mvp/id/3737) | 6.5 | 2.85 ,3 | 0.2 |  | 40.00 | UCSP/6
Maxim | MAX8532 (http://www.maximintegrated.com/datasheet/index.mvp/id/3763) | 6.5 | 2.85 ,3 | 0.2 |  | 40.00 | UCSP/6
TI | UA78L (http://www.ti.com/product/UA78L) | 30 | 2.6, 5, 6.2, 8, 9, 10, 12, 15 | 0.1 |  | 42 | 29 mm2: 6 x 4.9(SOIC), 18 mm2: 4.095 x 4.5(SOT-89), 18 mm2: 4.3 x 4.3(TO-92)
Maxim | MAX8887 (http://www.maximintegrated.com/datasheet/index.mvp/id/2446) | 5.5 | 1.5 ,1.8 ,2.85 ,3.3 | 0.3 |  | 42.00 | TSOT/5
Maxim | MAX1798 (http://www.maximintegrated.com/datasheet/index.mvp/id/2276) | 5.5 | 3.3 | 0.3 |  | 45.00 | QFN/20 ,TSSOP-EP/20
Maxim | MAX1799 (http://www.maximintegrated.com/datasheet/index.mvp/id/2276) | 5.5 | 3.3 | 0.3 |  | 45.00 | QFN/20 ,TQFN/20 ,TSSOP-EP/20
Maxim | MAX8636 (http://www.maximintegrated.com/datasheet/index.mvp/id/5195) | 5.5 | 1.5 ,1.8 ,2.5 ,2.6 ,2.8 ,2.85 ,2.9 ,3 | 0.3 |  | 45.00 | µDFN/8 ,TDFN-EP/8
TI | LM3411 (http://www.ti.com/product/LM3411) | 20 | 3.3, 5 | 0.015 |  | 50 | 8 mm2: 2.8 x 2.9(SOT-23)
TI | UA78 (http://www.ti.com/product/UA78) | 38 | 5, 8, 10, 12, 15, 24 | 1.5 |  | 52 | 155 mm2: 15.24 x 10.16(DDPAK/TO-263), See datasheet (TO-220)
Maxim | MAX8860 (http://www.maximintegrated.com/datasheet/index.mvp/id/1966) | 6.5 | 1.8 ,2.5 ,2.77 ,2.82 ,3 ,3.3 | 0.3 |  | 55.00 | µMAX/8
Maxim | MAX1982 (http://www.maximintegrated.com/datasheet/index.mvp/id/3518) | 5.5 | 1.2 | 0.3 |  | 65.00 | SOT/6
Maxim | MAX1983 (http://www.maximintegrated.com/datasheet/index.mvp/id/3518) | 5.5 | 2 | 0.3 |  | 65.00 | SOT/6
TI | TL780 (http://www.ti.com/product/TL780) | 30 | 5, 12, 15 | 1.5 |  | 75 | 155 mm2: 15.24 x 10.16(DDPAK/TO-263), See datasheet (TO-220)
Maxim | MAX6478 (http://www.maximintegrated.com/datasheet/index.mvp/id/3494) | 5.5 | 1.5 ,1.6 ,1.7 ,1.8 ,1.9 ,2 ,2.1 ,2.2 ,2.3 ,2.4 ,2.5 ,2.6 ,2.7 ,2.8 ,2.85 ,2.9 ,3 ,3.1 ,3.2 ,3.3 | 0.3 |  | 75.00 | UCSP/9
TI | LP2953QML-SP (http://www.ti.com/product/LP2953QML-SP) | 30 | 29 | 0.25 |  | 80 | See datasheet (CFP)
Linear Tech | LTC3025 | 5.5 | Adj | 0.3 |  | 80.00 | 2x2 DFN-6
Linear Tech | LTC3025-X | 5.5 | Adj, 1.2, 1.5, 1.8 | 0.5 |  | 80.00 | 2x2 DFN-6
TI | LM723 (http://www.ti.com/product/LM723) | 40 | 37 | 0.15 |  | 86 | 80 mm2: 8.96 x 8.96(TO-100)
Maxim | MAX1963A (http://www.maximintegrated.com/datasheet/index.mvp/id/4812) | 3.6 | 0.75 ,0.85 ,0.9 ,0.75 to 3.0 ,1 ,1.1 ,1.2 ,1.3 ,1.5 ,1.6 ,1.8 ,1.85 ,2.5 ,2.85 ,3 | 0.3 |  | 86.00 | TDFN-EP/6 ,TSOT/6
Maxim | MAX1976A (http://www.maximintegrated.com/datasheet/index.mvp/id/4812) | 3.6 | 0.75 ,0.85 ,0.9 ,0.75 to 3.0 ,1 ,1.1 ,1.2 ,1.3 ,1.5 ,1.6 ,1.8 ,1.85 ,2.5 ,2.85 ,3 | 0.3 |  | 86.00 | TDFN-EP/6 ,TDFN-EP/8 ,TSOT/6
Maxim | MAX1589A (http://www.maximintegrated.com/datasheet/index.mvp/id/4795) | 3.6 | 0.75 ,1 ,1.3 ,1.5 ,1.8 ,2.5 ,3 | 0.5 |  | 86.00 | TDFN-EP/6 ,TSOT/6
TI | LP3871 (http://www.ti.com/product/LP3871) | 7 | 1.8, 2.5, 3.3, 5 | 0.8 |  | 100 | 155 mm2: 15.24 x 10.16(DDPAK/TO-263), 45 mm2: 6.96 x 6.5(SOT-223)
TI | LP3874 (http://www.ti.com/product/LP3874) | 7 | 1.8, 2.5, 3.3, 5 | 0.8 |  | 100 | 155 mm2: 15.24 x 10.16(DDPAK/TO-263), 45 mm2: 6.96 x 6.5(SOT-223)
TI | LP3855 (http://www.ti.com/product/LP3855) | 7 | 1.8, 2.5, 3.3, 5 | 1.5 |  | 100 | 155 mm2: 15.24 x 10.16(DDPAK/TO-263), 45 mm2: 6.96 x 6.5(SOT-223), See datasheet (TO-220)
TI | LP3875 (http://www.ti.com/product/LP3875) | 7 | 1.8, 2.5, 3.3, 5 | 1.5 |  | 100 | 155 mm2: 15.24 x 10.16(DDPAK/TO-263), 45 mm2: 6.96 x 6.5(SOT-223), See datasheet (TO-220)
TI | LP3872 (http://www.ti.com/product/LP3872) | 7 | 1.8, 2.5, 3.3, 5 | 1.5 |  | 100 | 155 mm2: 15.24 x 10.16(DDPAK/TO-263), 45 mm2: 6.96 x 6.5(SOT-223)
TI | LP3852 (http://www.ti.com/product/LP3852) | 7 | 1.8, 2.5, 3.3, 5 | 1.5 |  | 100 | 155 mm2: 15.24 x 10.16(DDPAK/TO-263), 45 mm2: 6.96 x 6.5(SOT-223), See datasheet (TO-220)
TI | LP3853 (http://www.ti.com/product/LP3853) | 7 | 1.8, 2.5, 3.3, 5 | 3 |  | 100 | 155 mm2: 15.24 x 10.16(DDPAK/TO-263), See datasheet (TO-220)
TI | LP3873 (http://www.ti.com/product/LP3873) | 7 | 1.8, 2.5, 3.3, 5 | 3 |  | 100 | 155 mm2: 15.24 x 10.16(DDPAK/TO-263)
TI | LP3876 (http://www.ti.com/product/LP3876) | 7 | 1.8, 2.5, 3.3, 5 | 3 |  | 100 | 155 mm2: 15.24 x 10.16(DDPAK/TO-263), See datasheet (TO-220)
TI | LP3856 (http://www.ti.com/product/LP3856) | 7 | 1.8, 2.5, 3.3, 5 | 3 |  | 100 | 155 mm2: 15.24 x 10.16(DDPAK/TO-263), See datasheet (TO-220)
TI | LP3874-ADJ (http://www.ti.com/product/LP3874-ADJ) | 7 | 6.6 | 0.8 |  | 100 | 155 mm2: 15.24 x 10.16(DDPAK/TO-263), 45 mm2: 6.96 x 6.5(SOT-223)
TI | LP3855-ADJ (http://www.ti.com/product/LP3855-ADJ) | 7 | 6.6 | 1.5 |  | 100 | 155 mm2: 15.24 x 10.16(DDPAK/TO-263), 45 mm2: 6.96 x 6.5(SOT-223), See datasheet (TO-220)
TI | LP3875-ADJ (http://www.ti.com/product/LP3875-ADJ) | 7 | 6.4 | 1.5 |  | 100 | 155 mm2: 15.24 x 10.16(DDPAK/TO-263), 45 mm2: 6.96 x 6.5(SOT-223)
TI | LP3876-ADJ (http://www.ti.com/product/LP3876-ADJ) | 7 | 5.8 | 3 |  | 100 | 155 mm2: 15.24 x 10.16(DDPAK/TO-263)
TI | LP3856-ADJ (http://www.ti.com/product/LP3856-ADJ) | 7 | 6.5 | 3 |  | 100 | 155 mm2: 15.24 x 10.16(DDPAK/TO-263), See datasheet (TO-220)
Maxim | MAX1857 (http://www.maximintegrated.com/datasheet/index.mvp/id/2385) | 5.5 | 4.75 | 0.5 |  | 115.00 | µMAX/8
Maxim | MAX1819 (http://www.maximintegrated.com/datasheet/index.mvp/id/3345) | 5.5 | 1.5 ,1.8 ,2 ,2.5 ,3.3 ,5 | 0.5 |  | 115.00 | UCSP/9
Maxim | MAX1818 (http://www.maximintegrated.com/datasheet/index.mvp/id/2383) | 5.5 | 1.5 ,1.8 ,2 ,2.5 ,3.3 ,5 | 0.5 |  | 115.00 | SOT/6
Maxim | MAX1792 (http://www.maximintegrated.com/datasheet/index.mvp/id/2355) | 5.5 | 1.5 ,1.8 ,2.5 ,3.3 ,5 | 0.5 |  | 115.00 | µMAX-EP/8
Maxim | MAX1793 (http://www.maximintegrated.com/datasheet/index.mvp/id/2223) | 5.5 | 2.5 ,3.3 | 1 |  | 115.00 | TSSOP-EP/16
Maxim | MAX15007 (http://www.maximintegrated.com/datasheet/index.mvp/id/5256) | 40 | 3.3 ,5 | 0.05 |  | 115.00 | SOIC(N)-EP/8 ,TDFN-EP/6
Maxim | MAX15006 (http://www.maximintegrated.com/datasheet/index.mvp/id/5256) | 40 | 3.3 ,5 | 0.05 |  | 115.00 | SOIC(N)-EP/8 ,TDFN-EP/6
TI | LM117QML-SP (http://www.ti.com/product/LM117QML-SP) | 40 | 1.8, 2.5, 2.85, 3.3, 5 | 1.5 |  | 120 | See datasheet (CFP), 92 mm2: 9.14 x 10.03(TO), 989 mm2: 25.4 x 38.938(TO)
TI | UA79 (http://www.ti.com/product/UA79) | -7 | -8, -5 | 1.5 |  | 125 | 155 mm2: 15.24 x 10.16(DDPAK/TO-263), See datasheet (TO-220)
TI | UA79M (http://www.ti.com/product/UA79M) | -7 | -8, -5 | 0.5 |  | 125 | See datasheet (TO-220), 40 mm2: 6.6 x 6.1(TO-252)
TI | LP3961 (http://www.ti.com/product/LP3961) | 7 | 1.8, 2.5, 3.3, 5 | 0.8 |  | 150 | 155 mm2: 15.24 x 10.16(DDPAK/TO-263), 45 mm2: 6.96 x 6.5(SOT-223)
Maxim | MAX8869 (http://www.maximintegrated.com/datasheet/index.mvp/id/2340) | 5.5 | 1 ,1.8 ,2.5 ,3.3 ,5 | 1 |  | 150.00 | TSSOP-EP/16
Maxim | MAX6469 (http://www.maximintegrated.com/datasheet/index.mvp/id/3494) | 5.5 | 1.5 ,1.6 ,1.7 ,1.8 ,1.9 ,2 ,2.1 ,2.2 ,2.3 ,2.4 ,2.5 ,2.6 ,2.7 ,2.8 ,2.85 ,2.9 ,3 ,3.1 ,3.2 ,3.3 | 0.3 |  | 150.00 | SOT/6 ,TDFN-EP/8
Maxim | MAX6470 (http://www.maximintegrated.com/datasheet/index.mvp/id/3494) | 5.5 | 1.5 ,1.6 ,1.7 ,1.8 ,1.9 ,2 ,2.1 ,2.2 ,2.3 ,2.4 ,2.5 ,2.6 ,2.7 ,2.8 ,2.85 ,2.9 ,3 ,3.1 ,3.2 ,3.3 | 0.3 |  | 150.00 | SOT/6 ,TDFN-EP/8
Maxim | MAX6471 (http://www.maximintegrated.com/datasheet/index.mvp/id/3494) | 5.5 | 1.5 ,1.6 ,1.7 ,1.8 ,1.9 ,2 ,2.1 ,2.2 ,2.3 ,2.4 ,2.5 ,2.6 ,2.7 ,2.8 ,2.85 ,2.9 ,3 ,3.1 ,3.2 ,3.3 | 0.3 |  | 150.00 | SOT/6 ,TDFN-EP/8
Maxim | MAX6472 (http://www.maximintegrated.com/datasheet/index.mvp/id/3494) | 5.5 | 1.5 ,1.6 ,1.7 ,1.8 ,1.9 ,2 ,2.1 ,2.2 ,2.3 ,2.4 ,2.5 ,2.6 ,2.7 ,2.8 ,2.85 ,2.9 ,3 ,3.1 ,3.2 ,3.3 | 0.3 |  | 150.00 | SOT/6 ,TDFN-EP/8
Maxim | MAX6473 (http://www.maximintegrated.com/datasheet/index.mvp/id/3494) | 5.5 | 1.5 ,1.6 ,1.7 ,1.8 ,1.9 ,2 ,2.1 ,2.2 ,2.3 ,2.4 ,2.5 ,2.6 ,2.7 ,2.8 ,2.85 ,2.9 ,3 ,3.1 ,3.2 ,3.3 | 0.3 |  | 150.00 | SOT/6 ,TDFN-EP/8
Maxim | MAX6474 (http://www.maximintegrated.com/datasheet/index.mvp/id/3494) | 5.5 | 1.5 ,1.6 ,1.7 ,1.8 ,1.9 ,2 ,2.1 ,2.2 ,2.3 ,2.4 ,2.5 ,2.6 ,2.7 ,2.8 ,2.85 ,2.9 ,3 ,3.1 ,3.2 ,3.3 | 0.3 |  | 150.00 | SOT/6 ,TDFN-EP/8
Maxim | MAX6475 (http://www.maximintegrated.com/datasheet/index.mvp/id/3494) | 5.5 | 1.5 ,1.6 ,1.7 ,1.8 ,1.9 ,2 ,2.1 ,2.2 ,2.3 ,2.4 ,2.5 ,2.6 ,2.7 ,2.8 ,2.85 ,2.9 ,3 ,3.1 ,3.2 ,3.3 | 0.3 |  | 150.00 | SOT/6 ,TDFN-EP/8
Maxim | MAX6476 (http://www.maximintegrated.com/datasheet/index.mvp/id/3494) | 5.5 | 1.5 ,1.6 ,1.7 ,1.8 ,1.9 ,2 ,2.1 ,2.2 ,2.3 ,2.4 ,2.5 ,2.6 ,2.7 ,2.8 ,2.85 ,2.9 ,3 ,3.1 ,3.2 ,3.3 | 0.3 |  | 150.00 | SOT/6 ,TDFN-EP/8
Linear Tech | LTC3035 | 5.5 | Adj | 0.3 |  | 150.00 | 3x2 DFN-8
TI | LP2981 (http://www.ti.com/product/LP2981) | 16 | 2.8, 2.9, 3, 3.3, 5 | 0.1 |  | 160 | 8 mm2: 2.8 x 2.9(SOT-23)
TI | LP2981A (http://www.ti.com/product/LP2981A) | 16 | 2.8, 2.9, 3, 3.3, 5 | 0.1 |  | 160 | 8 mm2: 2.8 x 2.9(SOT-23)
Maxim | MAX1735 (http://www.maximintegrated.com/datasheet/index.mvp/id/2333) | -6.5 | -5.0 ,-3.0 ,-2.5 | 0.2 |  | 160.00 | SOT/5
Maxim | MAX8875 (http://www.maximintegrated.com/datasheet/index.mvp/id/2125) | 6.5 | 1.5 ,2.5 ,2.7 ,3 ,3.3 ,5 | 0.15 |  | 170.00 | SOT/5
Maxim | MAX8885 (http://www.maximintegrated.com/datasheet/index.mvp/id/2139) | 6.5 | 2.5 ,2.7 ,3 ,3.3 ,5 | 0.15 |  | 170.00 | SOT/5
TI | TPS761 (http://www.ti.com/product/TPS761) | 16 | 3, 3.2, 3.3, 3.8, 5 | 0.1 |  | 190 | 8 mm2: 2.8 x 2.9(SOT-23)
TI | TPS760 (http://www.ti.com/product/TPS760) | 16 | 3, 3.2, 3.3, 3.8, 5 | 0.05 |  | 190 | 8 mm2: 2.8 x 2.9(SOT-23)
TI | UCC284-EP (http://www.ti.com/product/UCC284-EP) | -3.2 | -5 | 0.5 |  | 200 | 29 mm2: 6 x 4.9(SOIC)
TI | UCC384 (http://www.ti.com/product/UCC384) | -3.2 | -5, -12 | 0.5 |  | 200 | 29 mm2: 6 x 4.9(SOIC)
TI | UCC284 (http://www.ti.com/product/UCC284) | -3.2 | -5, -12 | 0.5 |  | 200 | 29 mm2: 6 x 4.9(SOIC)
Maxim | MAX8866 (http://www.maximintegrated.com/datasheet/index.mvp/id/1263) | 5.5 | 2.8 ,2.84 ,3.15 | 0.1 |  | 220.00 | µMAX/8
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
