rlhahn/power_distro/Datasheets/maxim_linear_reg.xls

Maxim Integrated Products
Product selection table for: |  | Linear Regulators
Showing 138 of 138 products
NOTE : 11 columns are hidden
Part Number | Description | Tags | Polarity | Regulators | Vin (min) (V) | Vin (max) (V) | Preset Vout (V) | Special Order Preset | Adj. Vout (min) (V) | Adj. Vout (max) (V) | Vdropout @Rated Iload (typ) (V) | Rated Iload (mA) | Rated Iload (mA) | Vout Acc. (±%) | Icc (typ) (µA) | Icc (max) (µA) | Internal Pass Transistor | Shutdn/ Enable | Output Voltage Noise (typ) (µV RMS) | Ref. Bypass | Low Batt./ Pwr. Fail Out | POK/RST Output | POK/RST Output Type | POK/Reset Thresh. (nom) (V) | Reset PW (min) (ms) | Watchdog | Reverse Batt. Protect. | EV Kit | RoHS Available | Industry Qualified | Oper. Temp. (°C) | Package/Pins | Smallest Available Pckg. (max w/pins) (mm2) | Budgetary Price (See Notes)
MAX17651 (http://www.maximintegrated.com/datasheet/index.mvp/id/8578) | 4V to 60V, 100mA Ultra-Low Quiescent Current, Linear Regulator | - | Negative | 1 | 4 | 60 | - | - | 0.6 | 59 | 0.3 | 100 | 100 | 2 | 7 | 15 | Yes | Yes | - | No | No | POK | Open Drain Active Low | Vout-8% | - | No | No | - | Yes | - | -40 to +125 | TSOT/6 | 8.3 | -
MAX15104 (http://www.maximintegrated.com/datasheet/index.mvp/id/7725) | Small 2A, Low-Dropout Linear Regulator in a 2.7mm × 1.6mm Package | - | Positive | 1 | 2.2 | 5.5 | - | - | 0.6 | 5.2 | 0.05 | 2000 | 2000 | 1.6 | 1800 | 3500 | Yes | Yes | 15 | Yes | No | POK | Open Drain Active High | Vout-12.5% | 0.1 | No | No | Yes | Yes | - | -40 to +85 | WLP/15 | - | $1.82 @1k
MAX15102 (http://www.maximintegrated.com/datasheet/index.mvp/id/7628) | Small 2A, Low-Dropout Linear Regulator in a 2.7mm × 1.6mm Package | - | Positive | 1 | 1.7 | 5.5 | - | - | 0.6 | 5.2 | 0.05 | 2000 | 2000 | 1.6 | 1800 | 3500 | Yes | Yes | 15 | Yes | No | POK | Open Drain Active High | Vout-12.5% | 0.1 | No | No | Yes | Yes | - | -40 to +85 | WLP/15 | - | $1.70 @1k
MAX15101 (http://www.maximintegrated.com/datasheet/index.mvp/id/7629) | Small, 1A, Low Dropout Regulator in a 2.7mm by 1.6mm package | - | Positive | 1 | 1.7 | 5.5 | - | - | 0.6 | 5.2 | 0.025 | 1000 | 1000 | 1.6 | 1800 | 3500 | Yes | Yes | 15 | Yes | No | POK | Open Drain Active High | Vout-12.5% | 0.1 | No | No | Yes | Yes | - | -40 to +85 | WLP/15 | - | $1.30 @1k
MAX15103 (http://www.maximintegrated.com/datasheet/index.mvp/id/7498) | Small, low dropout, 3A linear regulator | - | Positive | 1 | 1.7 | 5.5 | - | - | 0.6 | 5.3 | 0.056 | 3000 | 3000 | 1.5 | 1800 | 3500 | Yes | Yes | 16 | Yes | No | POK | Open Drain Active High | Vout-10% | - | No | - | Yes | Yes | - | -40 to +85 | WLP/15 | - | $1.93 @1k
MAX16910 (http://www.maximintegrated.com/datasheet/index.mvp/id/6336) | 200mA, Automotive, Ultra-Low Quiescent Current, Linear Regulator | - | Positive | 1 | 3.5 | 45 | 3.3 ,5 | - | 1.5 | 11 | 0.28 | 200 | 200 | 2 | 20 | 30 | Yes | Yes | - | - | No | Reset | Open Drain Active Low | Vout-12.5% ,Vout-7.5% | Adj | No | No | - | Yes | Automotive - AECQ100 | -40 to +125 | SOIC(N)-EP/8 ,TDFN-EP/8 | 9.6 | $0.68 @1k
MAX8940 (http://www.maximintegrated.com/datasheet/index.mvp/id/6332) | Low-Noise, High PSRR, Low-Dropout, 120mA Linear Regulator | - | Positive | 1 | 2.8 | 6 | 2.8 ,3 | - | - | - | 0.12 | 120 | 120 | - | 40 | 90 | Yes | Yes | 13 | Yes | No | - | - | - | - | - | No | - | Yes | - | -40 to +85 | SC-70/5 | 5.3 | $0.41 @1k
MAX15030 (http://www.maximintegrated.com/datasheet/index.mvp/id/5857) | 1.425V to 3.6V Input, 500mA Low-Dropout Regulator with BIAS Input | - | Positive | 1 | 1.425 | 3.6 | - | - | 0.5 | 3.6 | 0.04 | 500 | 500 | 2 | 275 | 410 | Yes | Yes | - | - | No | - | - | - | - | No | No | - | Yes | - | -40 to +125 | TDFN-EP/10 | 9.6 | $0.86 @1k
MAX15029 (http://www.maximintegrated.com/datasheet/index.mvp/id/5857) | 1.425V to 3.6V Input, 500mA Low-Dropout Regulator | - | Positive | 1 | 1.425 | 3.6 | - | - | 0.5 | 3.6 | 0.04 | 500 | 500 | 2 | 275 | 410 | Yes | Yes | - | - | No | - | - | - | - | No | No | - | Yes | Automotive - AECQ100 | -40 to +125 | DFND/8 ,TDFN-EP/10 ,TDFN/10 | 9.6 | $0.84 @1k
MAX8891 (http://www.maximintegrated.com/datasheet/index.mvp/id/6200) | High PSRR, Low-Dropout, 150mA Linear Regulators | - | Positive | 1 | 2 | 6 | 1.5 ,1.8 ,2.5 ,2.6 ,2.8 ,2.85 ,2.9 ,3.1 ,3.3 ,4.5 | - | - | - | 0.15 | 150 | 150 | 3 | 40 | - | Yes | Yes | 230 | No | No | - | - | - | - | No | No | - | Yes | Automotive - AECQ100 | -40 to +85 | SC-70/5 | 5.3 | $0.45 @1k
MAX8892 (http://www.maximintegrated.com/datasheet/index.mvp/id/6200) | High PSRR, Low-Dropout, 150mA Linear Regulators | - | Positive | 1 | 2 | 6 | - | - | 1.225 | 4.5 | 0.15 | 150 | 150 | 3 | 40 | - | Yes | Yes | 230 | No | No | - | - | - | - | No | No | - | Yes | - | -40 to +85 | SC-70/5 | 5.3 | $0.45 @1k
MAX15027 (http://www.maximintegrated.com/datasheet/index.mvp/id/5855) | 1.425V to 3.6V Input, 1A Low-Dropout Regulators with BIAS Input | FPGA | Positive | 1 | 1.425 | 3.6 | - | - | 0.5 | 3.3 | 0.075 | 1000 | 1000 | 2 | 275 | 410 | Yes | Yes | - | - | No | - | - | - | - | No | No | - | Yes | Automotive - AECQ100 | -40 to +125 | TDFN-EP/10 | 9.6 | $1.05 @1k
MAX16999 (http://www.maximintegrated.com/datasheet/index.mvp/id/5854) | Ultra-Low Output Voltage, Low-Quiescent-Current Linear Regulator for High-Temperature Applications | - | Positive | 1 | 2.5 | 5.5 | 0.5 ,0.6 ,0.7 ,0.8 ,0.9 ,1 ,1.1 ,1.2 ,1.5 ,1.8 ,3.3 | - | 0.5 | 3.3 | 0.044 | 100 | 100 | 2.5 | 13 | 20 | Yes | Yes | - | - | No | Reset | Open Drain Active Low | Vout-17.5% | Adj | No | No | - | Yes | - | -40 to +125 | µMAX-EP/8 | 15.3 | $0.97 @1k
MAX8902 (http://www.maximintegrated.com/datasheet/index.mvp/id/5477) | Low-Noise 500mA LDO Regulators in a 2mm x 2mm TDFN Package | FPGA | Positive | 1 | 1.7 | 5.5 | 1.5 ,1.8 ,2 ,2.5 ,3 ,3.1 ,3.3 | - | 0.6 | 5.3 | 0.05 | 500 | 500 | 1.5 | 80 | 120 | Yes | Yes | 16 | Yes | No | POK | Open Drain Active Low | Vout-9% | - | No | No | - | Yes | Automotive - AECQ100 | -40 to +125 | TDFN-EP/8 | 4.2 | $1.33 @1k
MAX15008 (http://www.maximintegrated.com/datasheet/index.mvp/id/5563) | Automotive 300mA LDO Voltage Regulators with Tracker Output and Overvoltage Protector | - | Positive | 1 | 4.5 | 45 | 5 | - | 1.8 | 11 | 0.8 | 300 | 300 | 1.9 | 67 | 85 | Yes | Yes | - | - | No | Reset | Open Drain Active Low | Vout-10% | 0.01 | No | No | Yes | Yes | - | -40 to +125 | TQFN/32 | 26 | -
MAX15010 (http://www.maximintegrated.com/datasheet/index.mvp/id/5563) | Automotive 300mA LDO Voltage Regulators with Tracker Output | - | Positive | 1 | 4.5 | 45 | 5 | - | 1.8 | 11 | 0.8 | 300 | 300 | 1.9 | 67 | 85 | Yes | Yes | - | - | No | Reset | Open Drain Active Low | Vout-10% | 0.01 | No | No | Yes | Yes | - | -40 to +125 | TQFN/32 | 26 | -
MAX15009 (http://www.maximintegrated.com/datasheet/index.mvp/id/5529) | Automotive 300mA LDO Regulators with Switched Output and Overvoltage Protector | - | Positive | 1 | 5 | 40 | 5 | - | 1.8 | 11 | 0.8 | 300 | 300 | 2.5 | 70 | 92 | Yes | Yes | - | - | No | Reset | Open Drain Active Low | Vout-10% | Adj | No | No | - | Yes | - | -40 to +125 | TQFN/32 ,TQFN/56 | 26 | -
MAX15011 (http://www.maximintegrated.com/datasheet/index.mvp/id/5529) | Automotive 300mA LDO Regulators with Switched Output and Overvoltage Protector | - | Positive | 1 | 5 | 40 | 5 | - | 1.8 | 11 | 0.8 | 300 | 300 | 2.5 | 70 | 92 | Yes | Yes | - | - | No | Reset | Open Drain Active Low | Vout-10% | Adj | No | No | - | Yes | - | -40 to +125 | TQFN/32 | 26 | -
MAX6774 (http://www.maximintegrated.com/datasheet/index.mvp/id/5217) | Automotive Micropower Linear Regulators with Supervisor | - | Positive | 1 | 4 | 72 | 1.8 ,2.5 ,3.3 ,5 | - | 1.8 | 11 | 0.62 | 100 | 100 | 1.5 | 38 | 50 | Yes | Yes | - | - | No | Reset | Push-Pull Active Low | Vout-7.5% | 2 ,9 ,35 ,140 | Yes | No | - | Yes | - | -40 to +125 | TDFN-EP/8 | 9.6 | $3.60 @1k
MAX6773 (http://www.maximintegrated.com/datasheet/index.mvp/id/5217) | Automotive Micropower Linear Regulators with Supervisor | - | Positive | 1 | 4 | 72 | 1.8 ,2.5 ,3.3 ,5 | - | 1.8 | 11 | 0.62 | 100 | 100 | 1.5 | 38 | 50 | Yes | Yes | - | - | No | Reset | Open Drain Active Low | Vout-7.5% | 2 ,9 ,35 ,140 | Yes | No | - | Yes | Automotive - AECQ100 | -40 to +125 | TDFN-EP/8 | 9.6 | $2.37 @1k
MAX8842 (http://www.maximintegrated.com/datasheet/index.mvp/id/5275) | Ultra-Low-Noise, High PSRR, Low-Dropout, 150mA Linear Regulators in µDFN | - | Positive | 1 | 2 | 6 | - | - | 1.5 | 4.5 | 0.17 | 150 | 150 | 1 | 40 | 90 | Yes | Yes | 230 | No | No | - | - | - | - | No | No | - | Yes | - | -40 to +85 | µDFN/6 | 1.6 | $0.54 @1k
MAX5091 (http://www.maximintegrated.com/datasheet/index.mvp/id/5242) | 28V, 100mA, Low-Quiescent-Current LDO with Reset and Power-Fail Input/Output | - | Positive | 1 | 5 | 28 | 3.3 ,5 | - | - | - | 0.3 | 100 | 100 | 1 | 46 | 100 | Yes | Yes | - | - | Yes | Reset | Open Drain Active Low | Vout-10% | 55 | No | No | - | Yes | - | -40 to +125 | SOIC(N)-EP/8 ,TDFN-EP/8 | 9.6 | $0.97 @1k
MAX8840 (http://www.maximintegrated.com/datasheet/index.mvp/id/5275) | Ultra-Low-Noise, High PSRR, Low-Dropout, 150mA Linear Regulators in µDFN | - | Positive | 1 | 2 | 6 | 1.5 ,1.6 ,1.8 ,1.9 ,2.5 ,2.6 ,2.7 ,2.8 ,2.85 ,2.9 ,3 ,3.1 ,3.3 ,4.5 | - | - | - | 0.17 | 150 | 150 | 1 | 40 | 90 | Yes | Yes | 11 | Yes | No | - | - | - | - | No | No | - | Yes | - | -40 to +85 | µDFN/6 ,UTLGA/6 | 1.6 | $0.54 @1k
MAX15007 (http://www.maximintegrated.com/datasheet/index.mvp/id/5256) | 40V, Ultra-Low Quiescent-Current Linear Regulators in 6-Pin TDFN/8-Pin SO | FPGA | Positive | 1 | 4 | 40 | 3.3 ,5 | - | 1.8 | 10 | 0.3 | 50 | 50 | 1.5 | 11 | 18 | Yes | Yes | 115 | No | No | - | - | - | - | No | No | - | Yes | Automotive - AECQ100 | -40 to +125 | SOIC(N)-EP/8 ,TDFN-EP/6 | 9.6 | $0.91 @1k
MAX8841 (http://www.maximintegrated.com/datasheet/index.mvp/id/5275) | Ultra-Low-Noise, High PSRR, Low-Dropout, 150mA Linear Regulators in µDFN | - | Positive | 1 | 2 | 6 | 1.5 ,1.6 ,1.8 ,1.9 ,2.5 ,2.6 ,2.7 ,2.8 ,2.85 ,2.9 ,3 ,3.1 ,3.3 ,4.5 | - | - | - | 0.17 | 150 | 150 | 1 | 40 | 90 | Yes | Yes | 230 | No | No | - | - | - | - | No | No | - | Yes | - | -40 to +85 | µDFN/6 | 1.6 | $0.54 @1k
MAX6771 (http://www.maximintegrated.com/datasheet/index.mvp/id/5217) | Automotive Micropower Linear Regulator with Supervisor | - | Positive | 1 | 4 | 72 | 1.8 ,2.5 ,3.3 ,5 | - | 1.8 | 11 | 0.62 | 100 | 100 | 1.5 | 31 | 45 | Yes | Yes | - | - | No | Reset | Open Drain Active Low | Vout-12.5% ,Vout-7.5% | 2 ,8 ,35 ,140 | No | No | - | Yes | - | -40 to +125 | TDFN-EP/8 | 9.6 | $2.97 @1k
MAX6769 (http://www.maximintegrated.com/datasheet/index.mvp/id/5217) | Automotive Micropower Linear Regulator with Supervisor | - | Positive | 1 | 4 | 72 | 1.8 ,2.5 ,3.3 ,5 | - | 1.8 | 11 | 0.62 | 100 | 100 | 1.5 | 31 | 45 | Yes | Yes | - | - | No | Reset | Open Drain Active Low | Vout-12.5% ,Vout-7.5% | 2 ,8 ,35 ,140 | No | No | - | Yes | Automotive - AECQ100 | -40 to +125 | TDFN-EP/8 | 9.6 | $1.10 @1k
MAX6768 (http://www.maximintegrated.com/datasheet/index.mvp/id/5217) | Automotive Micropower Linear Regulator with Supervisor | - | Positive | 1 | 4 | 72 | 1.8 ,2.5 ,3.3 ,5 | - | 1.8 | 11 | 0.62 | 100 | 100 | 1.5 | 31 | 45 | Yes | Yes | - | - | No | Reset | Push-Pull Active Low | Vout-12.5% ,Vout-7.5% | 2 ,8 ,35 ,140 | No | No | - | Yes | - | -40 to +125 | TDFN-EP/8 | 9.6 | $3.60 @1k
MAX6767 (http://www.maximintegrated.com/datasheet/index.mvp/id/5217) | Automotive Micropower Linear Regulator with Supervisor | - | Positive | 1 | 4 | 72 | 1.8 ,2.5 ,3.3 ,5 | - | 1.8 | 11 | 0.62 | 100 | 100 | 1.5 | 31 | 45 | Yes | Yes | - | - | No | Reset | Open Drain Active Low | Vout-12.5% ,Vout-7.5% | 2 ,8 ,35 ,140 | No | No | - | Yes | Automotive - AECQ100 | -40 to +125 | TDFN-EP/8 | 9.6 | $2.97 @1k
MAX6766 (http://www.maximintegrated.com/datasheet/index.mvp/id/5217) | Automotive Micropower Linear Regulator with Supervisor | - | Positive | 1 | 4 | 72 | 1.8 ,2.5 ,3.3 ,5 | - | - | - | 0.62 | 100 | 100 | 1.5 | 31 | 45 | Yes | Yes | - | - | No | Reset | Push-Pull Active Low | Vout-12.5% ,Vout-7.5% | 2 ,8 ,35 ,140 | No | No | - | Yes | - | -40 to +125 | TDFN-EP/6 | 9.6 | $3.60 @1k
MAX6770 (http://www.maximintegrated.com/datasheet/index.mvp/id/5217) | Automotive Micropower Linear Regulator with Supervisor | - | Positive | 1 | 4 | 72 | 1.8 ,2.5 ,3.3 ,5 | - | 1.8 | 11 | 0.62 | 100 | 100 | 1.5 | 31 | 45 | Yes | Yes | - | - | No | Reset | Push-Pull Active Low | Vout-12.5% ,Vout-7.5% | 2 ,8 ,35 ,140 | No | No | - | Yes | - | -40 to +125 | TDFN-EP/8 | 9.6 | $3.60 @1k
MAX6772 (http://www.maximintegrated.com/datasheet/index.mvp/id/5217) | Automotive Micropower Linear Regulator with Supervisor | - | Positive | 1 | 4 | 72 | 1.8 ,2.5 ,3.3 ,5 | - | 1.8 | 11 | 0.62 | 100 | 100 | 1.5 | 31 | 45 | Yes | Yes | - | - | No | Reset | Push-Pull Active Low | Vout-12.5% ,Vout-7.5% | 2 ,8 ,35 ,140 | No | No | - | Yes | - | -40 to +125 | TDFN-EP/8 | 9.6 | $1.24 @1k
MAX5092 (http://www.maximintegrated.com/datasheet/index.mvp/id/5262) | 4V to 72V Input LDOs with Boost Preregulator | - | Positive | 1 | 3.5 | 72 | 3.3 ,5 | - | 1.5 | 9 | 0.9 | 250 | 250 | 1.5 | 65 | 85 | Yes | Yes | - | - | No | Reset | Open Drain Active Low | Vout-10% | Adj | No | No | - | Yes | - | -40 to +125 | TQFN/16 | 26 | $1.93 @1k
MAX5093 (http://www.maximintegrated.com/datasheet/index.mvp/id/5262) | 4V to 72V Input LDOs with Boost Preregulator | - | Positive | 1 | 3.5 | 72 | 3.3 ,5 | - | 1.5 | 10 | 0.9 | 250 | 250 | 1.5 | 65 | 85 | Yes | Yes | - | - | No | Reset | Open Drain Active Low | Vout-10% | Adj | No | No | Yes | Yes | - | -40 to +125 | TQFN/16 | 26 | $1.67 @1k
MAX6765 (http://www.maximintegrated.com/datasheet/index.mvp/id/5217) | Automotive Micropower Linear Regulator with Supervisor | - | Positive | 1 | 4 | 72 | 1.8 ,2.5 ,3.3 ,5 | - | - | - | 0.62 | 100 | 100 | 1.5 | 31 | 45 | Yes | Yes | - | - | No | Reset | Open Drain Active Low | Vout-12.5% ,Vout-7.5% | 2 ,8 ,35 ,140 | No | No | - | Yes | Automotive - AECQ100 | -40 to +125 | TDFN-EP/6 | 9.6 | $2.37 @1k
MAX15006 (http://www.maximintegrated.com/datasheet/index.mvp/id/5256) | 40V Ultra-Low quiescent-Current Linear Regulator | FPGA | Positive | 1 | 4 | 40 | 3.3 ,5 | - | 1.8 | 10 | 0.3 | 50 | 50 | 1.5 | 10 | 17 | Yes | No | 115 | No | No | - | - | - | - | No | No | - | Yes | Automotive - AECQ100 | -40 to +125 | SOIC(N)-EP/8 ,TDFN-EP/6 | 9.6 | $0.80 @1k
MAX6792 (http://www.maximintegrated.com/datasheet/index.mvp/id/3441) | High-Voltage, Micropower, Dual Linear Regulators with Supervisory Functions | - | Positive | 2 | 5 | 72 | 1.8 ,2.5 ,3.3 ,5 | - | 1.8 | 11 | 1 | 150 | 150 | 3 | 68 | 85 | Yes | Yes | - | - | Yes | Reset | Push-Pull Active Low | Vout-12.5% ,Vout-7.5% | 2 ,9 ,35 ,140 | Yes | Yes | Yes | Yes | - | -40 to +125 | TQFN/20 | 26 | $1.80 @1k
MAX6794 (http://www.maximintegrated.com/datasheet/index.mvp/id/3441) | High-Voltage, Micropower, Dual Linear Regulators with Supervisory Functions | - | Positive | 2 | 5 | 72 | 1.8 ,2.5 ,3.3 ,5 | - | 1.8 | 11 | 1 | 150 | 150 | 3 | 68 | 85 | Yes | Yes | - | - | Yes | Reset | Push-Pull Active Low | Vout-12.5% ,Vout-7.5% | 2 ,9 ,35 ,140 | Yes | Yes | Yes | Yes | - | -40 to +125 | TQFN/20 | 26 | $1.99 @1k
MAX6791 (http://www.maximintegrated.com/datasheet/index.mvp/id/3441) | High-Voltage, Micropower, Dual Linear Regulators with Supervisory Functions | - | Positive | 2 | 5 | 72 | 1.8 ,2.5 ,3.3 ,5 | - | 1.8 | 11 | 1 | 150 | 150 | 3 | 68 | 85 | Yes | Yes | - | - | Yes | Reset | Open Drain Active Low | Vout-12.5% ,Vout-7.5% | 2 ,9 ,35 ,140 | Yes | Yes | Yes | Yes | - | -40 to +125 | TQFN/20 | 26 | $1.87 @1k
MAX6796 (http://www.maximintegrated.com/datasheet/index.mvp/id/3441) | High-Voltage, Micropower Linear Regulators with Supervisory Functions | - | Positive | 1 | 5 | 72 | 1.8 ,2.5 ,3.3 ,5 | - | 1.8 | 11 | 1.2 | 300 | 300 | 3 | 68 | 85 | Yes | Yes | - | - | Yes | Reset | Push-Pull Active Low | Vout-12.5% ,Vout-7.5% | 2 ,9 ,35 ,140 | Yes | Yes | Yes | Yes | - | -40 to +125 | TQFN/20 | 26 | $1.48 @1k
MAX6795 (http://www.maximintegrated.com/datasheet/index.mvp/id/3441) | High-Voltage, Micropower Linear Regulators with Supervisory Functions | - | Positive | 1 | 5 | 72 | 1.8 ,2.5 ,3.3 ,5 | - | 1.8 | 11 | 1.2 | 300 | 300 | 3 | 68 | 85 | Yes | Yes | - | - | Yes | Reset | Open Drain Active Low | Vout-12.5% ,Vout-7.5% | 2 ,9 ,35 ,140 | Yes | Yes | Yes | Yes | Automotive - AECQ100 | -40 to +125 | TQFN/20 | 26 | $1.48 @1k
MAX6793 (http://www.maximintegrated.com/datasheet/index.mvp/id/3441) | High-Voltage, Micropower, Dual Linear Regulators with Supervisory Functions | - | Positive | 2 | 5 | 72 | 1.8 ,2.5 ,3.3 ,5 | - | 1.8 | 11 | 1 | 150 | 150 | 3 | 68 | 85 | Yes | Yes | - | - | Yes | Reset | Open Drain Active Low | Vout-12.5% ,Vout-7.5% | 2 ,9 ,35 ,140 | Yes | Yes | Yes | Yes | Automotive - AECQ100 | -40 to +125 | TQFN/20 | 26 | $1.75 @1k
MAX8635 (http://www.maximintegrated.com/datasheet/index.mvp/id/5195) | Dual 300mA Pin Programmable Regulators with Individual Shutdowns in 2x2mm µDFN or 3x3mm TDFN | - | Positive | 2 | 2.7 | 5.5 | 1.5 ,1.8 ,2.5 ,2.6 ,2.8 ,2.85 ,2.9 ,3 | - | - | - | 0.25 | 300 | 300 | 0.7 | 54 | 75 | Yes | Yes | 450 | No | No | - | - | - | - | No | No | Yes | Yes | - | -40 to +85 | µDFN/8 ,TDFN-EP/8 | 4.2 | -
MAX8633 (http://www.maximintegrated.com/datasheet/index.mvp/id/5195) | Dual 300mA Pin Programmable Regulators with Reset in 2x2mm uDFN or 3x3mm TDFN | - | Positive | 2 | 2.7 | 5.5 | 1.5 ,1.6 ,1.8 ,1.85 ,2.6 ,2.8 ,2.9 ,3 | - | - | - | 0.25 | 300 | 300 | 0.7 | 54 | 75 | Yes | Yes | 450 | No | No | Reset | Push-Pull Active Low | Vout-13% | 120 | No | No | Yes | Yes | - | -40 to +85 | µDFN/8 ,TDFN-EP/8 | 4.2 | -
MAX8636 (http://www.maximintegrated.com/datasheet/index.mvp/id/5195) | Dual 300mA Pin Programmable Low Noise Regulators in 2x2mm µDFN or 3x3mm TDFN | - | Positive | 2 | 2.7 | 5.5 | 1.5 ,1.8 ,2.5 ,2.6 ,2.8 ,2.85 ,2.9 ,3 | - | - | - | 0.25 | 300 | 300 | 0.7 | 54 | 75 | Yes | Yes | 45 | Yes | No | - | - | - | - | No | No | Yes | Yes | Automotive - AECQ100 | -40 to +85 | µDFN/8 ,TDFN-EP/8 | 4.2 | $0.67 @1k
MAX5085 (http://www.maximintegrated.com/datasheet/index.mvp/id/4046) | 65V, 200mA, Low-Quiescent-Current Linear Regulator in TDFN Package | - | Positive | 1 | 6.5 | 65 | 3.3 | - | 2.54 | 11 | 0.9 | 200 | 200 | 4 | 51 | 140 | Yes | Yes | - | - | No | - | - | - | - | No | No | - | Yes | - | -40 to +125 | TDFN-EP/6 | 9.6 | $1.33 @1k
MAX5084 (http://www.maximintegrated.com/datasheet/index.mvp/id/4046) | 65V, 200mA, Low-Quiescent-Current Linear Regulator in TDFN Package | - | Positive | 1 | 6.5 | 65 | 5 | - | 2.54 | 11 | 0.9 | 200 | 200 | 4 | 51 | 140 | Yes | Yes | - | - | No | - | - | - | - | No | No | - | Yes | - | -40 to +125 | TDFN-EP/6 | 9.6 | $1.53 @1k
MAX5087B (http://www.maximintegrated.com/datasheet/index.mvp/id/5028) | 45V, 400mA, Low-Quiescent-Current Linear Regulator with Adjustable Reset Delay | - | Positive | 1 | 6.5 | 45 | 5 | - | 2.5 | 11 | 0.9 | 400 | 400 | 3 | 70 | 150 | Yes | Yes | - | - | No | Reset | Open Drain Active Low | Vout-8% | Adj | No | No | - | Yes | Automotive - AECQ100 | -40 to +125 | TQFN/16 | 26 | $1.42 @1k
MAX5087A (http://www.maximintegrated.com/datasheet/index.mvp/id/5028) | 45V, 400mA, Low-Quiescent-Current Linear Regulator with Adjustable Reset Delay | - | Positive | 1 | 6.5 | 45 | 3.3 | - | 2.5 | 11 | 0.9 | 400 | 400 | 3 | 70 | 150 | Yes | Yes | - | - | No | Reset | Open Drain Active Low | Vout-8% | Adj | No | No | - | Yes | - | -40 to +125 | TQFN/16 | 26 | $1.42 @1k
MAX5086 (http://www.maximintegrated.com/datasheet/index.mvp/id/5025) | 45V, 250mA, Low-Quiescent-Current Linear Regulator with Adjustable Reset Delay | - | Positive | 1 | 6.5 | 45 | 3.3 ,5 | - | 2.5 | 11 | 0.9 | 250 | 250 | 3 | 70 | 115 | Yes | Yes | - | - | No | Reset | Open Drain Active Low | Vout-8% | Adj | No | No | - | Yes | Automotive - AECQ100 | -40 to +125 | TQFN/16 | 26 | $1.56 @1k
MAX1589A (http://www.maximintegrated.com/datasheet/index.mvp/id/4795) | Low-Input-Voltage, 500mA LDO Regulator with Reset in SOT and TDFN | - | Positive | 1 | 1.62 | 3.6 | 0.75 ,1 ,1.3 ,1.5 ,1.8 ,2.5 ,3 | - | - | - | 0.175 | 500 | 500 | 1.5 | 70 | 140 | Yes | Yes | 86 | No | No | Reset | Open Drain Active Low | Vout-17.5% | 70 | No | No | - | Yes | - | -40 to +85 | TDFN-EP/6 ,TSOT/6 | 8.3 | $1.00 @1k
MAX1963A (http://www.maximintegrated.com/datasheet/index.mvp/id/4812) | Low-Input-Voltage, 300mA LDO Regulators with RESET in SOT and TDFN | - | Positive | 1 | 1.62 | 3.6 | 0.75 ,0.85 ,0.9 ,0.75 to 3.0 ,1 ,1.1 ,1.2 ,1.3 ,1.5 ,1.6 ,1.8 ,1.85 ,2.5 ,2.85 ,3 | - | - | - | 0.1 | 300 | 300 | 2.5 | 70 | 140 | Yes | Yes | 86 | No | No | Reset | Open Drain Active Low | Vout-17.5% | 2.2 | No | No | - | Yes | - | -40 to +85 | TDFN-EP/6 ,TSOT/6 | 8.3 | $0.72 @1k
MAX1976A (http://www.maximintegrated.com/datasheet/index.mvp/id/4812) | Low-Input-Voltage, 300mA LDO Regulators with RESET in SOT and TDFN | - | Positive | 1 | 1.62 | 3.6 | 0.75 ,0.85 ,0.9 ,0.75 to 3.0 ,1 ,1.1 ,1.2 ,1.3 ,1.5 ,1.6 ,1.8 ,1.85 ,2.5 ,2.85 ,3 | - | - | - | 0.1 | 300 | 300 | 2.5 | 70 | 140 | Yes | Yes | 86 | No | No | Reset | Open Drain Active Low | Vout-17.5% | 70 | No | No | - | Yes | - | -40 to +85 | TDFN-EP/6 ,TDFN-EP/8 ,TSOT/6 | 4.2 | $1.56 @1k
MAX6397 (http://www.maximintegrated.com/datasheet/index.mvp/id/4786) | 72V Overvoltage Protection Switch with Always On Linear Regulator | - | Positive | 1 | 5.5 | 72 | 1.8 ,2.5 ,3.3 ,5 | - | - | - | 0.7 | 100 | 100 | 1.5 | 40 | 48 | Yes | Yes | - | - | No | POK | Open Drain Active Low | Vout-12.5% ,Vout-7.5% | - | No | No | Yes | Yes | Automotive - AECQ100 | -40 to +125 | TDFN-EP/8 | 9.6 | $2.41 @1k
MAX1510 (http://www.maximintegrated.com/datasheet/index.mvp/id/4298) | Low Voltage DDR Linear Regulator | - | Positive | 1 | 1.1 | 3.6 | - | - | 0.5 | 1.5 | 0.35 | 2000 | 2000 | 1.2 | 700 | 1300 | Yes | Yes | - | - | No | POK | Open Drain Active Low | Vout-10% | - | No | No | Yes | Yes | - | -40 to +85 | TDFN-EP/10 | 9.6 | $2.71 @1k
MAX8719 (http://www.maximintegrated.com/datasheet/index.mvp/id/4518) | High-Voltage, Low-Power Linear Regulator for Notebook Computers | - | Positive | 1 | 4 | 28 | - | - | 1.24 | 28 | 0.35 | 100 | 100 | 2 | 12 | 18 | Yes | Yes | - | - | No | Reset | Open Drain Active Low | Vout-10% | 100 | No | No | - | Yes | - | -40 to +85 | TDFN-EP/8 | 9.6 | $1.12 @1k
MAX8563 (http://www.maximintegrated.com/datasheet/index.mvp/id/4368) | Ultra Low Output Voltage, Triple LDO n-FET Controller | - | Positive | 3 | 4.5 | 13.2 | - | - | 0.5 | 5 | 0.056 | 3000 | 3000 | 1 | 930 | 1600 | No | Yes | - | - | No | POK | Open Drain Active Low | Vout-12% | - | No | No | Yes | Yes | - | -40 to +85 | QSOP/16 | 30.9 | $1.19 @1k
MAX8564 (http://www.maximintegrated.com/datasheet/index.mvp/id/4368) | Ultra Low Output Voltage, Dual LDO n-FET Controller | - | Positive | 2 | 4.5 | 13.2 | - | - | 0.5 | 5 | 0.056 | 3000 | 3000 | 1 | 660 | 1200 | No | Yes | - | - | No | POK | Open Drain Active Low | Vout-12% | - | No | No | Yes | Yes | - | -40 to +85 | µMAX/10 | 15.4 | $1.59 @1k
MAX8556 (http://www.maximintegrated.com/datasheet/index.mvp/id/4270) | 4A Ultra-Low-Input-Voltage LDO Regulator | FPGA | Positive | 1 | 1.4 | 3.6 | - | - | 0.5 | 3.4 | 0.1 | 4000 | 4000 | 1 | 800 | 1600 | Yes | Yes | - | - | No | POK | Open Drain Active Low | Vout-10% | - | No | No | Yes | Yes | - | -40 to +85 | TQFN/16 | 26 | $3.91 @1k
MAX8557 (http://www.maximintegrated.com/datasheet/index.mvp/id/4270) | 4A Ultra-Low-Input-Voltage LDO Regulator | FPGA | Positive | 1 | 1.4 | 3.6 | - | - | 0.5 | 3.4 | 0.1 | 4000 | 4000 | 1 | 800 | 1600 | Yes | Yes | - | - | No | Reset | Open Drain Active Low | Vout-10% | 100 | No | No | Yes | Yes | - | -40 to +85 | TQFN/16 | 26 | $3.91 @1k
MAX8516 (http://www.maximintegrated.com/datasheet/index.mvp/id/4262) | 1.425V to 3.6V Input, 1A,0.2V Dropout LDO Regulators | FPGA | Positive | 1 | 1.4 | 3.6 | - | - | 0.5 | 3.4 | 0.2 | 1000 | 1000 | 0.6 | 320 | 600 | Yes | Yes | - | - | No | - | - | - | - | No | No | - | Yes | - | -40 to +85 | µMAX-EP/10 | 26 | $2.74 @1k
MAX8517 (http://www.maximintegrated.com/datasheet/index.mvp/id/4262) | 1.425V to 3.6V Input, 1A,0.2V Dropout LDO Regulators | FPGA | Positive | 1 | 1.4 | 3.6 | - | - | 0.5 | 3.4 | 0.2 | 1000 | 1000 | 0.6 | 320 | 600 | Yes | Yes | - | - | No | POK | Open Drain Active Low | Vout-10% | - | No | No | - | Yes | Automotive - AECQ100 | -40 to +85 | µMAX-EP/10 | 26 | $2.74 @1k
MAX8518 (http://www.maximintegrated.com/datasheet/index.mvp/id/4262) | 1.425V to 3.6V Input, 1A,0.2V Dropout LDO Regulators | FPGA | Positive | 1 | 1.4 | 3.6 | - | - | 0.5 | 3.4 | 0.2 | 1000 | 1000 | 0.6 | 320 | 600 | Yes | Yes | - | - | No | Reset | Open Drain Active Low | Vout-10% | 105 | No | No | - | Yes | - | -40 to +85 | µMAX-EP/10 | 26 | $2.74 @1k
MAX8526 (http://www.maximintegrated.com/datasheet/index.mvp/id/4319) | 1.425V to 3.6V Input, 2A,0.2V Dropout LDO Regulators | FPGA | Positive | 1 | 1.4 | 3.6 | - | - | 0.5 | 3.4 | 0.1 | 2000 | 2000 | 0.6 | 500 | 800 | Yes | Yes | - | - | No | - | - | - | - | No | No | - | Yes | - | -40 to +85 | TSSOP-EP/14 | 33.2 | $2.17 @1k
MAX8527 (http://www.maximintegrated.com/datasheet/index.mvp/id/4319) | 1.425V to 3.6V Input, 2A,0.2V Dropout LDO Regulators | FPGA | Positive | 1 | 1.4 | 3.6 | - | - | 0.5 | 3.4 | 0.1 | 2000 | 2000 | 0.6 | 500 | 800 | Yes | Yes | - | - | No | POK | Open Drain Active Low | Vout-10% | - | No | No | - | Yes | - | -40 to +85 | TSSOP-EP/14 ,TSSOP/14 | 33.2 | $2.17 @1k
MAX8528 (http://www.maximintegrated.com/datasheet/index.mvp/id/4319) | 1.425V to 3.6V Input, 2A,0.2V Dropout LDO Regulators | FPGA | Positive | 1 | 1.4 | 3.6 | - | - | 0.5 | 3.4 | 0.1 | 2000 | 2000 | 0.6 | 500 | 800 | Yes | Yes | - | - | No | Reset | Open Drain Active Low | Vout-10% | 105 | No | No | - | Yes | - | -40 to +85 | TSSOP-EP/14 | 33.2 | $2.04 @1k
MAX8511 (http://www.maximintegrated.com/datasheet/index.mvp/id/3769) | High PSRR, Low-Dropout, 120 mA Linear Regulator in SC70 | - | Positive | 1 | 2 | 6 | 1.5 ,1.8 ,2.5 ,2.6 ,2.8 ,2.85 ,2.9 ,3.1 ,3.3 ,4.5 | 2.5 to 4.5 by 0.1 | - | - | 0.12 | 120 | 120 | 1 | 40 | 90 | Yes | Yes | 230 | No | No | - | - | - | - | No | No | - | Yes | - | -40 to +85 | SC-70/5 ,TDFN-EP/8 | 4.2 | $0.47 @1k
MAX8531 (http://www.maximintegrated.com/datasheet/index.mvp/id/3737) | Dual, Low-Noise, Low-Dropout Linear Regulators in UCSP or QFN | - | Positive | 2 | 2.5 | 6.5 | 2.85 ,3 | 1.5 to 3.3 by 0.05 | - | - | 0.22 | 200 | 200 | 1 | 130 | 220 | Yes | Yes | 40 | Yes | No | Reset | Open Drain Active Low | Vout-13% | 100 | No | No | Yes | Yes | - | -40 to +85 | UCSP/6 | 2 | $0.75 @1k
MAX8532 (http://www.maximintegrated.com/datasheet/index.mvp/id/3763) | Low-Noise, Low-Dropout, 200mA Linear Regulators in UCSP | - | Positive | 1 | 2.5 | 6.5 | 2.85 ,3 | 1.5 to 3.3 by 0.05 | - | - | 0.22 | 200 | 200 | 1 | 80 | 150 | Yes | Yes | 40 | Yes | No | - | - | - | - | No | No | Yes | Yes | - | -40 to +85 | UCSP/6 | 2 | $0.45 @1k
MAX8530 (http://www.maximintegrated.com/datasheet/index.mvp/id/3737) | Dual, Low-Dropout Linear Regulators with Reset in UCSP or QFN | - | Positive | 2 | 2.5 | 6.5 | 1.8 ,2.5 ,2.6 ,2.8 ,2.85 ,3 | 1.5 to 3.3 by 0.05 | - | - | 0.22 | 200 | 200 | 1 | 130 | 220 | Yes | Yes | 320 | No | No | Reset | Open Drain Active Low | Vout-13% | 100 | No | No | Yes | Yes | - | -40 to +85 | TDFN-EP/6 ,UCSP/6 ,WLP/6 | 2 | $0.75 @1k
MAX8512 (http://www.maximintegrated.com/datasheet/index.mvp/id/3769) | High PSRR, Low-Dropout, 120 mA Linear Regulator in SC70 | - | Positive | 1 | 2 | 6 | - | - | 1.5 | 4.5 | 0.12 | 120 | 120 | 1 | 40 | 90 | Yes | Yes | 230 | No | No | - | - | - | - | No | No | - | Yes | - | -40 to +85 | SC-70/5 ,TDFN-EP/8 | 4.2 | $0.52 @1k
MAX8559 (http://www.maximintegrated.com/datasheet/index.mvp/id/4169) | Dual, 300mA, Low-Noise Linear Regulators with Independent Shutdown in UCSP or TDFN | - | Positive | 2 | 2.5 | 6.5 | 1.5 ,1.8 ,1.85 ,2.5 ,2.6 ,2.8 ,2.85 ,2.9 ,3 ,3.3 | 1.5 to 3.3 by 0.05 | - | - | 0.2 | 300 | 300 | 1 | 180 | 290 | Yes | Yes | 32 | Yes | No | - | - | - | - | No | No | Yes | Yes | - | -40 to +85 | TDFN-EP/8 ,UCSP/8 | 2.2 | $0.86 @1k
MAX8510 (http://www.maximintegrated.com/datasheet/index.mvp/id/3769) | Ultra Low-Noise, High PSRR, Low-Dropout, 120 mA Linear Regulator in SC70 | - | Positive | 1 | 2 | 6 | 1.6 ,1.8 ,2.5 ,2.7 ,2.8 ,2.85 ,3 ,3.3 ,4.5 | 2.5 to 4.5 by 0.1 | - | - | 0.12 | 120 | 120 | 1 | 40 | 90 | Yes | Yes | 11 | Yes | No | - | - | - | - | No | No | - | Yes | - | -40 to +85 | SC-70/5 ,TDFN-EP/8 | 4.2 | $0.51 @1k
MAX5023 (http://www.maximintegrated.com/datasheet/index.mvp/id/3633) | 65V, Low Quiescent Current High Voltage Linear Regulator With uP Reset and Watchdog Timer | - | Positive | 1 | 6.5 | 65 | 3.3 ,5 | - | - | - | 0.9 | 150 | 150 | 4 | 140 | 140 | Yes | Yes | - | - | No | Reset | Open Drain Active Low | Vout-12.5% ,Vout-7.5% | 140 | Yes | No | - | Yes | Automotive - AECQ100 | -40 to +125 | SOIC(N)-EP/8 | 30.9 | $1.69 @1k
MAX5024 (http://www.maximintegrated.com/datasheet/index.mvp/id/3633) | 65V, Low Quiescent Current High Voltage Linear Regulator With uP Reset | - | Positive | 1 | 6.5 | 65 | 3.3 ,5 | - | 2.5 | 11 | 0.9 | 150 | 150 | 4 | 140 | 140 | Yes | Yes | - | - | No | Reset | Open Drain Active Low | Vout-12.5% ,Vout-7.5% | 140 | No | Yes | - | Yes | Automotive - AECQ100 | -40 to +85 ,-40 to +125 ,0 to +70 ,0 to +85 | SOIC(N)-EP/8 | 30.9 | $1.69 @1k
MAX6469 (http://www.maximintegrated.com/datasheet/index.mvp/id/3494) | 300mA LDO Linear Regulators with Internal µP Reset Circuit and Shutdown | - | Positive | 1 | 2.5 | 5.5 | 1.5 ,1.6 ,1.7 ,1.8 ,1.9 ,2 ,2.1 ,2.2 ,2.3 ,2.4 ,2.5 ,2.6 ,2.7 ,2.8 ,2.85 ,2.9 ,3 ,3.1 ,3.2 ,3.3 | - | - | - | 0.11 | 300 | 300 | 1.3 | 82 | 136 | Yes | Yes | 150 | No | No | Reset | Push-Pull Active Low | Vout-12.5% ,Vout-7.5% | 2.5 ,20 ,150 ,1200 | No | No | Yes | Yes | - | -40 to +85 | SOT/6 ,TDFN-EP/8 | 9 | $1.77 @1k
MAX6470 (http://www.maximintegrated.com/datasheet/index.mvp/id/3494) | 300mA LDO Linear Regulators with Internal µP Reset Circuit and Shutdown | - | Positive | 1 | 2.5 | 5.5 | 1.5 ,1.6 ,1.7 ,1.8 ,1.9 ,2 ,2.1 ,2.2 ,2.3 ,2.4 ,2.5 ,2.6 ,2.7 ,2.8 ,2.85 ,2.9 ,3 ,3.1 ,3.2 ,3.3 | - | - | - | 0.11 | 300 | 300 | 1.3 | 82 | 136 | Yes | Yes | 150 | No | No | Reset | Open Drain Active Low | Vout-12.5% ,Vout-7.5% | 2.5 ,20 ,150 ,1200 | No | No | Yes | Yes | - | -40 to +85 | SOT/6 ,TDFN-EP/8 | 9 | $3.61 @1k
MAX6471 (http://www.maximintegrated.com/datasheet/index.mvp/id/3494) | 300mA LDO Linear Regulators with Internal µP Reset Circuit and Manual Reset | - | Positive | 1 | 2.5 | 5.5 | 1.5 ,1.6 ,1.7 ,1.8 ,1.9 ,2 ,2.1 ,2.2 ,2.3 ,2.4 ,2.5 ,2.6 ,2.7 ,2.8 ,2.85 ,2.9 ,3 ,3.1 ,3.2 ,3.3 | - | - | - | 0.11 | 300 | 300 | 1.3 | 82 | 136 | Yes | No | 150 | No | No | Reset | Push-Pull Active Low | Vout-12.5% ,Vout-7.5% | 2.5 ,20 ,150 ,1200 | No | No | Yes | Yes | - | -40 to +85 | SOT/6 ,TDFN-EP/8 | 9 | $1.77 @1k
MAX6472 (http://www.maximintegrated.com/datasheet/index.mvp/id/3494) | 300mA LDO Linear Regulators with Internal µP Reset Circuit and Shutdown | - | Positive | 1 | 2.5 | 5.5 | 1.5 ,1.6 ,1.7 ,1.8 ,1.9 ,2 ,2.1 ,2.2 ,2.3 ,2.4 ,2.5 ,2.6 ,2.7 ,2.8 ,2.85 ,2.9 ,3 ,3.1 ,3.2 ,3.3 | - | - | - | 0.11 | 300 | 300 | 1.3 | 82 | 136 | Yes | No | 150 | No | No | Reset | Open Drain Active Low | Vout-12.5% ,Vout-7.5% | 2.5 ,20 ,150 ,1200 | No | No | Yes | Yes | - | -40 to +85 | SOT/6 ,TDFN-EP/8 | 9 | $1.77 @1k
MAX6473 (http://www.maximintegrated.com/datasheet/index.mvp/id/3494) | 300mA LDO Linear Regulators with Internal µP Reset Circuit, Shutdown and Manual Reset | - | Positive | 1 | 2.5 | 5.5 | 1.5 ,1.6 ,1.7 ,1.8 ,1.9 ,2 ,2.1 ,2.2 ,2.3 ,2.4 ,2.5 ,2.6 ,2.7 ,2.8 ,2.85 ,2.9 ,3 ,3.1 ,3.2 ,3.3 | - | - | - | 0.11 | 300 | 300 | 1.3 | 82 | 136 | Yes | Yes | 150 | No | No | Reset | Push-Pull Active Low | Vout-12.5% ,Vout-7.5% | 2.5 ,20 ,150 ,1200 | No | No | Yes | Yes | - | -40 to +85 | SOT/6 ,TDFN-EP/8 | 9 | $1.77 @1k
MAX6474 (http://www.maximintegrated.com/datasheet/index.mvp/id/3494) | 300mA LDO Linear Regulators with Internal µP Reset Circuit, Shutdown and Manual Reset | - | Positive | 1 | 2.5 | 5.5 | 1.5 ,1.6 ,1.7 ,1.8 ,1.9 ,2 ,2.1 ,2.2 ,2.3 ,2.4 ,2.5 ,2.6 ,2.7 ,2.8 ,2.85 ,2.9 ,3 ,3.1 ,3.2 ,3.3 | - | - | - | 0.11 | 300 | 300 | 1.3 | 82 | 136 | Yes | Yes | 150 | No | No | Reset | Open Drain Active Low | Vout-12.5% ,Vout-7.5% | 2.5 ,20 ,150 ,1200 | No | No | Yes | Yes | - | -40 to +85 | SOT/6 ,TDFN-EP/8 | 9 | $1.77 @1k
MAX6475 (http://www.maximintegrated.com/datasheet/index.mvp/id/3494) | 300mA LDO Linear Regulators with Internal µP Reset Circuit, Shutdown and Feedback Input | - | Positive | 1 | 2.5 | 5.5 | 1.5 ,1.6 ,1.7 ,1.8 ,1.9 ,2 ,2.1 ,2.2 ,2.3 ,2.4 ,2.5 ,2.6 ,2.7 ,2.8 ,2.85 ,2.9 ,3 ,3.1 ,3.2 ,3.3 | - | 1.23 | 5 | 0.11 | 300 | 300 | 1.3 | 82 | 136 | Yes | Yes | 150 | No | No | Reset | Push-Pull Active Low | Vout-12.5% ,Vout-7.5% | 2.5 ,20 ,150 ,1200 | No | No | Yes | Yes | - | -40 to +85 | SOT/6 ,TDFN-EP/8 | 9 | $1.77 @1k
MAX6476 (http://www.maximintegrated.com/datasheet/index.mvp/id/3494) | 300mA LDO Linear Regulators with Internal µP Reset Circuit, Shutdown and Feedback Input | - | Positive | 1 | 2.5 | 5.5 | 1.5 ,1.6 ,1.7 ,1.8 ,1.9 ,2 ,2.1 ,2.2 ,2.3 ,2.4 ,2.5 ,2.6 ,2.7 ,2.8 ,2.85 ,2.9 ,3 ,3.1 ,3.2 ,3.3 | - | 1.23 | 5 | 0.11 | 300 | 300 | 1.3 | 82 | 136 | Yes | Yes | 150 | No | No | Reset | Open Drain Active Low | Vout-12.5% ,Vout-7.5% | 2.5 ,20 ,150 ,1200 | No | No | Yes | Yes | - | -40 to +85 | SOT/6 ,TDFN-EP/8 | 9 | $1.77 @1k
MAX6478 (http://www.maximintegrated.com/datasheet/index.mvp/id/3494) | 300mA LDO Linear Regulators with Internal µP Reset Circuit and Shutdown | - | Positive | 1 | 2.5 | 5.5 | 1.5 ,1.6 ,1.7 ,1.8 ,1.9 ,2 ,2.1 ,2.2 ,2.3 ,2.4 ,2.5 ,2.6 ,2.7 ,2.8 ,2.85 ,2.9 ,3 ,3.1 ,3.2 ,3.3 | - | - | - | 0.11 | 300 | 300 | 1.1 | 82 | 136 | Yes | Yes | 75 | No | No | Reset | Open Drain Active Low | Vout-12.5% ,Vout-7.5% | 2.5 ,20 ,150 ,1200 | No | No | - | Yes | - | -40 to +85 | UCSP/9 | 2.5 | $1.77 @1k
MAX1983 (http://www.maximintegrated.com/datasheet/index.mvp/id/3518) | Adjustable Low-Voltage, Low-Dropout Linear Regulator with External Bias Supply | FPGA | Positive | 1 | 1.25 | 5.5 | - | - | 0.8 | 2 | 0.35 | 300 | 300 | 3 | 140 | 250 | Yes | Yes | 65 | No | No | - | - | - | - | No | No | Yes | Yes | - | -40 to +85 | SOT/6 | 9 | $0.99 @1k
MAX1982 (http://www.maximintegrated.com/datasheet/index.mvp/id/3518) | Fixed 1.2V Output Low-Voltage, Low-Dropout Linear Regulator with External Bias Supply | - | Positive | 1 | 1.25 | 5.5 | 1.2 | - | - | - | 0.35 | 300 | 300 | 3 | 140 | 250 | Yes | Yes | 65 | No | No | Reset | Open Drain Active Low | Vout-9% | 1 | No | No | Yes | Yes | - | -40 to +85 | SOT/6 | 9 | $1.35 @1k
MAX1819 (http://www.maximintegrated.com/datasheet/index.mvp/id/3345) | 500mA Low-Dropout Linear Regulator in UCSP | - | Positive | 1 | 2.5 | 5.5 | 1.5 ,1.8 ,2 ,2.5 ,3.3 ,5 | - | 1.25 | 5 | 0.125 | 500 | 500 | 1 | 125 | 250 | Yes | Yes | 115 | No | No | POK | Open Drain Active Low | Vout-7% | - | No | No | - | Yes | - | -40 to +85 | UCSP/9 | 2.5 | -
MAX1935 (http://www.maximintegrated.com/datasheet/index.mvp/id/3630) | 500mA, Low Voltage LDO Tiny QFN | - | Positive | 1 | 2.25 | 5.5 | 1.5 | 1.5 to 4.5 by 0.1 | 0.8 | 4.5 | 0.175 | 500 | 500 | 2.5 | 200 | 600 | Yes | Yes | 300 | No | No | POK | Open Drain Active Low | Vout-7% | - | No | No | - | Yes | - | -40 to +85 | TDFN-EP/8 | 9.6 | $1.00 @1k
MAX6349 (http://www.maximintegrated.com/datasheet/index.mvp/id/2484) | 150mA, SOT23, Low Dropout Linear regulators with Internal Microprocessor Reset Circuit and Manual Reset | - | Positive | 1 | 2.5 | 5.5 | 1.8 ,2.5 ,3.3 | - | 1.23 | 5 | 0.3 | 150 | 150 | 3 | 25 | 50 | Yes | No | - | - | No | Reset | Open Drain Active High ,Push-Pull Active High ,Push-Pull Active Low | Vout-10% ,Vout-5% | 100 | No | No | - | Yes | - | -40 to +85 | SOT/6 | 9 | $1.99 @1k
MAX6329 (http://www.maximintegrated.com/datasheet/index.mvp/id/2484) | 150mA, SOT23, Low Dropout Linear regulators with Internal Microprocessor Reset Circuit and Shutdown | - | Positive | 1 | 2.5 | 5.5 | 1.8 ,2.5 ,3.3 | - | 1.23 | 5 | 0.3 | 150 | 150 | 3 | 25 | 50 | Yes | Yes | - | - | No | Reset | Open Drain Active High ,Push-Pull Active High ,Push-Pull Active Low | Vout-10% ,Vout-5% | 100 | No | No | - | Yes | - | 0 to +85 | SOT/6 | 9 | $1.77 @1k
MAX1806 (http://www.maximintegrated.com/datasheet/index.mvp/id/2996) | 500mA Low-Dropout Linear Regulator in µMAX, Short-Circuit and Thermal Protected | - | Positive | 1 | 2.25 | 5.5 | 0.8 ,1.5 ,1.8 ,2.5 ,3.3 | - | 0.8 | 4.5 | 0.17 | 500 | 500 | 1 | 210 | 400 | Yes | Yes | 300 | No | No | POK | Open Drain Active Low | Vout-7% | - | No | No | - | Yes | - | -40 to +85 | µMAX-EP/8 | 15.3 | $1.50 @1k
MAX8867 (http://www.maximintegrated.com/datasheet/index.mvp/id/1804) | Low-Noise, Low-Dropout, 150mA Linear Regulator in SOT23 Package | - | Positive | 1 | 2.5 | 5.5 | 2.5 ,2.8 ,2.84 ,3 ,3.15 ,3.3 ,3.6 ,5 | - | - | - | 0.16 | 150 | 150 | 1.4 | 85 | 180 | Yes | Yes | 20 | Yes | No | - | - | - | - | No | Yes | - | Yes | - | -40 to +85 | SOT/5 ,TSOT/5 | 8.3 | $0.77 @1k
MAX8868 (http://www.maximintegrated.com/datasheet/index.mvp/id/1804) | Low-Noise, Low-Dropout, 150mA Linear Regulator in SOT23 Package with Auto-Discharge | - | Positive | 1 | 2.5 | 5.5 | 2.5 ,2.8 ,2.84 ,3 ,3.15 ,3.3 ,3.6 ,5 | - | - | - | 0.16 | 150 | 150 | 1.4 | 85 | 180 | Yes | Yes | 20 | Yes | No | - | - | - | - | No | Yes | - | Yes | - | -40 to +85 | SOT/5 ,TSOT/5 | 8.3 | $0.77 @1k
MAX603 (http://www.maximintegrated.com/datasheet/index.mvp/id/1131) | 5V or Adjustable, Low-Dropout, Low-IQ, 500mA Linear Regulators | - | Positive | 1 | 2.7 | 11.5 | 5 | - | 1.3 | 11.5 | 0.32 | 500 | 500 | 3 | 25 | 50 | Yes | No | - | - | No | - | - | - | - | No | No | - | Yes | - | 0 to +70 | PDIP(N)/8 ,SOIC(N)/8 | 31 | $1.86 @1k
MAX8866 (http://www.maximintegrated.com/datasheet/index.mvp/id/1263) | Dual, Low-Dropout, 100mA Linear Regulator with Auto-Discharge | - | Positive | 2 | 2.5 | 5.5 | 2.8 ,2.84 ,3.15 | - | 1.5 | 5.5 | 0.11 | 100 | 100 | 2.5 | 105 | 270 | Yes | Yes | 220 | No | No | - | - | - | - | No | Yes | - | Yes | - | -40 to +85 | µMAX/8 | 15.6 | $1.21 @1k
MAX8865 (http://www.maximintegrated.com/datasheet/index.mvp/id/1263) | Dual, Low-Dropout, 100mA Linear Regulator | - | Positive | 2 | 2.5 | 5.5 | 2.8 ,2.84 ,3.15 | - | 1.3 | 5.5 | 0.11 | 100 | 100 | 2.5 | 105 | 270 | Yes | Yes | 220 | No | No | - | - | - | - | No | Yes | - | Yes | - | -40 to +85 | µMAX/8 | 15.6 | $1.21 @1k
MAX8864 (http://www.maximintegrated.com/datasheet/index.mvp/id/1175) | Low-Dropout, 100mA Linear Regulator with Auto-Discharge | - | Positive | 1 | 2.5 | 5.5 | 2.8 ,2.84 ,3.15 | - | 1.25 | 5.5 | 0.13 | 120 | 120 | 3.5 | 70 | 170 | Yes | Yes | 220 | No | No | - | - | - | - | No | Yes | - | Yes | - | -40 to +85 | SOT/5 | 9 | $0.71 @1k
MAX8873 (http://www.maximintegrated.com/datasheet/index.mvp/id/1739) | Low-Dropout, 120mA LInear Regulator | - | Positive | 1 | 2.5 | 6.5 | 2.8 ,2.84 ,3.15 | - | - | - | 0.13 | 120 | 120 | 3 | 73 | 150 | Yes | Yes | 220 | No | No | - | - | - | - | No | Yes | - | Yes | - | -40 to +85 | SOT/5 | 9 | $0.71 @1k
MAX8874 (http://www.maximintegrated.com/datasheet/index.mvp/id/1739) | Low-Dropout, 120mA LInear Regulator with Auto Discharge | - | Positive | 1 | 2.5 | 6.5 | 2.8 ,2.84 ,3.15 | - | - | - | 0.13 | 120 | 120 | 3 | 73 | 150 | Yes | Yes | 220 | No | No | - | - | - | - | No | Yes | - | Yes | - | -40 to +85 | SOT/5 | 9 | $0.71 @1k
MAX8863 (http://www.maximintegrated.com/datasheet/index.mvp/id/1175) | Low-Dropout, 100mA Linear Regulator | - | Positive | 1 | 2.5 | 5.5 | 2.8 ,2.84 ,3.15 | - | 1.25 | 5.5 | 0.13 | 120 | 120 | 3.5 | 70 | 170 | Yes | Yes | 220 | No | No | - | - | - | - | No | Yes | - | Yes | - | -40 to +85 | SOT/5 | 9 | $0.71 @1k
MAX8878 (http://www.maximintegrated.com/datasheet/index.mvp/id/1806) | Low-Noise, Low-Dropout, 150 mA Linear Regulator with '2982 Pinout and Auto-Discharge | - | Positive | 1 | 2.5 | 6.5 | 1.5 ,1.8 ,2.5 ,2.8 ,2.84 ,3 ,3.15 ,3.3 ,3.6 ,5 | - | - | - | 0.16 | 150 | 150 | 1.4 | 85 | 180 | Yes | Yes | 20 | Yes | No | - | - | - | - | No | Yes | - | Yes | - | -40 to +85 | SOT/5 ,TSOT/5 | 8.3 | $0.77 @1k
MAX1857 (http://www.maximintegrated.com/datasheet/index.mvp/id/2385) | 500mA Low-Dropout, Ripple-Rejecting LDO in µMAX, Output Current Limited and Thermal Protected | - | Positive | 1 | 2.5 | 5.5 | 4.75 | - | 1.25 | 5 | 0.12 | 500 | 500 | 1 | 135 | 250 | Yes | Yes | 115 | No | No | Reset | Open Drain Active Low | Vout-14% | 1.4 | No | No | - | Yes | - | -40 to +85 | µMAX/8 | 15.6 | $1.08 @1k
MAX8877 (http://www.maximintegrated.com/datasheet/index.mvp/id/1806) | Low-Noise, Low-Dropout, 150 mA Linear Regulator with '2982 Pinout | - | Positive | 1 | 2.5 | 6.5 | 1.5 ,1.8 ,2.5 ,2.8 ,2.84 ,3 ,3.15 ,3.3 ,3.6 ,5 | - | - | - | 0.16 | 150 | 150 | 1.4 | 85 | 180 | Yes | Yes | 20 | Yes | No | - | - | - | - | No | Yes | - | Yes | - | -40 to +85 | SOT/5 ,TSOT/5 | 8.3 | $0.77 @1k
MAX8887 (http://www.maximintegrated.com/datasheet/index.mvp/id/2446) | Low-Dropout, 300mA Linear Regulator in SOT23 | - | Positive | 1 | 2.5 | 5.5 | 1.5 ,1.8 ,2.85 ,3.3 | - | - | - | 0.15 | 300 | 300 | 2 | 55 | 100 | Yes | Yes | 42 | Yes | No | - | - | - | - | No | No | - | Yes | - | -40 to +85 | TSOT/5 | 8.3 | $0.84 @1k
MAX8888 (http://www.maximintegrated.com/datasheet/index.mvp/id/2446) | Low-Dropout, Low-Noise, 300mA Linear Regulator in SOT23 | - | Positive | 1 | 2.5 | 5.5 | 1.5 ,1.8 ,2.85 ,3.3 | - | - | - | 0.15 | 300 | 300 | 2 | 55 | 100 | Yes | Yes | 360 | No | No | POK | Open Drain Active Low | Vout-5% | - | No | No | - | Yes | Automotive - AECQ100 | -40 to +85 | TSOT/5 | 8.3 | $0.84 @1k
MAX8875 (http://www.maximintegrated.com/datasheet/index.mvp/id/2125) | 150mA, Low-Dropout Linear Regulator with Power-OK Output | - | Positive | 1 | 2.5 | 6.5 | 1.5 ,2.5 ,2.7 ,3 ,3.3 ,5 | - | - | - | 0.16 | 150 | 150 | 1 | 85 | 180 | Yes | Yes | 170 | No | Yes | POK | Open Drain Active Low | Vout-10.5% | - | No | Yes | - | Yes | - | -40 to +85 | SOT/5 | 9 | $0.77 @1k
MAX1818 (http://www.maximintegrated.com/datasheet/index.mvp/id/2383) | 500mA Low-Dropout Linear Regulator in SOT23, Output Current Limited and Thermal Protected | - | Positive | 1 | 2.5 | 5.5 | 1.5 ,1.8 ,2 ,2.5 ,3.3 ,5 | - | 1.25 | 5 | 0.12 | 500 | 500 | 1 | 125 | 250 | Yes | Yes | 115 | No | No | POK | Open Drain Active Low | Vout-7% | - | No | No | Yes | Yes | - | -40 to +85 | SOT/6 | 9 | $1.15 @1k
MAX1793 (http://www.maximintegrated.com/datasheet/index.mvp/id/2223) | Low-Dropout, Low Iq, 1A Linear Regulator | - | Positive | 1 | 2.5 | 5.5 | 2.5 ,3.3 | - | 1.25 | 5 | 0.21 | 1000 | 1000 | 1 | 125 | 200 | Yes | Yes | 115 | No | No | Reset | Open Drain Active Low | Vout-6% | 1.5 | No | No | - | Yes | Automotive - AECQ100 | -40 to +85 | TSSOP-EP/16 | 33.2 | $1.50 @1k
MAX8883 (http://www.maximintegrated.com/datasheet/index.mvp/id/2410) | Dual, Low-Noise, Low-Dropout, 160mA Linear Regulators in SOT23 | - | Positive | 2 | 2.5 | 6.5 | 1.8 ,2.5 ,2.85 ,3.3 | - | - | - | 0.15 | 160 | 160 | 1 | 165 | 265 | Yes | Yes | 320 | No | No | - | - | - | - | No | No | - | Yes | - | -40 to +85 | SOT/6 | 9 | $0.71 @1k
MAX8882 (http://www.maximintegrated.com/datasheet/index.mvp/id/2410) | Dual, Low-Noise, Low-Dropout, 160mA Linear Regulators in SOT23 | - | Positive | 2 | 2.5 | 6.5 | 1.8 ,2.5 ,2.85 ,3.3 | - | - | - | 0.15 | 160 | 160 | 1 | 165 | 265 | Yes | Yes | 40 | Yes | No | - | - | - | - | No | No | - | Yes | - | -40 to +85 | SOT/6 | 9 | $1.26 @1k
MAX6331 (http://www.maximintegrated.com/datasheet/index.mvp/id/1863) | Precision Shunt Regulator with Push-Pull RESET in SOT23-3 | - | Positive | 1 | 3 | 200 | 3 ,3.3 ,5 | - | - | - | 0 | 50 | 50 | 1.5 | 60 | 100 | Yes | No | - | - | No | Reset | Push-Pull Active High | Vout-7.5% | 100 | No | No | - | Yes | - | -40 to +85 | SOT/3 | 8 | $1.40 @1k
MAX6330 (http://www.maximintegrated.com/datasheet/index.mvp/id/1863) | Precision Shunt Regulator with Push-Pull /RESET in SOT23-3 | - | Positive | 1 | 3 | 200 | 3 ,3.3 ,5 | - | - | - | 0 | 50 | 50 | 1.5 | 60 | 100 | Yes | No | - | - | No | Reset | Push-Pull Active Low | Vout-7.5% | 100 | No | No | - | Yes | - | -40 to +85 | SOT/3 | 8 | $1.42 @1k
MAX1792 (http://www.maximintegrated.com/datasheet/index.mvp/id/2355) | 500mA Low-Dropout Linear Regulator in µMAX, Short-Circuit and Thermal Protected | - | Positive | 1 | 2.5 | 5.5 | 1.5 ,1.8 ,2.5 ,3.3 ,5 | - | 1.25 | 5 | 0.13 | 500 | 500 | 1 | 80 | 250 | Yes | Yes | 115 | No | No | - | - | - | - | No | No | - | Yes | Automotive - AECQ100 | -40 to +85 | µMAX-EP/8 | 15.3 | $1.15 @1k
MAX8869 (http://www.maximintegrated.com/datasheet/index.mvp/id/2340) | 1A, MicroCap, Low-Dropout, Linear Regulator | FPGA | Positive | 1 | 2.7 | 5.5 | 1 ,1.8 ,2.5 ,3.3 ,5 | - | 0.8 | 5 | 0.2 | 1000 | 1000 | 1 | 500 | 2000 | Yes | Yes | 150 | No | No | Reset | Open Drain Active Low | Vout-8% | 1 | No | No | - | Yes | - | -40 to +85 | TSSOP-EP/16 | 33.2 | $2.69 @1k
MAX1735 (http://www.maximintegrated.com/datasheet/index.mvp/id/2333) | 200mA, Negative-Output, Low-Dropout Linear Regulator in SOT23 | - | Negative | 1 | -2.5 | -6.5 | -5.0 ,-3.0 ,-2.5 | - | -1.25 | -5.5 | 0.08 | 200 | 200 | 3 | 85 | 180 | Yes | Yes | 160 | No | No | - | - | - | - | No | No | - | Yes | - | -40 to +85 | SOT/5 | 9 | $1.10 @1k
MAX8881 (http://www.maximintegrated.com/datasheet/index.mvp/id/2301) | 12V, Ultra-Low Iq, Low-Dropout Linear Regulator with Power-OK Output | - | Positive | 1 | 2.5 | 12 | 1.8 ,2.5 ,3.3 ,5 | - | - | - | 0.36 | 200 | 200 | 1.5 | 3.5 | 10 | Yes | Yes | 300 | No | No | POK | Open Drain Active Low | Vout-9.5% | - | No | Yes | - | Yes | - | -40 to +85 | SOT/6 | 9 | $0.86 @1k
MAX8880 (http://www.maximintegrated.com/datasheet/index.mvp/id/2301) | 12V, Ultra-Low Iq, Low-Dropout Linear Regulator with Power-OK Output | - | Positive | 1 | 2.5 | 12 | - | - | 1.25 | 5 | 0.36 | 200 | 200 | 1.5 | 3.5 | 10 | Yes | Yes | 300 | No | No | POK | Open Drain Active Low | Vout-9.5% | - | No | Yes | - | Yes | Automotive - AECQ100 | -40 to +85 | SOT/6 ,TDFN-EP/6 | 9 | $0.86 @1k
MAX1725 (http://www.maximintegrated.com/datasheet/index.mvp/id/2290) | 12V, Ultra-Low Iq, Low-Dropout Linear Regulators | - | Positive | 1 | 2.5 | 12 | - | - | 1.5 | 5 | 0.3 | 20 | 20 | 1.5 | 2 | 4.5 | Yes | Yes | 350 | No | No | - | - | - | - | No | Yes | - | Yes | - | -40 to +85 | SOT/5 | 9 | $0.82 @1k
MAX1726 (http://www.maximintegrated.com/datasheet/index.mvp/id/2290) | 12V, Ultra-Low Iq, Low-Dropout Linear Regulators | - | Positive | 1 | 2.5 | 12 | 1.8 ,2.5 ,3.3 ,5 | - | - | - | 0.3 | 20 | 20 | 1.5 | 2 | 4.5 | Yes | Yes | 350 | No | No | - | - | - | - | No | Yes | - | Yes | - | -40 to +85 | SOT/5 | 9 | $0.82 @1k
MAX883 (http://www.maximintegrated.com/datasheet/index.mvp/id/1214) | 5V or Adjustable, Low-Dropout, Low IQ, 200mA Linear Regulator with Shutdown Mode | - | Positive | 1 | 2.7 | 11.5 | 5 | - | 1.25 | 11 | 0.22 | 200 | 200 | 5 | 11 | 15 | Yes | Yes | 250 | No | Yes | - | - | - | - | No | No | - | Yes | - | -40 to +85 ,0 to +70 | PDIP(N)/8 ,SOIC(N)/8 | 31 | $1.72 @1k
MAX884 (http://www.maximintegrated.com/datasheet/index.mvp/id/1214) | 3.3V or Adjustable, Low-Dropout, Low IQ, 200mA Linear Regulator with Shutdown Mode | - | Positive | 1 | 2.7 | 11.5 | 3.3 | - | 1.25 | 11 | 0.32 | 200 | 200 | 5 | 11 | 15 | Yes | Yes | 250 | No | Yes | - | - | - | - | No | No | - | Yes | - | -40 to +85 ,0 to +70 | PDIP(N)/8 ,SOIC(N)/8 | 31 | $2.24 @1k
MAX882 (http://www.maximintegrated.com/datasheet/index.mvp/id/1214) | 3.3V or Adjustable, Low-Dropout, Low IQ, 200mA Linear Regulator with Standby Mode | - | Positive | 1 | 2.7 | 11.5 | 3.3 | - | 1.25 | 11 | 0.32 | 200 | 200 | 5 | 11 | 15 | Yes | No | 250 | No | Yes | - | - | - | - | No | No | - | Yes | - | -40 to +85 ,0 to +70 | PDIP(N)/8 ,SOIC(N)/8 | 31 | $1.72 @1k
MAX1798 (http://www.maximintegrated.com/datasheet/index.mvp/id/2276) | CDMA Cellular/PCS System Power Supplies | - | Positive | 5 | 2.5 | 5.5 | - | - | 1.8 | 3.3 | 0.12 | 300 | 300 | 2 | 367 | 680 | Yes | Yes | 45 | Yes | No | Reset | Push-Pull Active Low | Vout-13% ,Vout-7.5% | 140 | No | No | Yes | Yes | - | -40 to +85 | QFN/20 ,TSSOP-EP/20 | 26 | -
MAX1799 (http://www.maximintegrated.com/datasheet/index.mvp/id/2276) | CDMA Cellular/PCS System Power Supplies | - | Positive | 5 | 2.5 | 5.5 | - | - | 1.8 | 3.3 | 0.12 | 300 | 300 | 2 | 367 | 680 | Yes | Yes | 45 | Yes | No | Reset | Push-Pull Active Low | Vout-13% ,Vout-7.5% | 140 | No | No | Yes | Yes | - | -40 to +85 | QFN/20 ,TQFN/20 ,TSSOP-EP/20 | 26 | -
MAX8860 (http://www.maximintegrated.com/datasheet/index.mvp/id/1966) | Low-Dropout, 300mA Linear Regulator in µMAX | - | Positive | 1 | 2.5 | 6.5 | 1.8 ,2.5 ,2.77 ,2.82 ,3 ,3.3 | - | 1.25 | 6.5 | 0.15 | 300 | 300 | 1.4 | 120 | 270 | Yes | Yes | 55 | No | No | POK | Open Drain Active Low | Vout-4% | - | No | Yes | - | Yes | - | -40 to +85 | µMAX/8 | 15.6 | $0.88 @1k
MAX8885 (http://www.maximintegrated.com/datasheet/index.mvp/id/2139) | 150mA, Low-Dropout Linear Regulator with Power-OK Output | - | Positive | 1 | 2.5 | 6.5 | 2.5 ,2.7 ,3 ,3.3 ,5 | 2.5 to 5.0 by 0.1 | - | - | 0.16 | 150 | 150 | 1 | 85 | 180 | Yes | Yes | 170 | No | No | POK | Open Drain Active Low | Vout-5% | - | No | Yes | - | Yes | - | -40 to +85 | SOT/5 | 9 | $0.77 @1k
MAX1749 (http://www.maximintegrated.com/datasheet/index.mvp/id/2007) | SOT23 Vibrator Motor Driver | - | Positive | 1 | 2.5 | 6.5 | 1.25 | - | 1.25 | 6.5 | 0.13 | 120 | 120 | 10 | 80 | 200 | Yes | Yes | - | - | No | - | - | - | - | No | Yes | - | Yes | - | -40 to +85 | SOT/5 | 9 | $1.41 @1k
MAX663 (http://www.maximintegrated.com/datasheet/index.mvp/id/1330) | CMOS, 5V/Adjustable, Micropower, Positive Linear Regulator | - | Positive | 1 | 2 | 16.5 | 5 | - | 1.3 | 16 | 0.9 | 40 | 40 | 5 | 6 | 12 | Yes | Yes | - | - | No | - | - | - | - | No | No | - | Yes | MIL-STD-883B | -40 to +85 ,0 to +70 | CDIP(N)/8 ,PDIP(N)/8 ,SOIC(N)/8 | 30.9 | $1.71 @1k
MAX664 (http://www.maximintegrated.com/datasheet/index.mvp/id/1330) | CMOS, -5V/Adjustable, Micropower, Negative Linear Regulator | - | Negative | 1 | -2 | -16.5 | -5 | - | -1.3 | -15 | 0.35 | 40 | 40 | 5 | 6 | 12 | Yes | Yes | - | - | No | - | - | - | - | No | No | - | Yes | MIL-STD-883B | -40 to +85 ,0 to +70 | CDIP(N)/8 ,PDIP(N)/8 ,SOIC(N)/8 | 30.9 | $1.75 @1k
MAX666 (http://www.maximintegrated.com/datasheet/index.mvp/id/1330) | 5V/Adjustable, Micropower, Positive Linear Regulator with Low-Battery Detect | - | Positive | 1 | 2 | 16.5 | 5 | - | 1.3 | 15 | 0.9 | 40 | 40 | 5 | 6 | 12 | Yes | Yes | - | - | Yes | - | - | - | - | No | No | - | Yes | MIL-STD-883B | -40 to +85 ,0 to +70 | CDIP(N)/8 ,PDIP(N)/8 ,SOIC(N)/8 | 30.9 | $1.76 @1k
ICL7663A (http://www.maximintegrated.com/datasheet/index.mvp/id/1358) | Low-Power, Adjustable-Output, Positive-Voltage Linear Regulator (More accurate ICL7663) | - | Positive | 1 | 2 | 16 | - | - | 1.3 | 16 | 0.9 | 40 | 40 | 1.9 | 3.5 | 10 | Yes | Yes | - | - | No | - | - | - | - | No | No | - | Yes | - | -40 to +85 ,-20 to +85 ,0 to +70 | CDIP(N)/8 ,PDIP(N)/8 ,SOIC(N)/8 ,TO99/8 | 30.9 | $1.88 @1k
ICL7663 (http://www.maximintegrated.com/datasheet/index.mvp/id/1358) | Low-Power, Adjustable-Output, Positive-Voltage Linear Regulator | - | Positive | 1 | 1.5 | 16 | - | - | 1.3 | 16 | 0.9 | 40 | 40 | 8 | 3.5 | 10 | Yes | Yes | - | - | No | - | - | - | - | No | No | - | Yes | - | -40 to +85 ,-20 to +85 ,0 to +70 | CDIP(N)/8 ,PDIP(N)/8 ,SOIC(N)/8 ,TO99/8 | 30.9 | $1.88 @1k
MAX1616 (http://www.maximintegrated.com/datasheet/index.mvp/id/1694) | High-Voltage, Low-Power, Adjustable-Output Linear Regulator for Notebook Computers | - | Positive | 1 | 4 | 28 | - | - | 1.24 | 28 | 0.35 | 30 | 30 | 2 | 6.2 | 8 | Yes | Yes | - | - | No | - | - | - | - | No | No | - | Yes | - | -40 to +85 | SOT/5 | 9 | $1.31 @1k
MAX1615 (http://www.maximintegrated.com/datasheet/index.mvp/id/1694) | High-Voltage, Low Power Linear Regulator for Notebook Computers | - | Positive | 1 | 4 | 28 | - | - | 3.3 | 5 | 0.35 | 30 | 30 | 2 | 6.2 | 8 | Yes | Yes | - | - | No | - | - | - | - | No | No | - | Yes | - | -40 to +85 | SOT/5 | 9 | $1.31 @1k
MAX667 (http://www.maximintegrated.com/datasheet/index.mvp/id/1143) | 5V/Programmable, Low-Dropout Voltage Regulator | - | Positive | 1 | 3.5 | 16.5 | 5 | - | 1.3 | 15 | 0.19 | 250 | 250 | 4 | 20 | 25 | Yes | Yes | - | - | Yes | POK | Open Drain Active Low | - | - | No | No | - | Yes | MIL-STD-883B | -40 to +85 ,0 to +70 | CDIP(N)/8 ,PDIP(N)/8 ,SOIC(N)/8 | 30.9 | $2.35 @1k
MAX1659 (http://www.maximintegrated.com/datasheet/index.mvp/id/1755) | 5V-Output, 16.5V-Input, 350mA, Low-Dropout Linear Regulator | - | Positive | 1 | 2.7 | 16.5 | 5 | - | 1.25 | 16 | 0.65 | 350 | 350 | 3 | 30 | 60 | Yes | Yes | 2500 | No | No | - | - | - | - | No | Yes | - | Yes | - | -40 to +85 | SOIC(N)/8 | 31 | $2.17 @1k
MAX1658 (http://www.maximintegrated.com/datasheet/index.mvp/id/1755) | 3.3V-Output, 16.5V-Input, 350mA, Low-Dropout Linear Regulator | - | Positive | 1 | 2.7 | 16.5 | 3.3 | - | 1.25 | 16 | 0.65 | 350 | 350 | 3 | 30 | 60 | Yes | Yes | 2500 | No | No | - | - | - | - | No | Yes | - | Yes | - | -40 to +85 | SOIC(N)/8 | 31 | $2.17 @1k
MAX604 (http://www.maximintegrated.com/datasheet/index.mvp/id/1131) | 3.3V or Adjustable, Low-Dropout, Low IQ, 500mA Linear Regulator | - | Positive | 1 | 2.7 | 11.5 | 3.3 | - | 1.3 | 11.5 | 0.6 | 500 | 500 | 5 | 15 | 35 | Yes | Yes | - | - | No | - | - | - | - | No | No | - | Yes | - | -40 to +85 ,0 to +70 | PDIP(N)/8 ,SOIC(N)/8 | 31 | $1.86 @1k
