rlhahn/power_distro/SolidModels/3_5mm_5_08mm_adapter.dxf

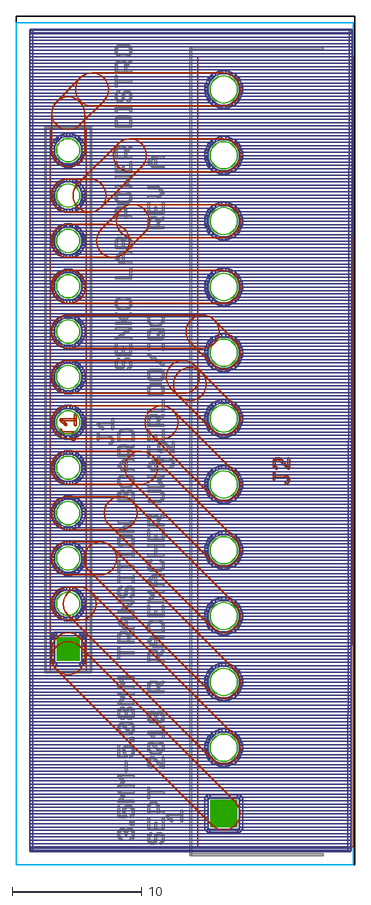
[picture p10: CAD file, 2018-11-13]
SolidModels/3_5mm_5_08mm_adapter.dxf
26.1 x 65.5
