rlhahn/power_distro/SolidModels/HolePattern.dxf

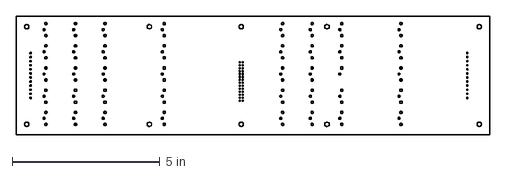
[picture p11: CAD file, 2018-06-27]
SolidModels/HolePattern.dxf
16.0 x 4.00 in
