rlhahn/power_distro/SolidModels/keystone-PN1608-2.STEP

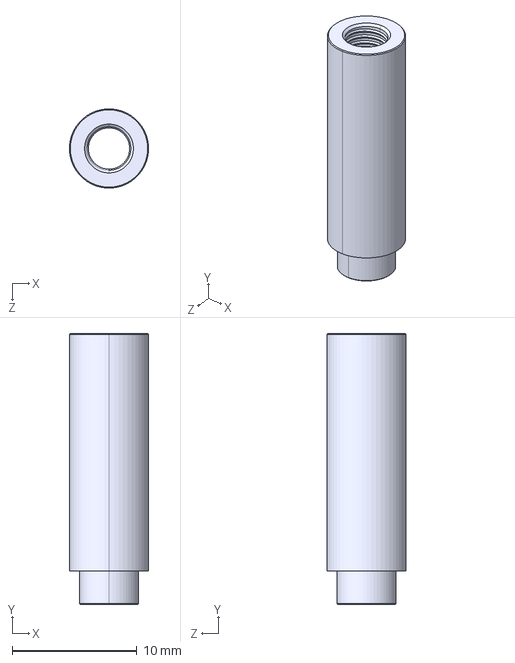
[picture p12: CAD file, 2018-05-01]
SolidModels/keystone-PN1608-2.STEP
6.35 x 21.7 x 6.35 mm
