rlhahn/power_distro/SolidModels/power_distro_pcb_RevB.STEP

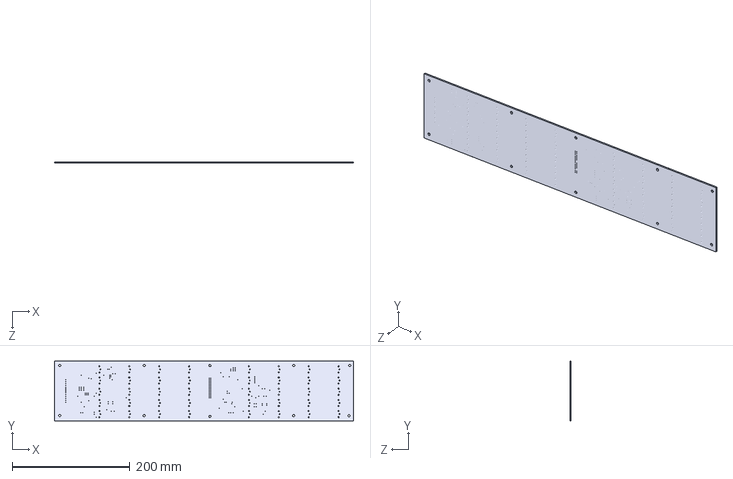
[picture p13: CAD file, 2018-05-01]
SolidModels/power_distro_pcb_RevB.STEP
508.0 x 101.6 x 2.36 mm
