rlhahn/power_distro/SolidModels/keystone-PN8425.STEP

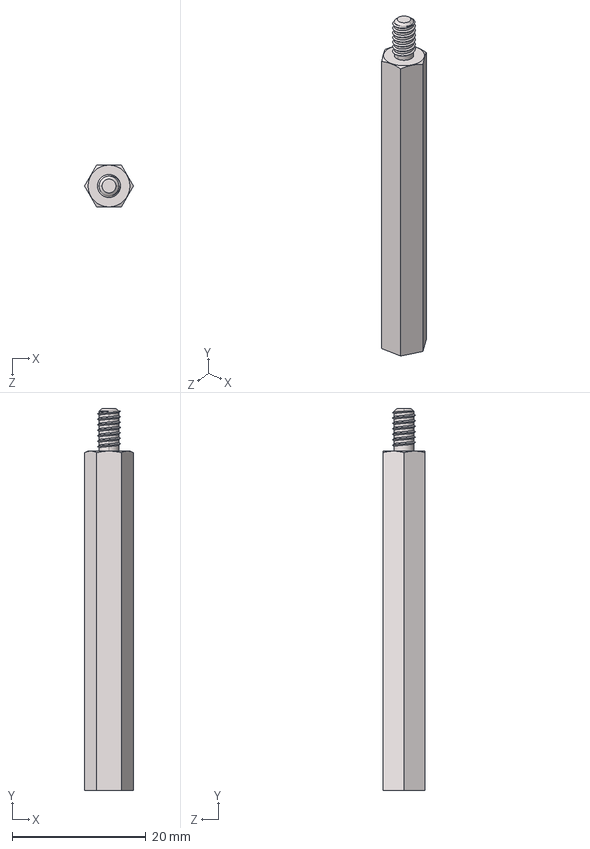
[picture p14: CAD file, 2018-05-01]
SolidModels/keystone-PN8425.STEP
7.33 x 57.1 x 6.35 mm
