rlhahn/power_distro/SolidModels/keystone-PN4701.STEP

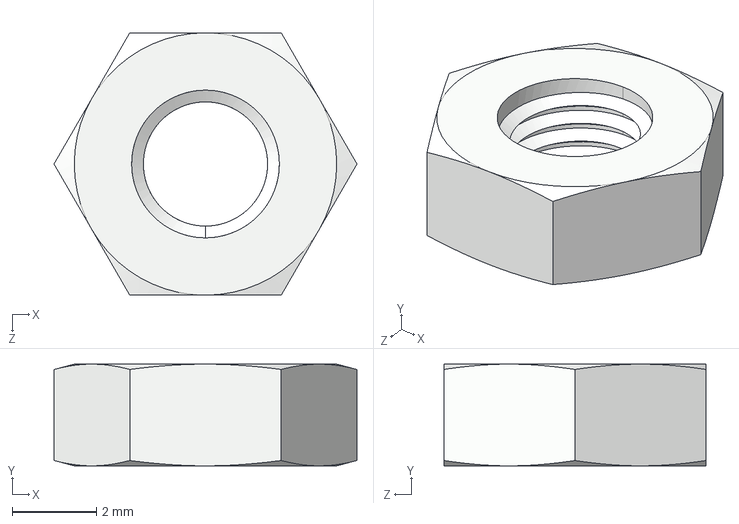
[picture p15: CAD file, 2018-05-01]
SolidModels/keystone-PN4701.STEP
7.19 x 2.41 x 6.22 mm
