rlhahn/power_distro/SolidModels/rcj-021_02.SLDPRT

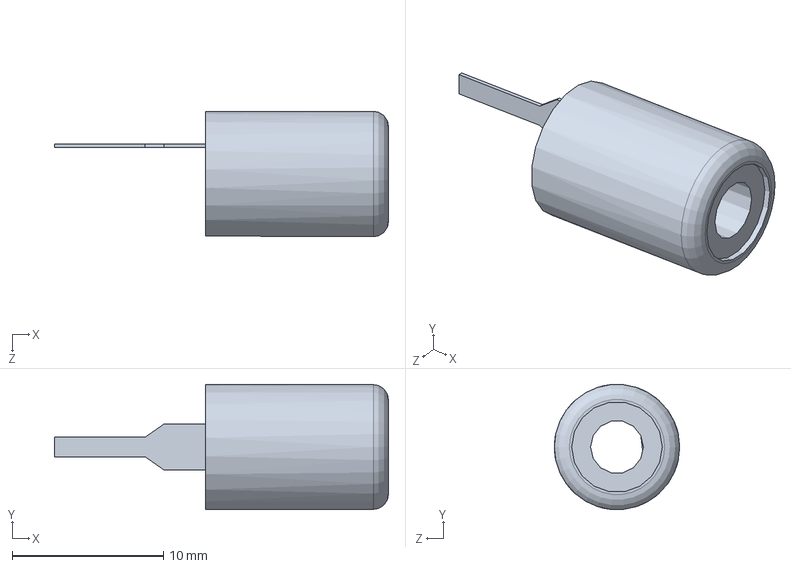
[picture p16: CAD file, 2017-11-18]
SolidModels/rcj-021_02.SLDPRT
22.1 x 8.28 x 8.30 mm
