rlhahn/power_distro/SolidModels/rcj-022.stp

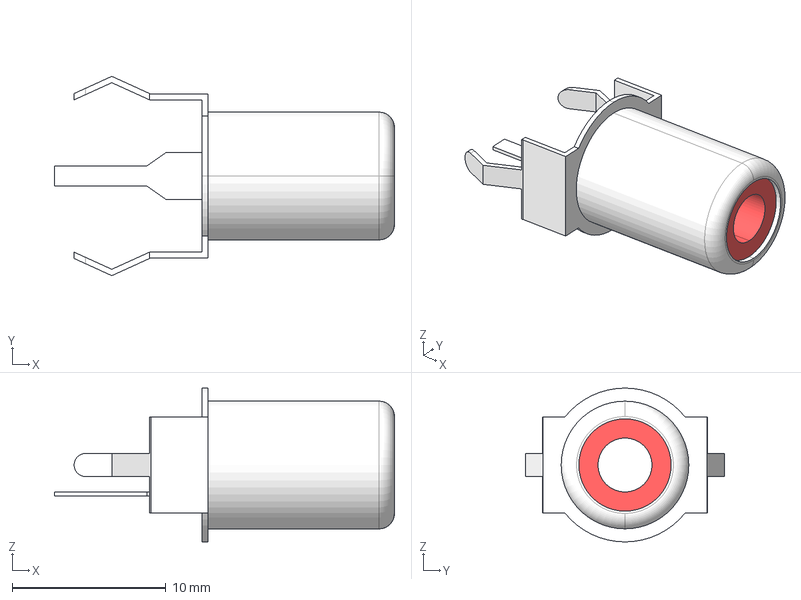
[picture p17: CAD file, 2017-11-18]
SolidModels/rcj-022.stp
22.1 x 13.0 x 10.0 mm
