rlhahn/power_distro/SolidModels/rcj-021_01.SLDPRT

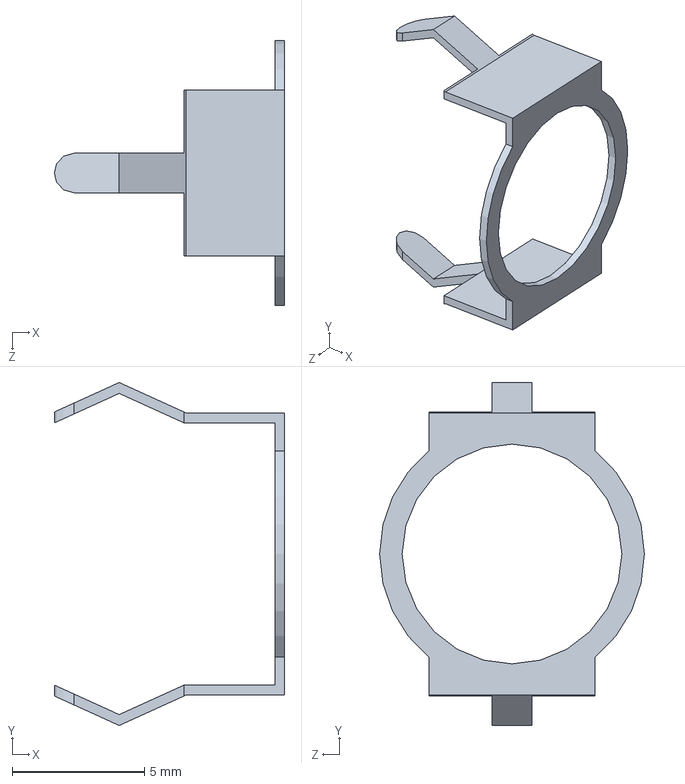
[picture p18: CAD file, 2017-11-18]
SolidModels/rcj-021_01.SLDPRT
8.70 x 13.0 x 10.0 mm
