rlhahn/power_distro/(list of files, cad)

Other CAD files:
SolidModels/Enclosure2_RevB_Outer.dwg
SolidModels/Enclosure2_RevB_Inner-1.dwg
SolidModels/power_distro_pcb.SLDPRT
SolidModels/rcj-021.stp
SolidModels/3_5MM_TO_5_08MM_ADAPTOR_PCB.ipt
SolidModels/6-32x0,25 Nut.ipt
SolidModels/6-32x0.25 Slotted Flathead.ipt
SolidModels/AAVID_7106.ipt
SolidModels/Enclosure2_RevB_Inner.ipt
SolidModels/Enclosure2_RevB_Outer.ipt
SolidModels/Enclosure_RevB.ipt
SolidModels/Enclosure_RevB_Bottom.ipt
SolidModels/NORDEX-DJX-B4-3.ipt
SolidModels/OST_EDSTLZ950-12.ipt
SolidModels/OST_OSTJ125153.ipt
SolidModels/Phoenix_1757349.ipt
SolidModels/Phoenix_1945193.ipt
SolidModels/PowerDistroAssembly.iam
SolidModels/PowerDistroAssembly_RevB.iam
SolidModels/keystone-PN1608-2.ipt
SolidModels/keystone-PN8425.ipt
SolidModels/power_distro_pcb_RevB.ipt
SolidModels/pxc_1781085_03_MSTBT-2-5-12-ST-5-08_3D.ipt
SolidModels/rcj-021.SLDASM
SolidModels/rcj-021.iam
SolidModels/rcj-021.ipt
SolidModels/rcj-021_01.ipt
SolidModels/rcj-021_02.ipt
