rlhahn/power_distro/Gerbers/POWER_DISTRO.pdf

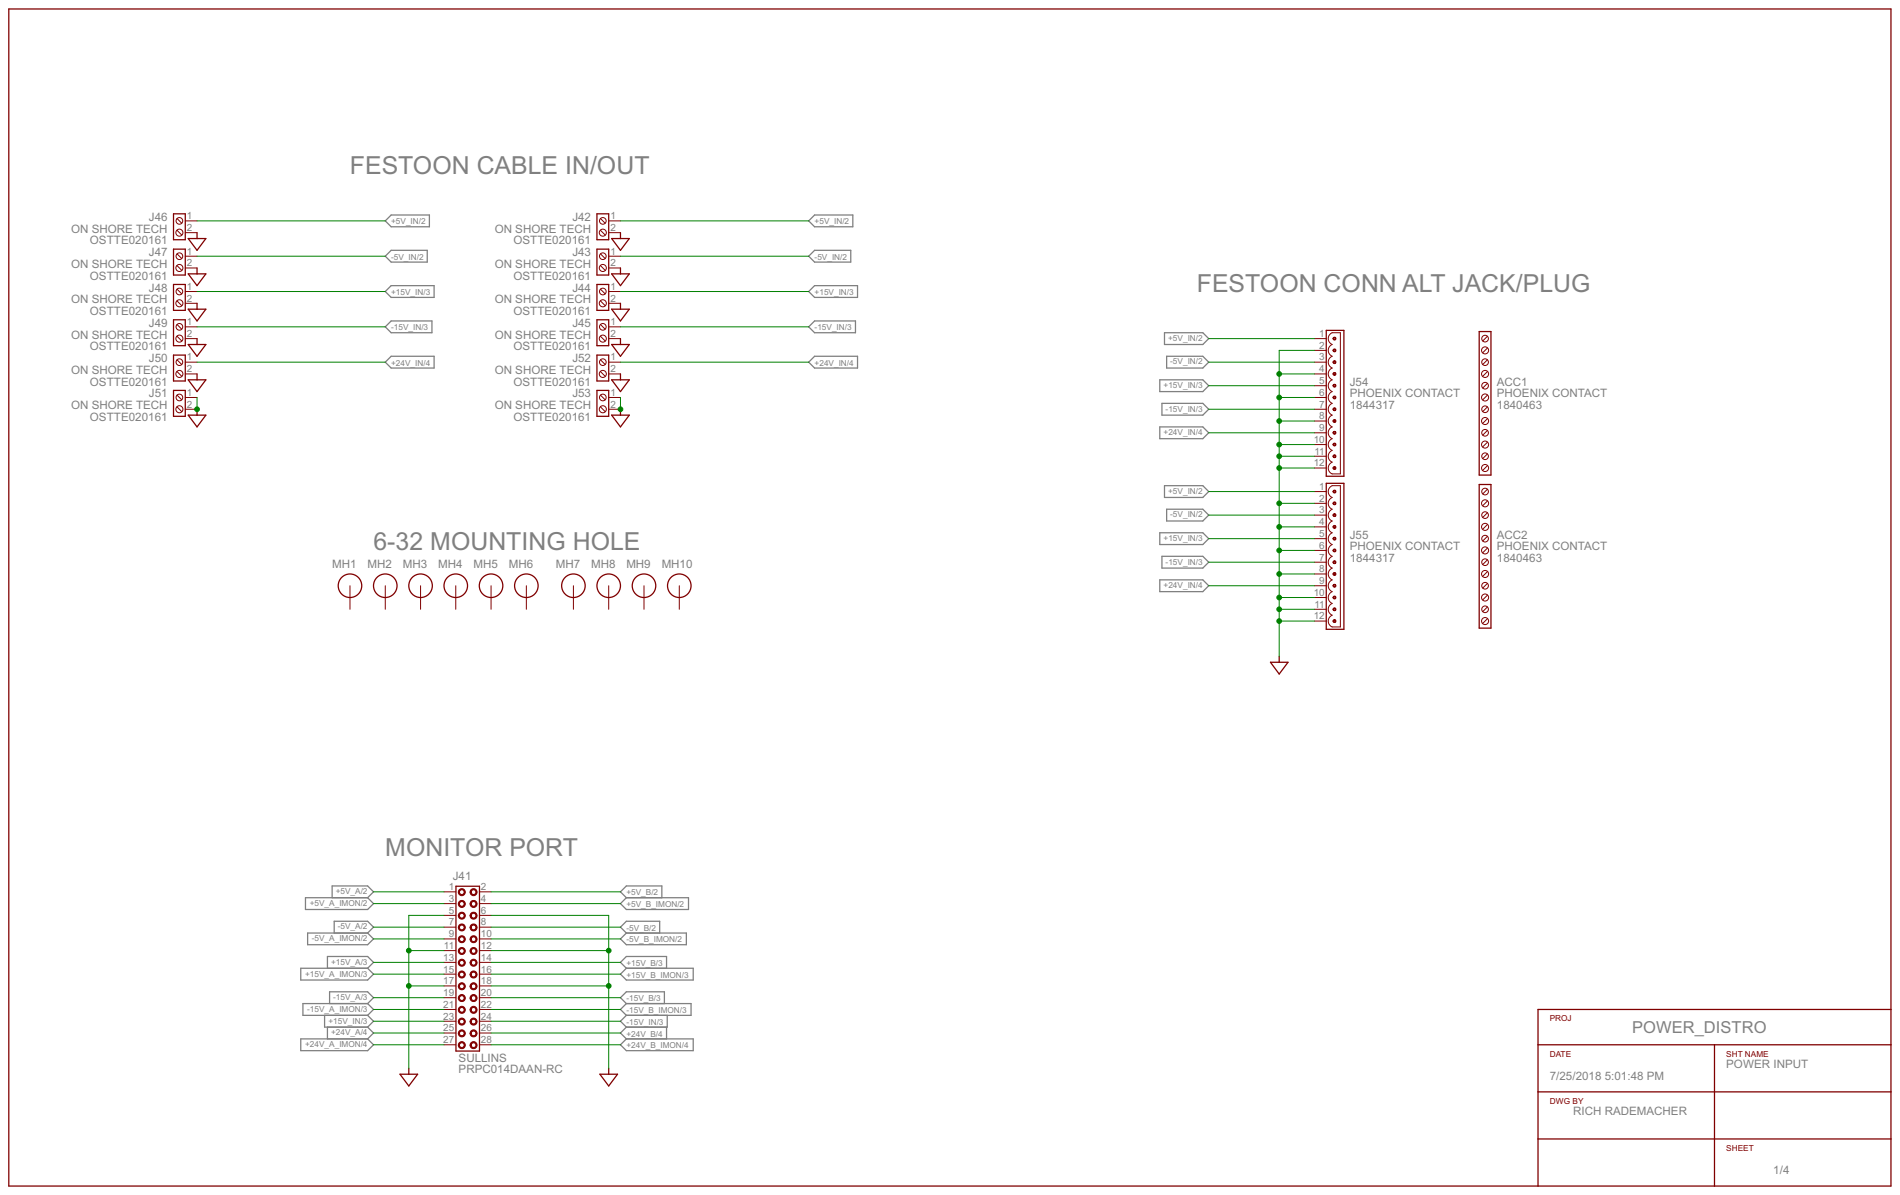
[picture p19: page 1]

FESTOON CABLE IN/OUT

FESTOON CONN ALT JACK/PLUG

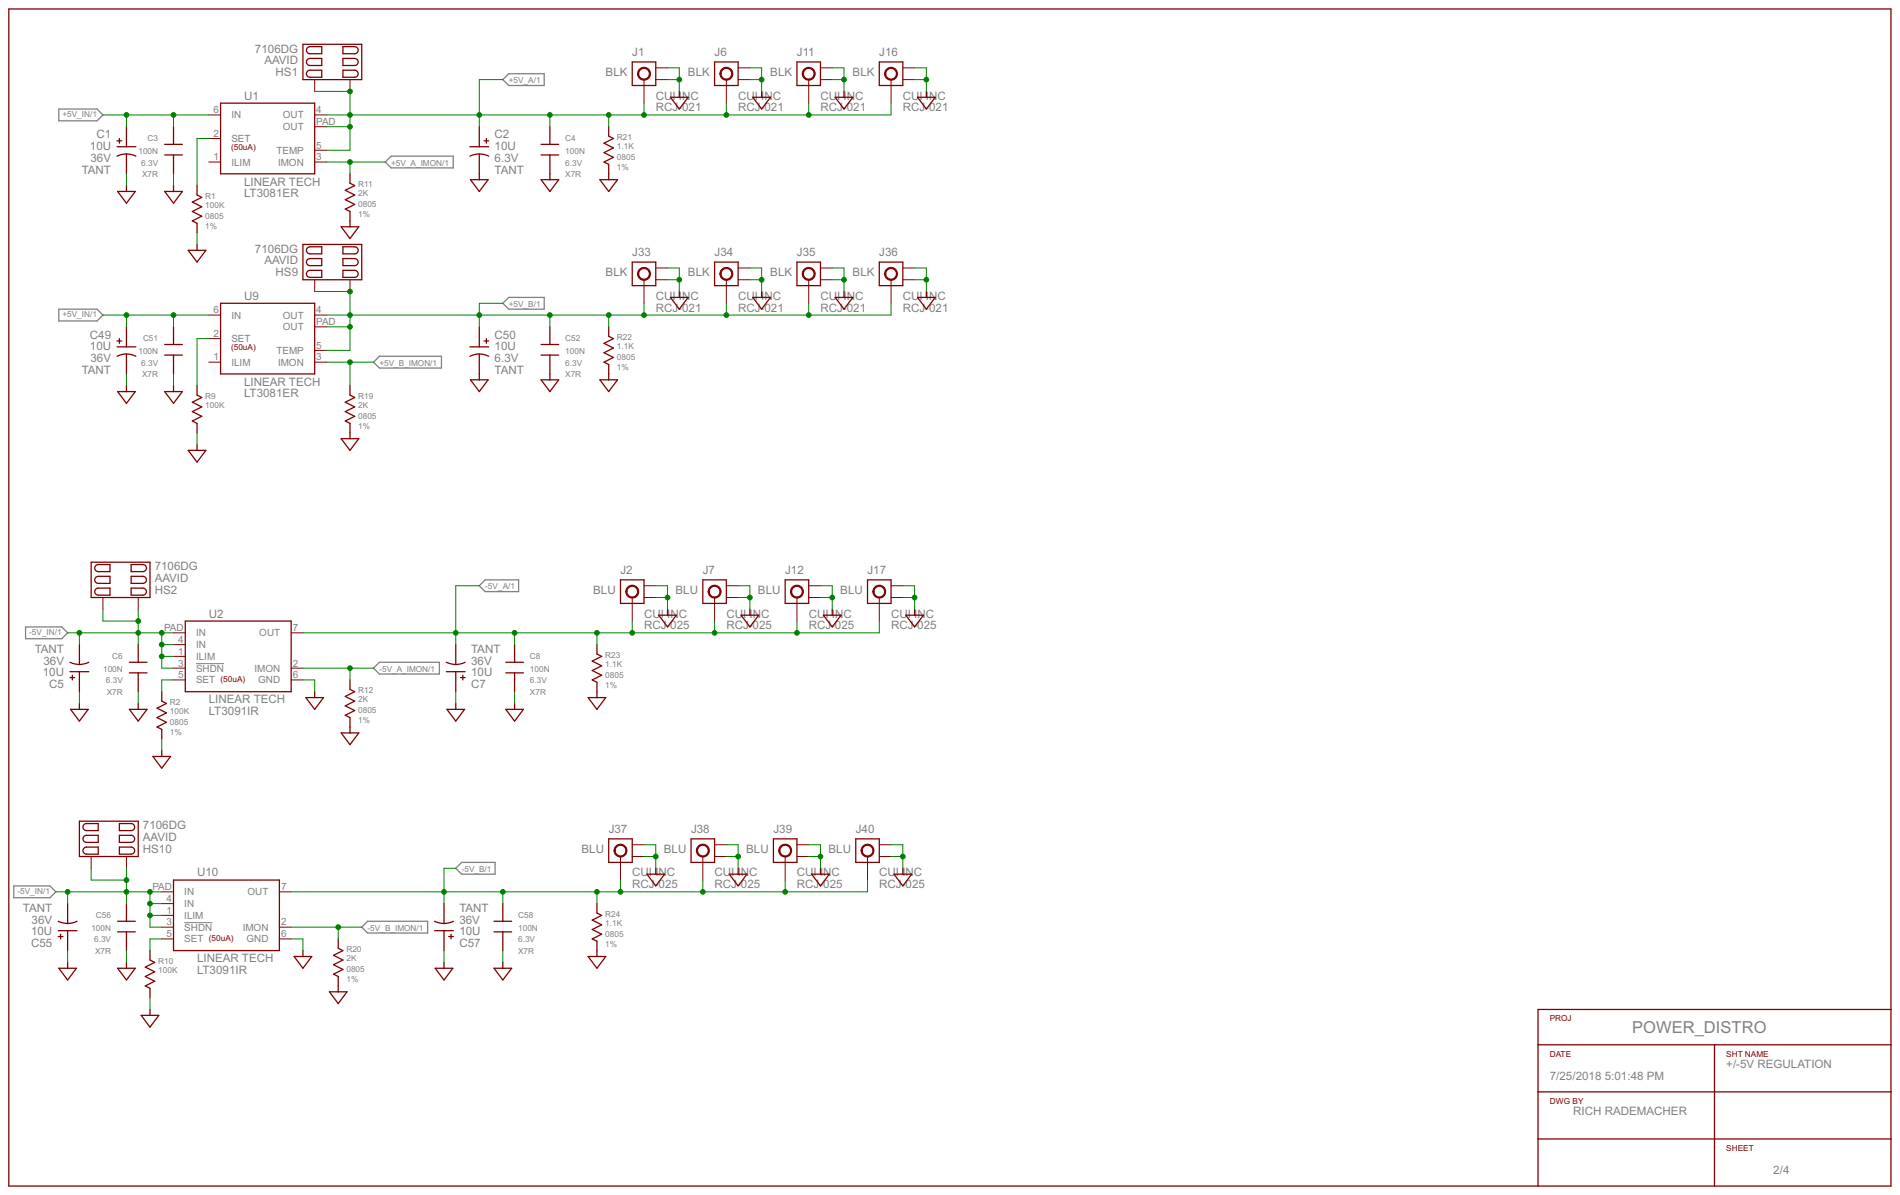
[picture p20: page 2]

DATE 7/25/2018 5:01:48 PM | SHT NAME +/-5V REGULATION

RICH RADEMACHER | SHEET DWG BY

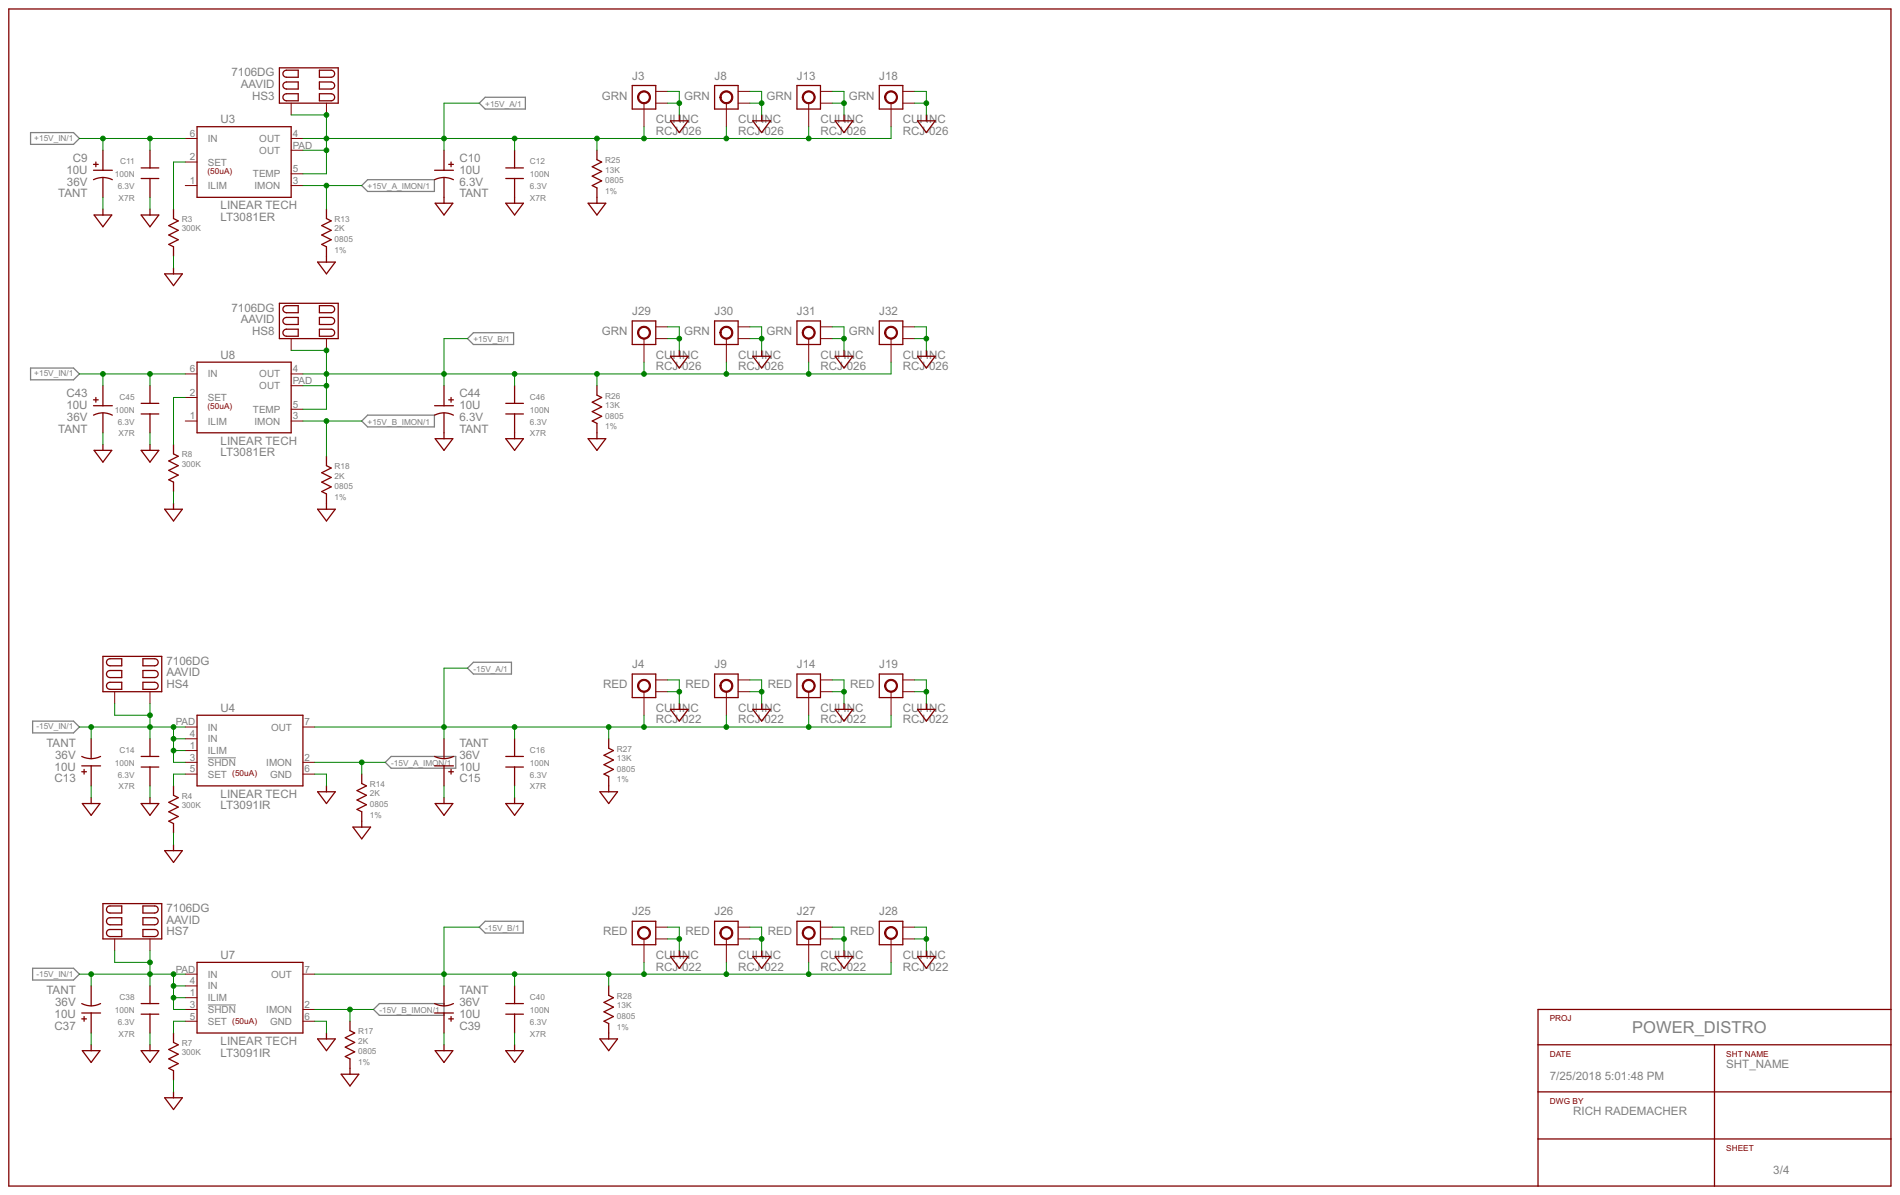
[picture p21: page 3]

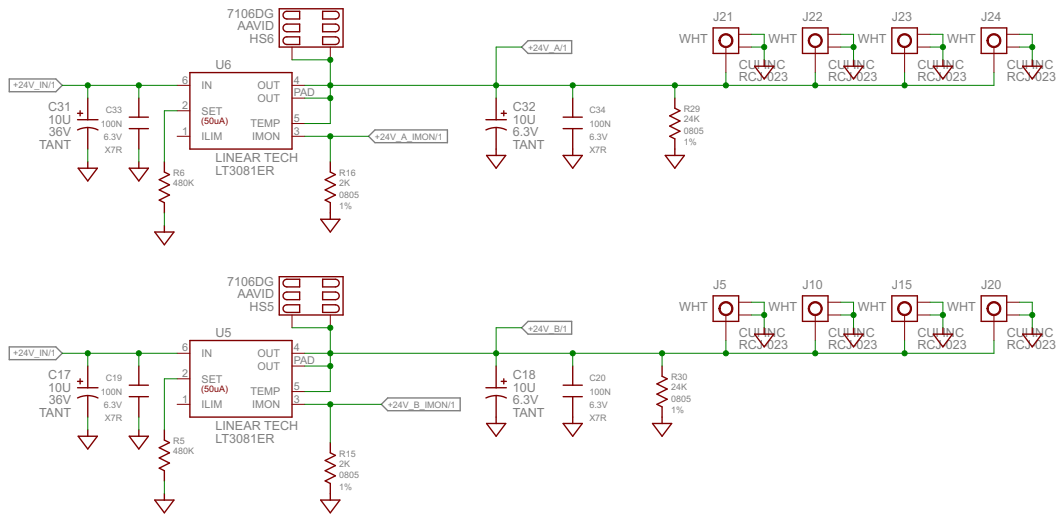
[picture p22: page 4]

DATE 7/25/2018 5:01:48 PM | SHT NAME SHT_NAME

RICH RADEMACHER | SHEET DWG BY
