rlhahn/power_distro/(commit log)

2018-02-18 as-builts Rev A
    [IonTrapPowerDistroBOM-1-25-2018.xlsx]
2018-03-08 Added Lab Power Distribution System Design.docx
2018-04-19 updates prior to rev B
    [POWER_DISTRO.brd, POWER_DISTRO.sch]
2018-04-20 Rev B
    [IonTrapPowerDistroBOM-4-19-2018.xlsx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]
2018-04-30 added subassembly parts
    [AAVID_7106.ipt, Enclosure_RevB.ipt, Enclosure_RevB_Bottom.ipt, POWER_DISTRO.sch, PowerDistroAssembly.iam, keystone-PN1608-2.ipt, power_distro_pcb.SLDPRT, power_distro_pcb_RevB.ipt]
2018-05-01 Updates to enclosure
    [Enclosure2_RevB_Inner.ipt, Enclosure2_RevB_Outer.ipt, HolePattern.dxf, NORDEX-DJX-B4-3.ipt, PowerDistroAssembly_RevB.iam, keystone-PN1608-2.STEP, keystone-PN4701.STEP, keystone-PN8425.STEP]
2018-05-02 Finished assembly
    [6-32x0,25 Nut.ipt, 6-32x0.25 Slotted Flathead.ipt, PowerDistroAssembly_RevB.iam]
2018-05-11 Updated RevB inner
    [Enclosure2_RevB_Inner.ipt, Enclosure2_RevB_Outer.ipt]
2018-06-27 Created new BOM and gerbers and Solidmodels
    [6-32x0.25 Slotted Flathead.ipt, Enclosure2_RevB_Inner.ipt, Enclosure2_RevB_Outer.ipt, HolePattern.dxf, IonTrapPowerDistroBOM_RevB-6-25-2018.xlsx, POWER_DISTRO.brd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]
2018-06-28 Redraw Enclosure to fit new Rev B board
    [Enclosure2_RevB_Inner-1.dwg, Enclosure2_RevB_Inner.ipt, Enclosure2_RevB_Outer.dwg, Enclosure2_RevB_Outer.ipt, PowerDistroAssembly_RevB.iam]
2018-07-26 Gerbers committed to order REV B
    [POWER_DISTRO.bmask.gbr, POWER_DISTRO.botsilk.gbr, POWER_DISTRO.l15.gbr, POWER_DISTRO.ly1.gbr, POWER_DISTRO.ly16.gbr, POWER_DISTRO.ly2.gbr, POWER_DISTRO.tmask.gbr, POWER_DISTRO.topsilk.gbr]
2018-07-26 Enclosure design for purchase at xometry
    [Enclosure2_RevB_Outer.dwg, Enclosure2_RevB_Outer.ipt, PowerDistroAssembly_RevB.iam]
2018-08-12 updates to eagle files
    [POWER_DISTRO.brd, POWER_DISTRO.sch]
2018-09-24 ADDED PHOENIX CONTACT 1X12X3.5MM HEADER
2018-09-24 ADDED 3_5mm_5_08mm_adapter.sch
    [3_5mm_5_08mm_adapter.sch]
2018-09-24 COMPLETED SCHEMATIC
    [3_5mm_5_08mm_adapter.sch]
2018-11-13 Updates to 3.5mm adaptor
    [3_5mm_5_08mm_adapter.sch, Enclosure2_RevB_Inner.ipt, Enclosure2_RevB_Outer.ipt, PowerDistroAssembly_RevB.iam]
2018-11-13 Updates for 3.5mm_to_5.08mm adapter. Updates to Inventor model accordingly. Added zip files for gerbers
    [3_5MM_TO_5_08MM_ADAPTOR_PCB.ipt, 3_5mm_5_08mm_adapter.dxf, OST_EDSTLZ950-12.ipt, OST_OSTJ125153.ipt, Phoenix_1757349.ipt, Phoenix_1945193.ipt, PowerDistroAssembly_RevB.iam, pxc_1781085_03_MSTBT-2-5-12-ST-5-08_3D.ipt]
